djupdal/asd-amp/asd_pre_1/pcb/preamp.ods

Kjøpt | Antall | Reference | Value | Footprint | Note
x | 39 | C1 | 100n | Capacitors_SMD:C_0603_HandSoldering
x | 9 | C3 | 1u | Capacitors_SMD:C_0805_HandSoldering
x | 4 | C4 | 12p | Capacitors_SMD:C_0603_HandSoldering
x | 12 | C10 | 10u | Capacitors_SMD:C_0805_HandSoldering
x | 7 | C11 | 22u | Capacitors_SMD:C_0805_HandSoldering
x | 1 | C16 | 4.7n | Capacitors_SMD:C_0603_HandSoldering
x | 1 | C19 | 68n | Capacitors_SMD:C_0603_HandSoldering
x | 1 | C32 | 33u | Capacitors_SMD:C_1210_HandSoldering
x | 1 | C33 | 3.3u | Capacitors_SMD:C_0805_HandSoldering
x | 4 | C34 | 1n | Capacitors_SMD:C_0603_HandSoldering | NP0
x | 4 | C38 | 390p | Capacitors_SMD:C_0603_HandSoldering | NP0
x | 2 | C42 | 2.2n | Capacitors_SMD:C_0603_HandSoldering | NP0
x | 2 | C47 | 6.8n | Capacitors_SMD:C_0603_HandSoldering | 10%
x | 10 | C49 | 10n | Capacitors_SMD:C_0603_HandSoldering
x | 2 | C56 | 1n | Capacitors_SMD:C_0603_HandSoldering
x | 1 | C60 | 330u | Capacitors_Tantalum_SMD:TantalC_SizeD_EIA-7343_HandSoldering
x | 5 | C61 | 100u | Capacitors_Tantalum_SMD:TantalC_SizeB_EIA-3528_HandSoldering
x | 4 | C62 | 47u | Capacitors_SMD:C_1210_HandSoldering
x | 12 | C65 | 4.7u | Capacitors_SMD:C_0805_HandSoldering
x | 21 | C66 | 470n | Capacitors_SMD:C_0603_HandSoldering
x | 2 | C98 | 22p | Capacitors_SMD:C_0603_HandSoldering
x | 1 | C105 | 3.3n | Capacitors_SMD:C_0603_HandSoldering
x | 2 | C107 | 330n | Capacitors_SMD:C_0603_HandSoldering
x | 4 | C131 | 470p | Capacitors_SMD:C_0603_HandSoldering | NP0
x | 2 | C135 | 2.7n | Capacitors_SMD:C_0603_HandSoldering | NP0
x | 3 | L1 | FERRITE BEAD | Resistors_SMD:R_0805_HandSoldering
x | 2 | L4 | 1.5u | pre:SPM3015 | Ip>2.8A
x | 1 | L6 | 2.2u | pre:SPM3015 | Ip>2.9A
x | 1 | P1 | MCU Debug | Pin_Headers:Pin_Header_Straight_2x10
x | 1 | P2 | Buttons | Pin_Headers:Pin_Header_Straight_2x04
x | 1 | P3 | Mute | Pin_Headers:Pin_Header_Straight_1x02
x | 1 | P4 | LEDs | Pin_Headers:Pin_Header_Straight_2x03
x | 1 | P5 | SD_Card_DM1 | pre:DM1AA-SF-PEJ
x | 1 | P6 | Volume | Pin_Headers:Pin_Header_Straight_1x03
x | 1 | P7 | SPDIF | pre:RCA
x | 1 | P8 | TOSLINK | pre:PLR135T
x | 1 | P11 | RJ45-MAGJACK | pre:08B0-1D1T-06-F
x | 1 | P12 | FPGA Debug | pre:FPGA_debug
x | 1 | P13 | PwGnd | pa:Terminal_Block_3_5mm | +15VGnd-15V
x | 4 | P15 | LIN | pa:Terminal_Block_2_2.5mm
x | 7 | R1 | 4.7k | Resistors_SMD:R_0805_HandSoldering
x | 7 | R3 | 10k | Resistors_SMD:R_0805_HandSoldering
x | 7 | R8 | 91 | Resistors_SMD:R_0805_HandSoldering
x | 6 | R10 | 47k | Resistors_SMD:R_0805_HandSoldering
x | 4 | R13 | 22 | Resistors_SMD:R_0805_HandSoldering
x | 1 | R19 | 75 | Resistors_SMD:R_0805_HandSoldering
x | 1 | R21 | 680 | Resistors_SMD:R_0805_HandSoldering
x | 4 | R23 | 1.96k | Resistors_SMD:R_0805_HandSoldering
x | 4 | R27 | 2.15k | Resistors_SMD:R_0805_HandSoldering
x | 4 | R29 | 953 | Resistors_SMD:R_0805_HandSoldering
x | 2 | R35 | 549 | Resistors_SMD:R_0805_HandSoldering
x | 7 | R37 | 100k | Resistors_SMD:R_0805_HandSoldering
x | 1 | R38 | 12.4k | Resistors_SMD:R_0805_HandSoldering | 1%
x | 4 | R39 | 49.9 | Resistors_SMD:R_0805_HandSoldering | 1%
x | 1 | R43 | 10 | Resistors_SMD:R_0805_HandSoldering | 1% 1/12W
x | 2 | R44 | 180 | Resistors_SMD:R_0805_HandSoldering
x | 1 | R50 | 330 | Resistors_SMD:R_0805_HandSoldering
x | 1 | R52 | 30.1k | Resistors_SMD:R_0805_HandSoldering | 1%
x | 3 | R53 | 22.1k | Resistors_SMD:R_0805_HandSoldering | 1%
x | 1 | R54 | 6.81k | Resistors_SMD:R_0805_HandSoldering | 1%
x | 1 | R58 | 73.2k | Resistors_SMD:R_0805_HandSoldering | 1%
x | 4 | R60 | 3.3k | Resistors_SMD:R_0805_HandSoldering
x | 6 | R68 | 634 | Resistors_SMD:R_0805_HandSoldering
x | 1 | T1 | S22083 | pre:S22083
x | 1 | U1 | EFM32GG232F1024 | pre:QFP64
x | 1 | U2 | MAX3280E | pre:SOT-23-5
x | 1 | U3 | DIR9001 | Housings_SSOP:TSSOP-28_4.4x9.7mm_Pitch0.65mm
x | 1 | U4 | CS4398 | Housings_SSOP:TSSOP-28_4.4x9.7mm_Pitch0.65mm
x | 3 | U5 | LM4562 | SMD_Packages:SOIC-8-W
x | 1 | U6 | ENC424J600 | Housings_QFP:TQFP-44_10x10mm_Pitch0.8mm
x | 1 | U7 | N25Q128A | Housings_SOIC:SOIJ-8_5.3x5.3mm_Pitch1.27mm
x | 1 | U8 | oscillator | pre:OSC_SMD | 11.2896MHz
x | 1 | U9 | xc7a100tftg256 | pre:FTG256
x | 1 | U10 | LM2937-12 | pre:SOT-223
x | 1 | U11 | L79L12 | Housings_SOT-89:SOT89-3_Housing_Handsoldering
x | 1 | U12 | TPS54325 | pre:TSSOP-14_4.4x5mm_Pitch0.65mm_exposed_pad
x | 1 | U13 | TPS54294 | Housings_SSOP:TSSOP-16-1EP_4.4x5mm_Pitch0.65mm
x | 1 | U14 | L78L05 | Housings_SOT-89:SOT89-3_Housing_Handsoldering
x | 2 | U17 | SD103ASDM | pre:SOT-26-6
x | 1 | U19 | cs5361 | Housings_SSOP:TSSOP-24_4.4x7.8mm_Pitch0.65mm
x | 1 | X1 | 48MHz | pre:XTAL_SMD
x | 1 | X2 | 25MHz | pre:XTAL_SMD
