djupdal/asd-amp/asd_pa_1/poweramp.pdf

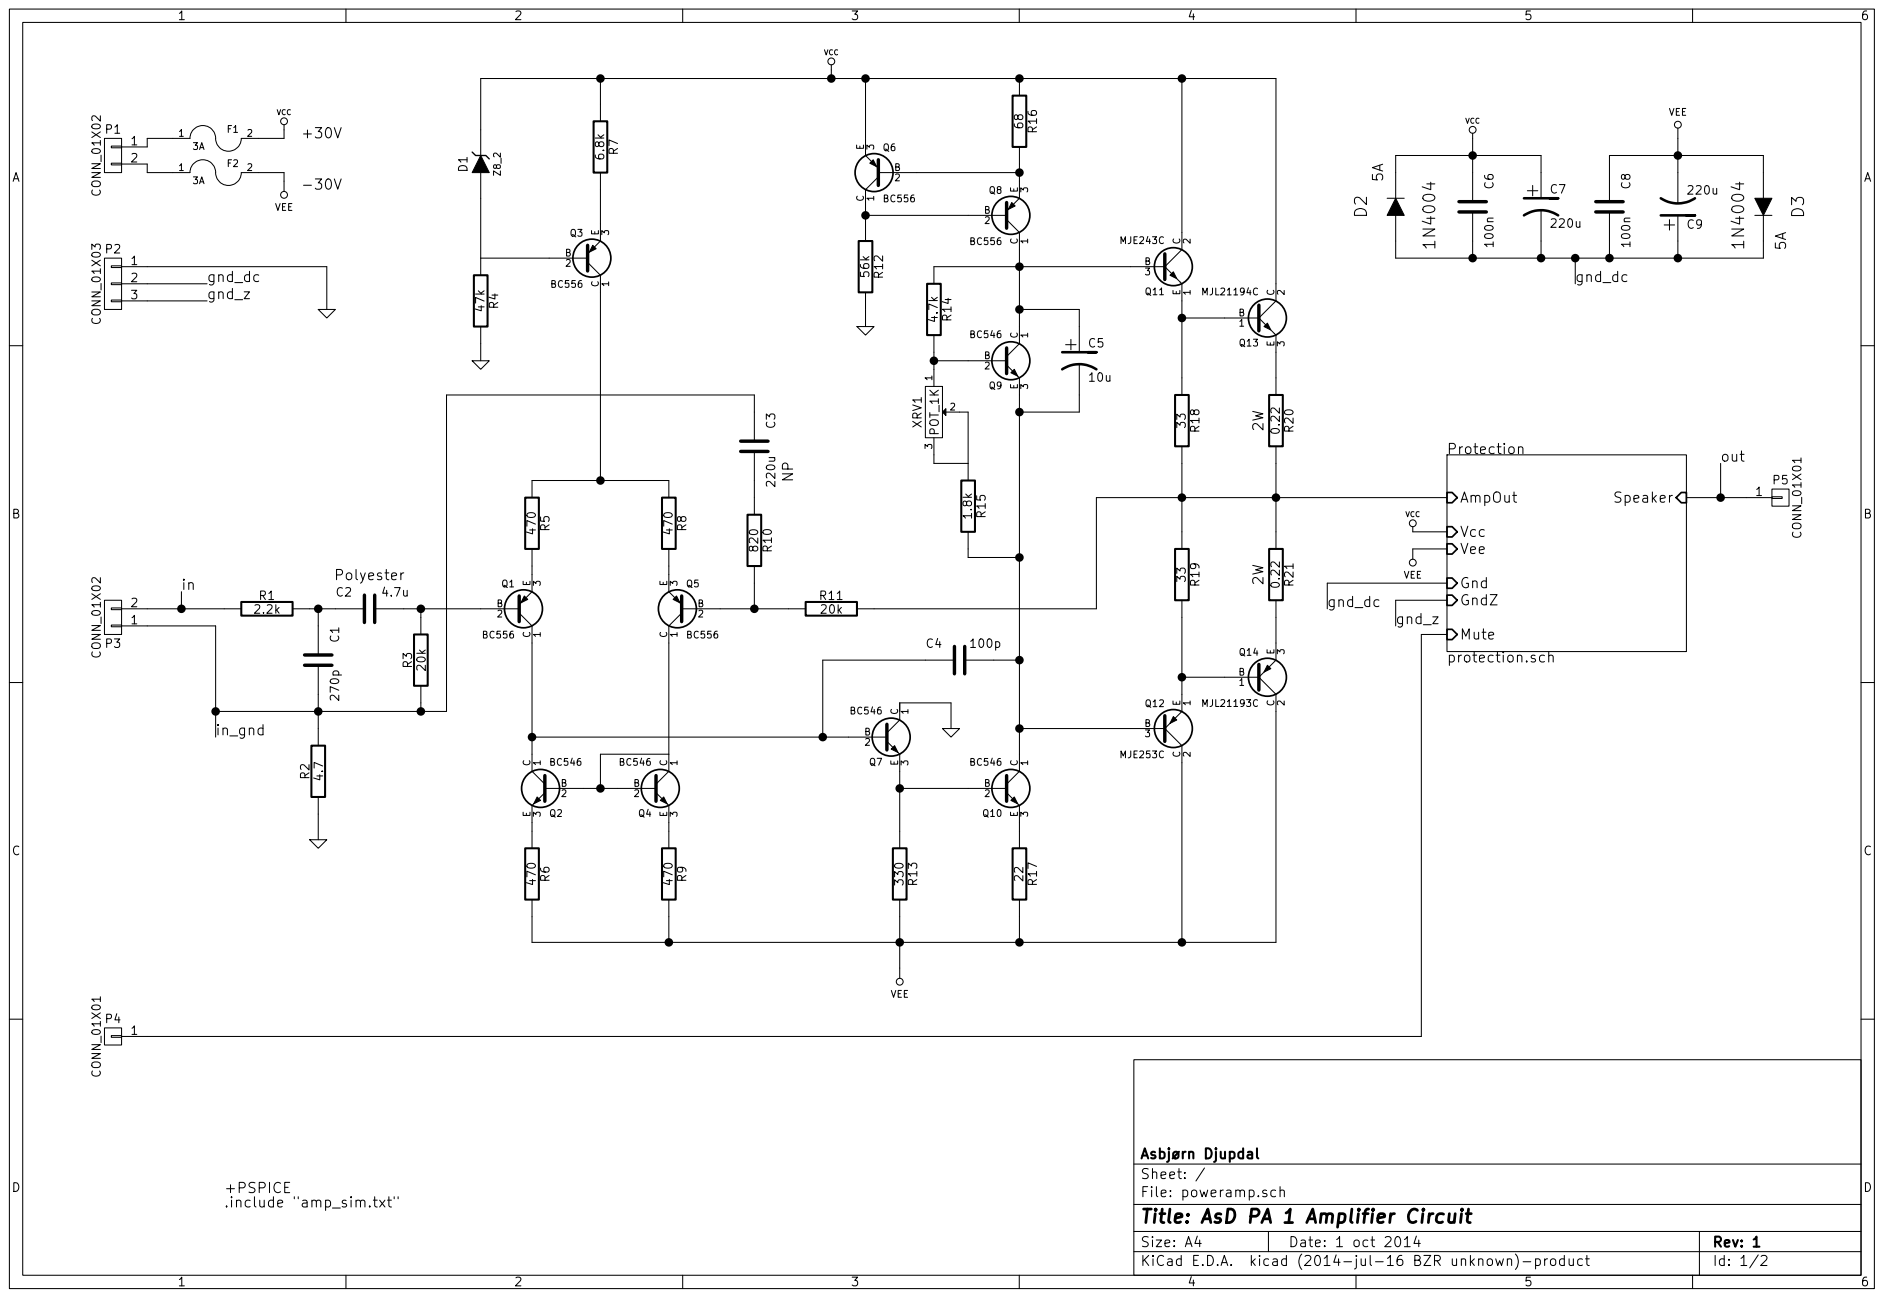
[picture p1: page 1]

File: poweramp.sch Sheet: / Asbjørn Djupdal

Id: 1/2 Title: AsD PA 1 Amplifier Circuit

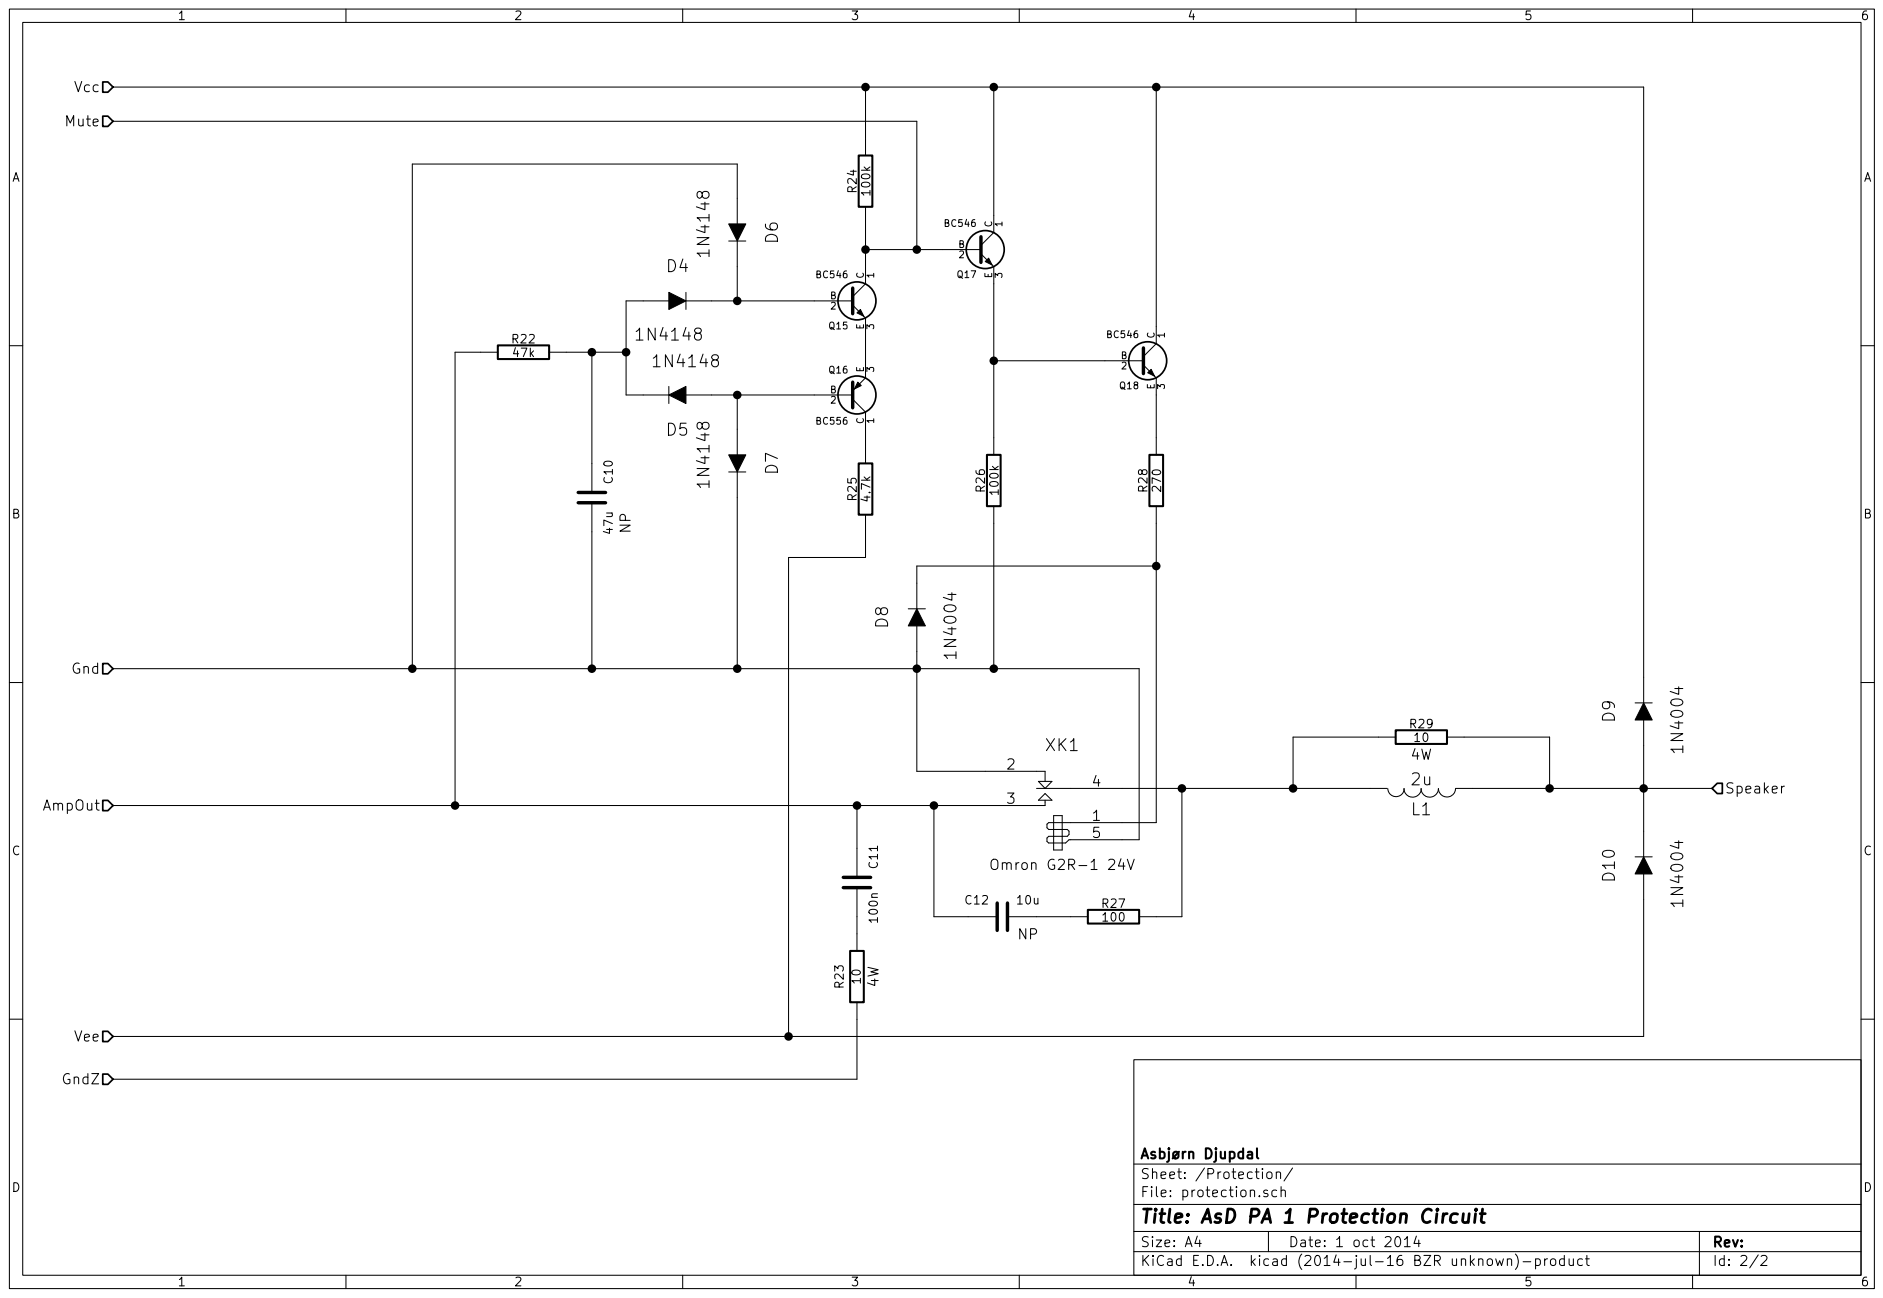
[picture p2: page 2]

Id: 2/2 Title: AsD PA 1 Protection Circuit
