djupdal/asd-amp/asd_pre_1/pcb/preamp.pdf

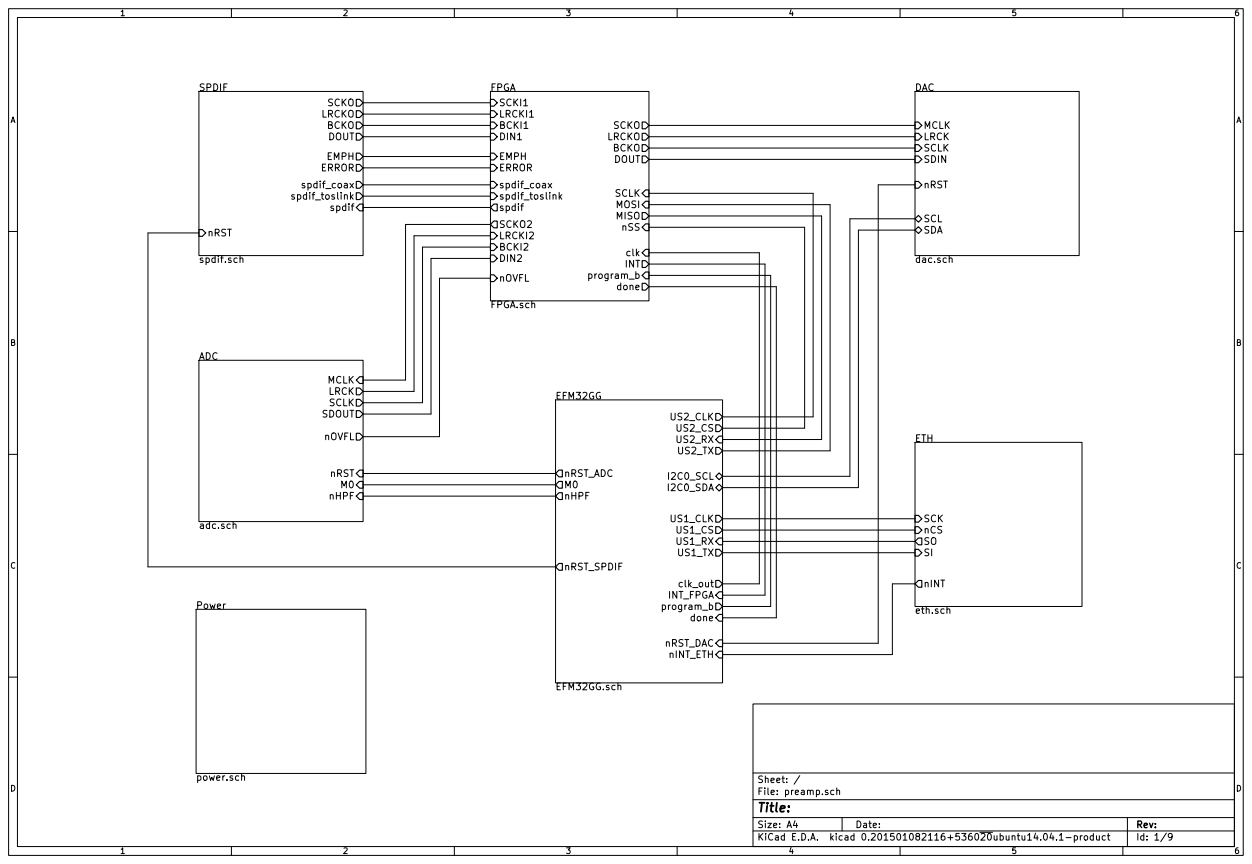
[picture p3: page 1]

File: preamp.sch Sheet: / EFM32GG

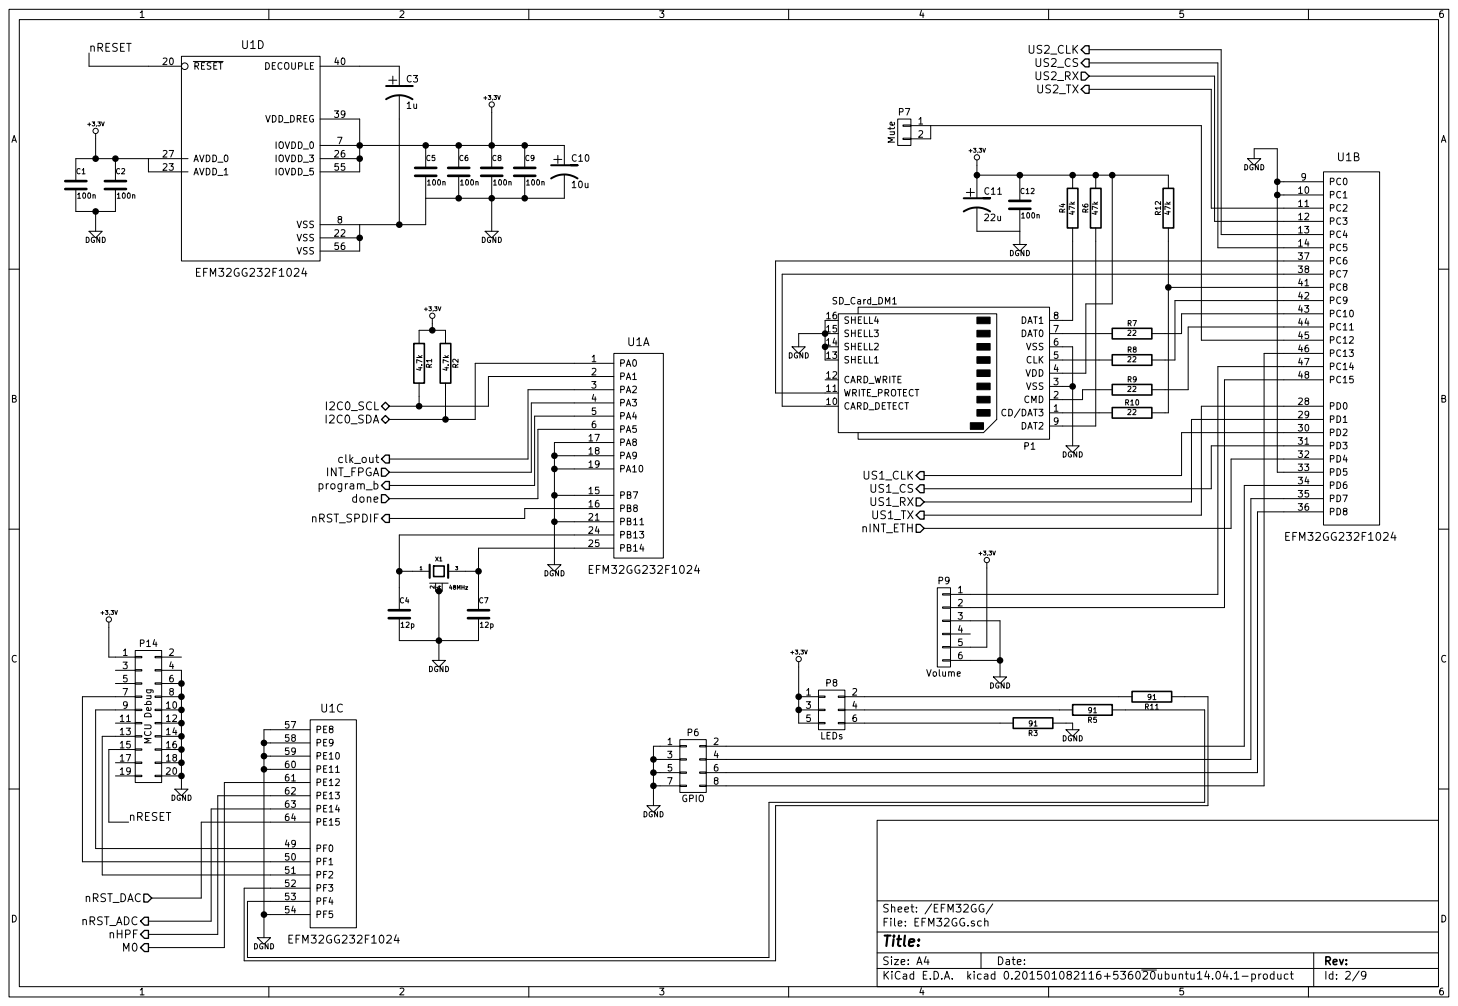
[picture p4: page 2]

9 | 10
11 | 12

Id: 2/9 Title: File: EFM32GG.sch Sheet: /EFM32GG/

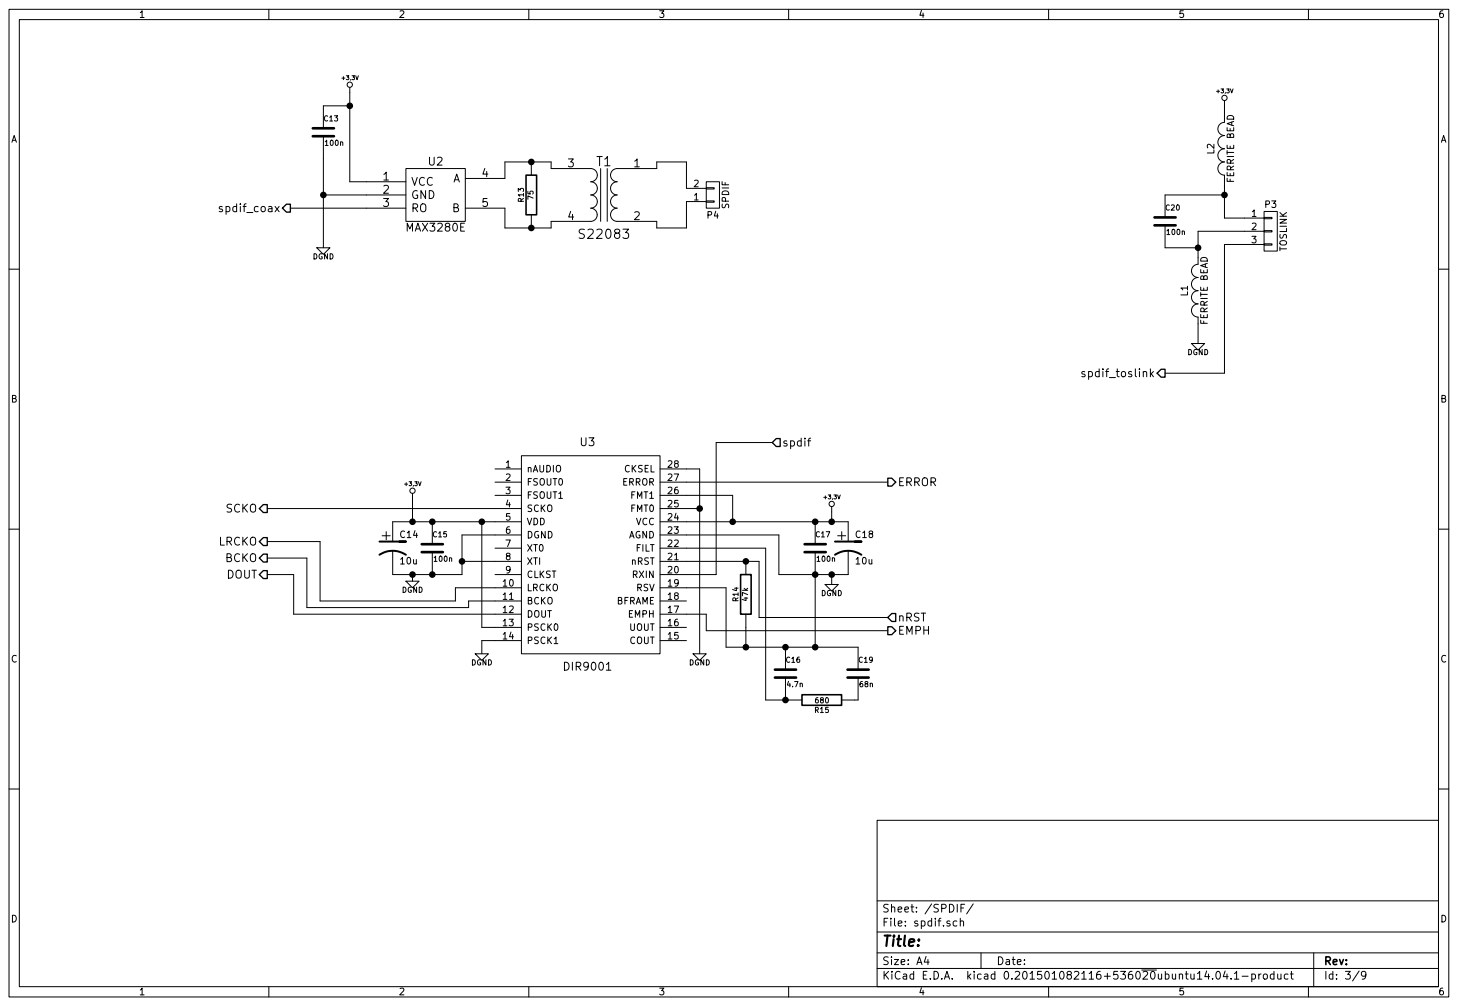
[picture p5: page 3]

File: spdif.sch Sheet: /SPDIF/
Id: 3/9 Title:

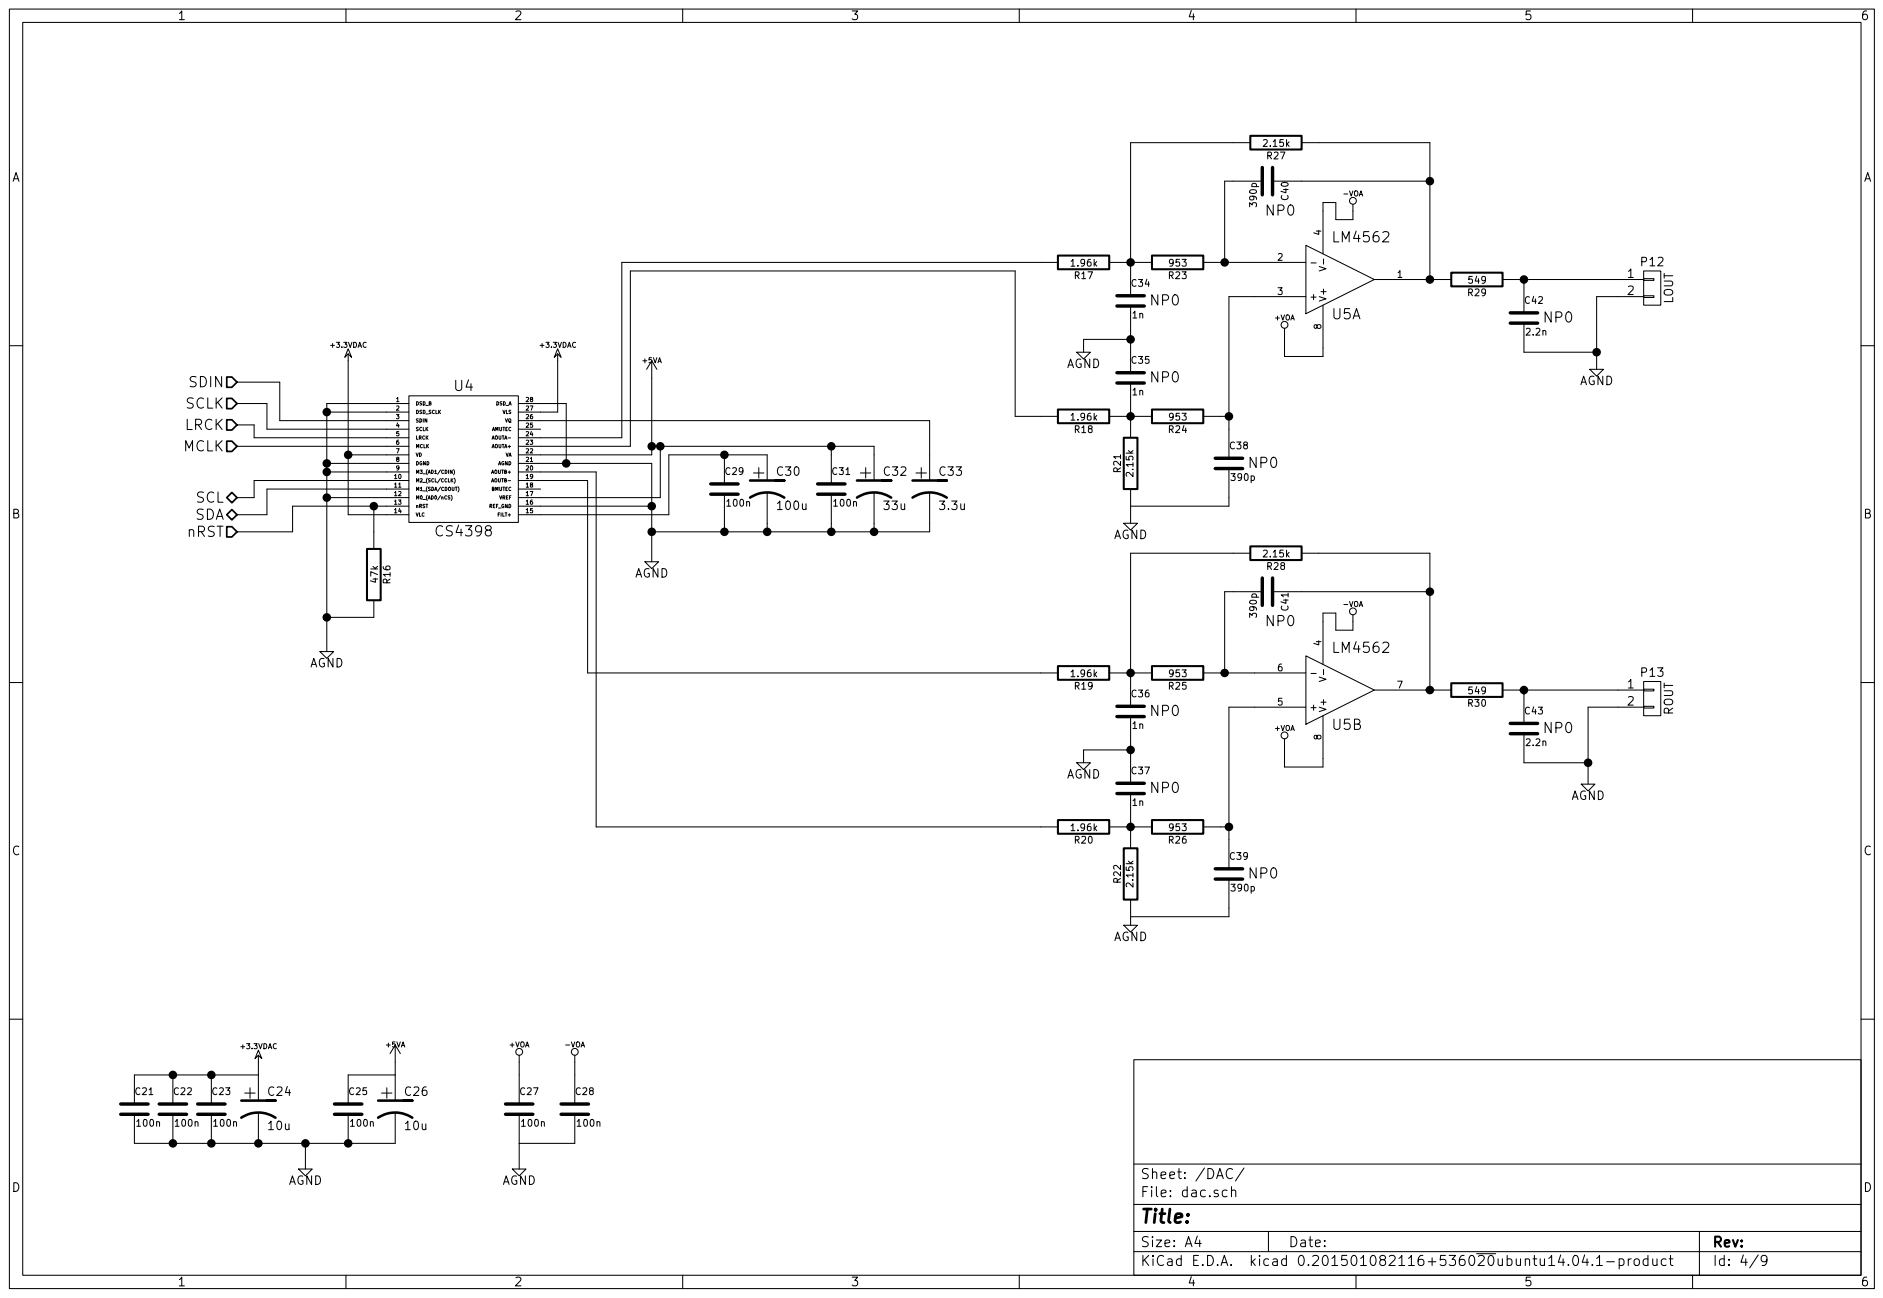
[picture p6: page 4]

Id: 4/9 Title: File: dac.sch Sheet: /DAC/

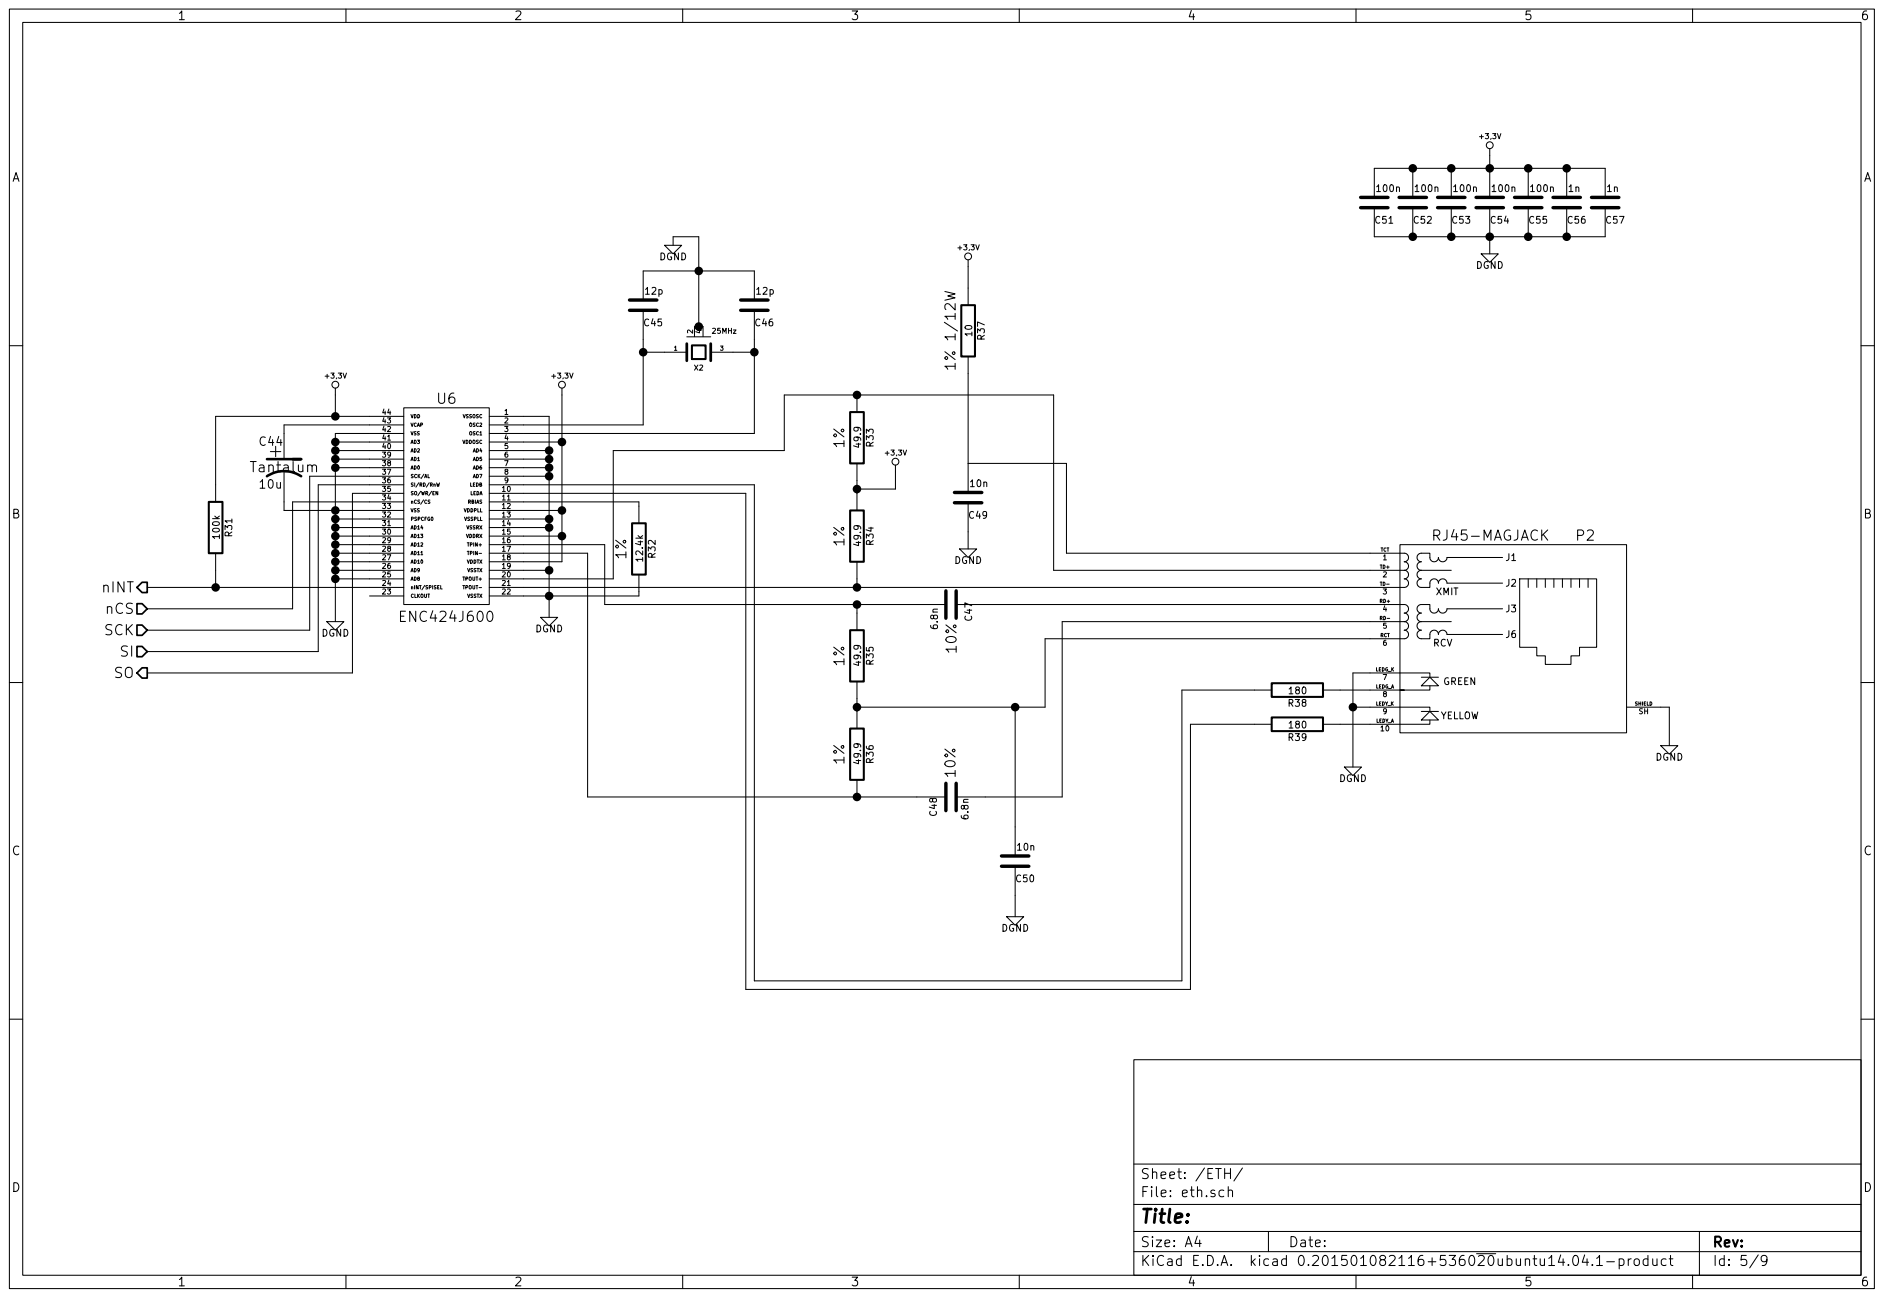
[picture p7: page 5]

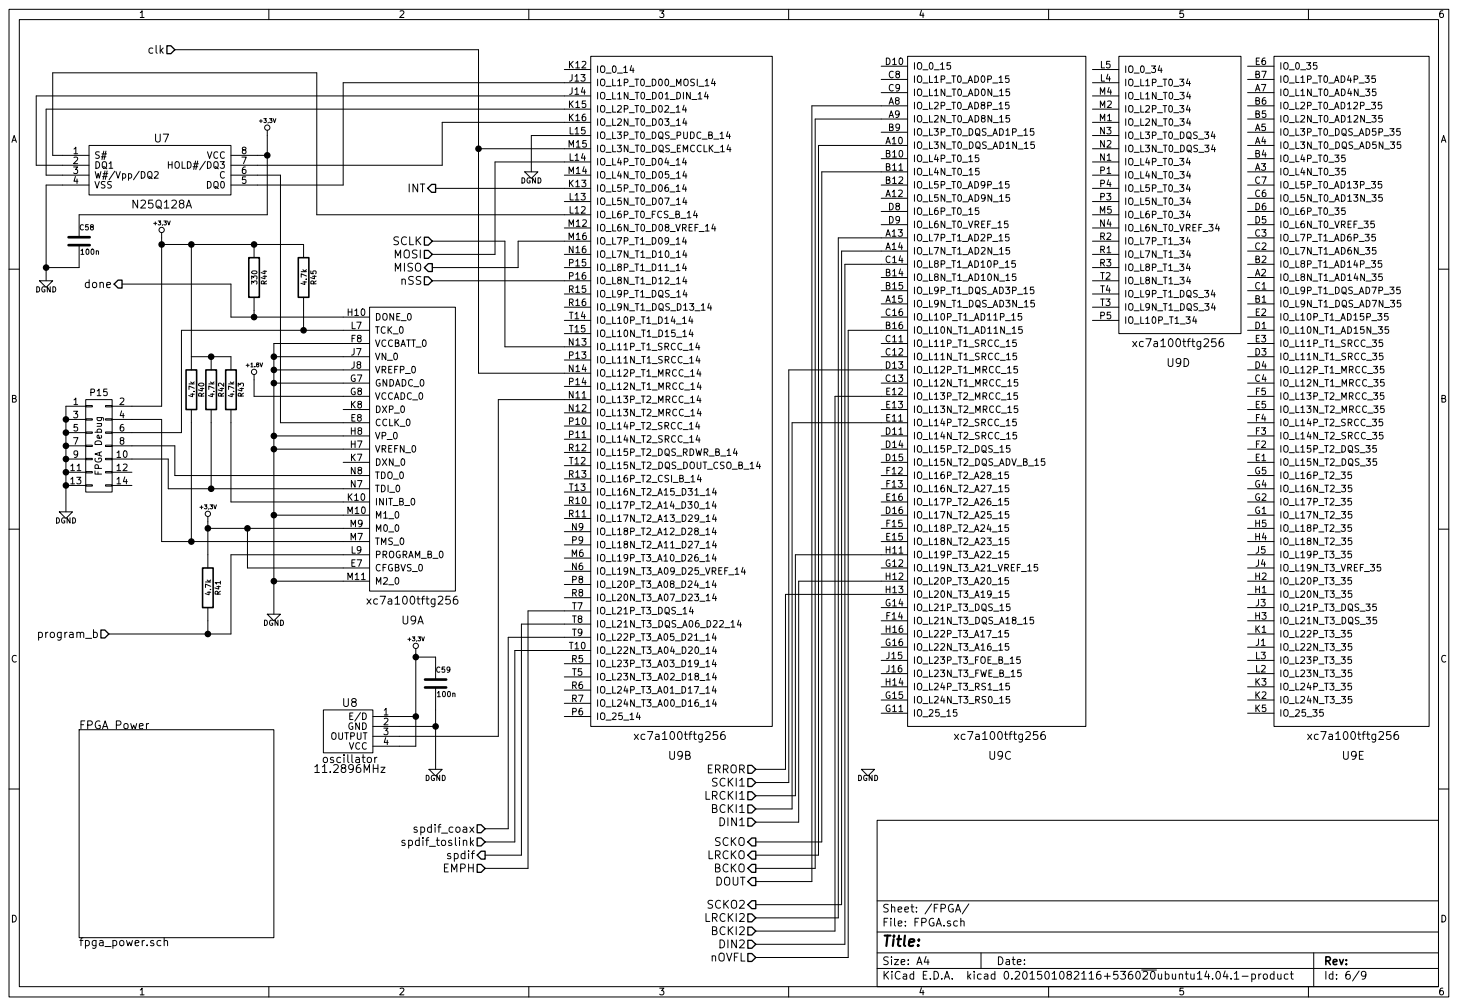
[picture p8: page 6]

IO_L11P_T1_SRCC_15 C11 | IO_L11P_T1_SRCC_35 E3

IO_L12P_T1_MRCC_15 D13 | IO_L12P_T1_MRCC_35 D4

IO_L13P_T2_MRCC_15 E12 | IO_L13P_T2_MRCC_35 F5

IO_L14P_T2_SRCC_15 E11 | IO_L14P_T2_SRCC_35 F4
IO_L14N_T2_SRCC_15 D11 | IO_L14N_T2_SRCC_35 F3

IO_L15N_T2_DQS_ADV_B_15 D15 | IO_L15N_T2_DQS_35 E1
IO_L16P_T2_A28_15 F12 | IO_L16P_T2_35 G5
IO_L16N_T2_A27_15 F13 | IO_L16N_T2_35 G4
IO_L17P_T2_A26_15 E16 | IO_L17P_T2_35 G2
IO_L17N_T2_A25_15 D16 | IO_L17N_T2_35 G1
IO_L18P_T2_A24_15 F15 | IO_L18P_T2_35 H5

IO_L19P_T3_A22_15 H11 | IO_L19P_T3_35 J5
IO_L19N_T3_A21_VREF_15 G12 | IO_L19N_T3_VREF_35 J4
IO_L20P_T3_A20_15 H12 | IO_L20P_T3_35 H2

IO_L21P_T3_DQS_15 G14 | IO_L21P_T3_DQS_35 J3

IO_L24P_T3_RS1_15 H14 | IO_L24P_T3_35 K3
IO_L24N_T3_RS0_15 G15 | IO_L24N_T3_35 K2
IO_25_15 G11 | IO_25_35 K5

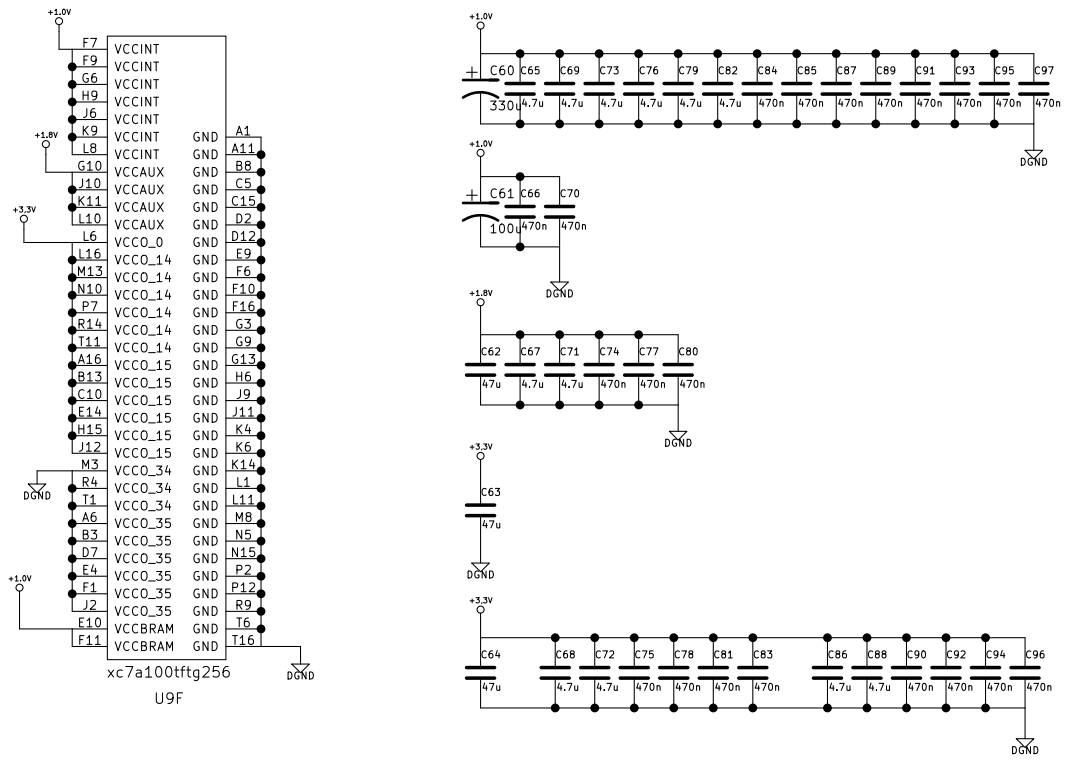
[picture p9: page 7]

File: fpga_power.sch Sheet: /FPGA/FPGA Power/

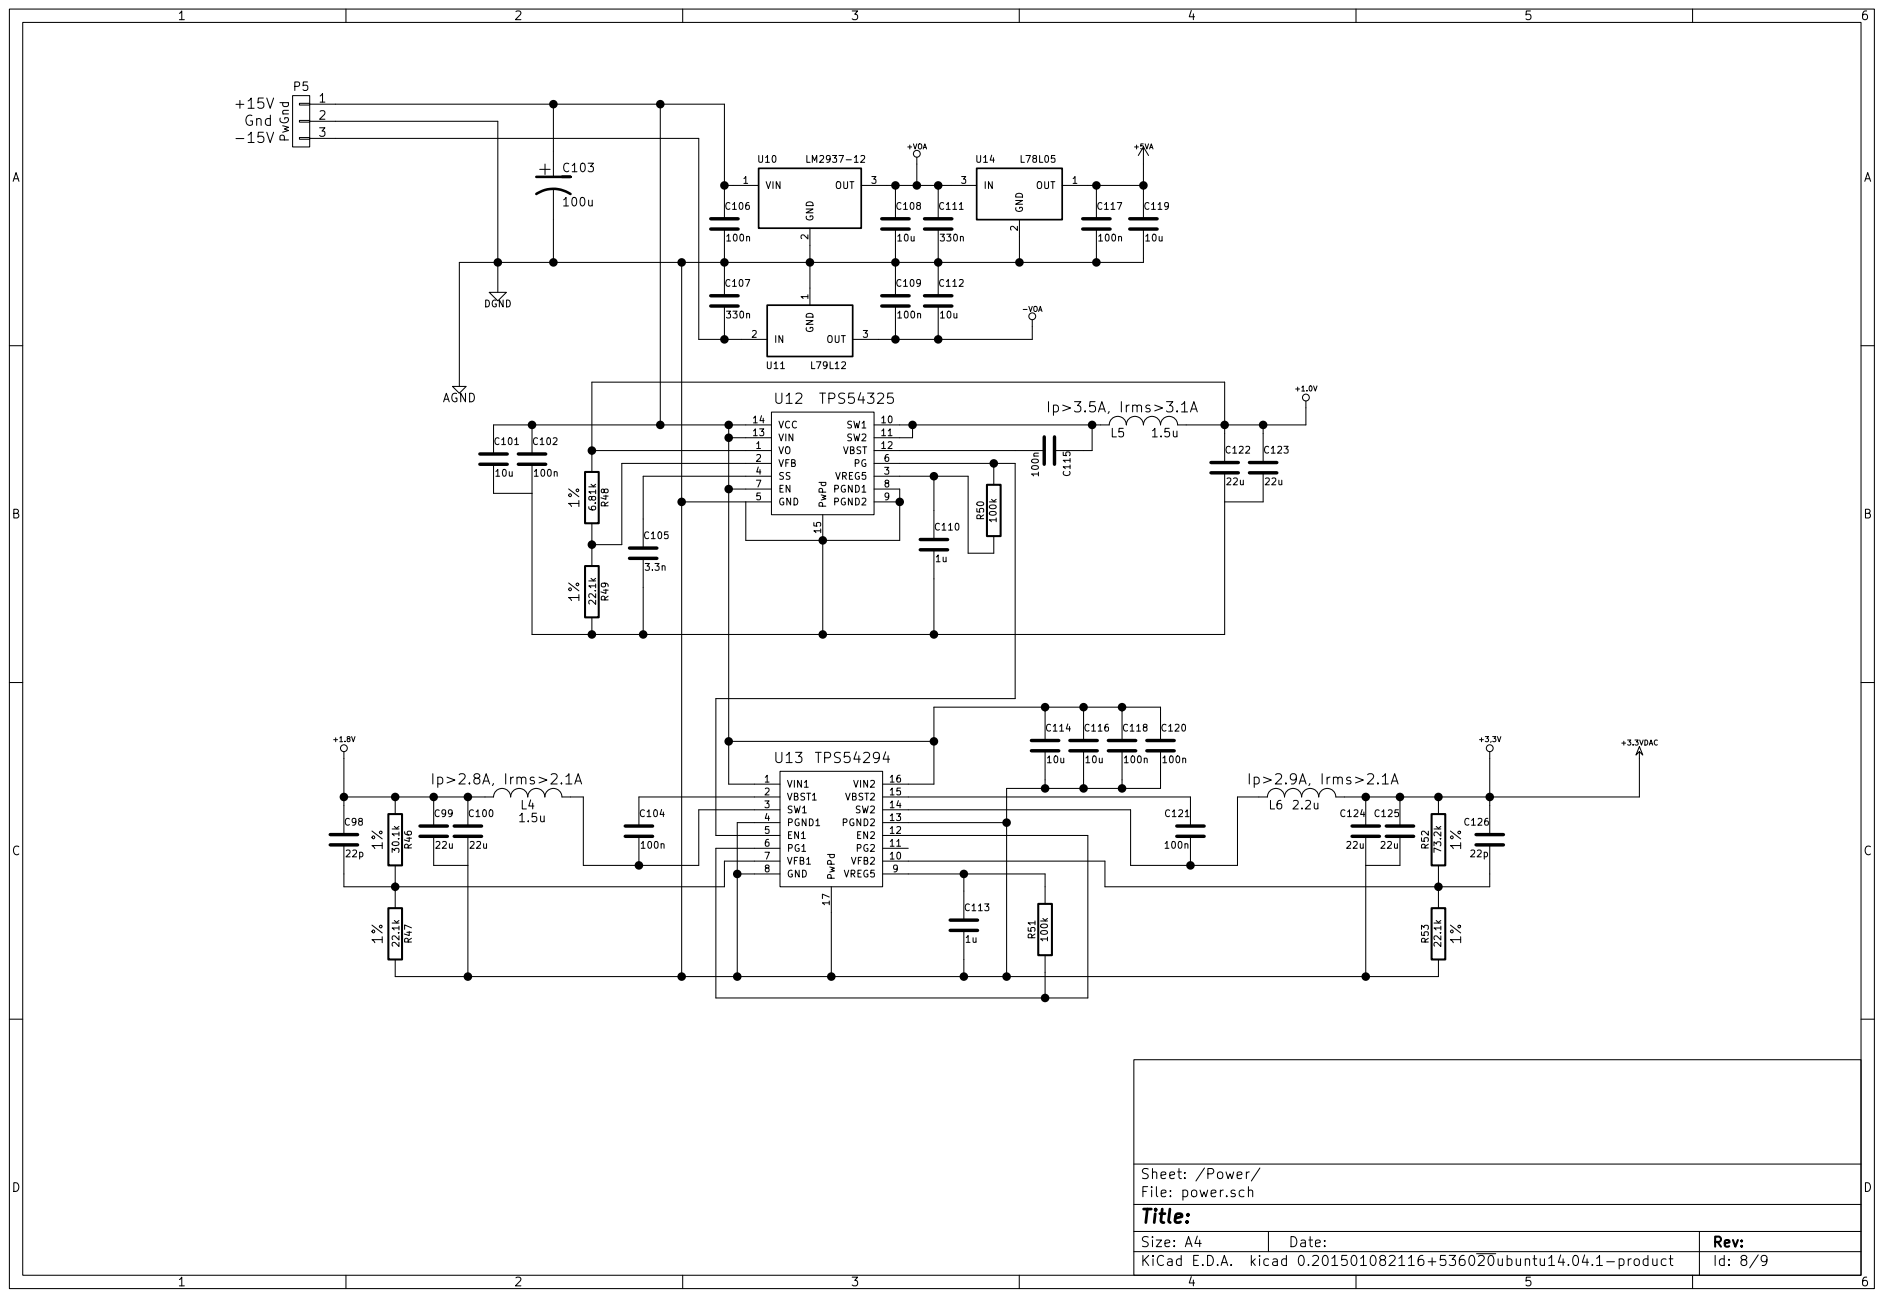
[picture p10: page 8]

2 OUT 3 U10 LM2937-12 VO 1 VFB 2 VREG5 3 SS 4 GND 5 PG 6 EN 7 PGND1 8 PGND2 9 SW1 10 SW2 11 VBST 12 VIN 13 VCC 14 PwPd 15 U12 TPS54325

File: power.sch Sheet: /Power/
Id: 8/9 Title:

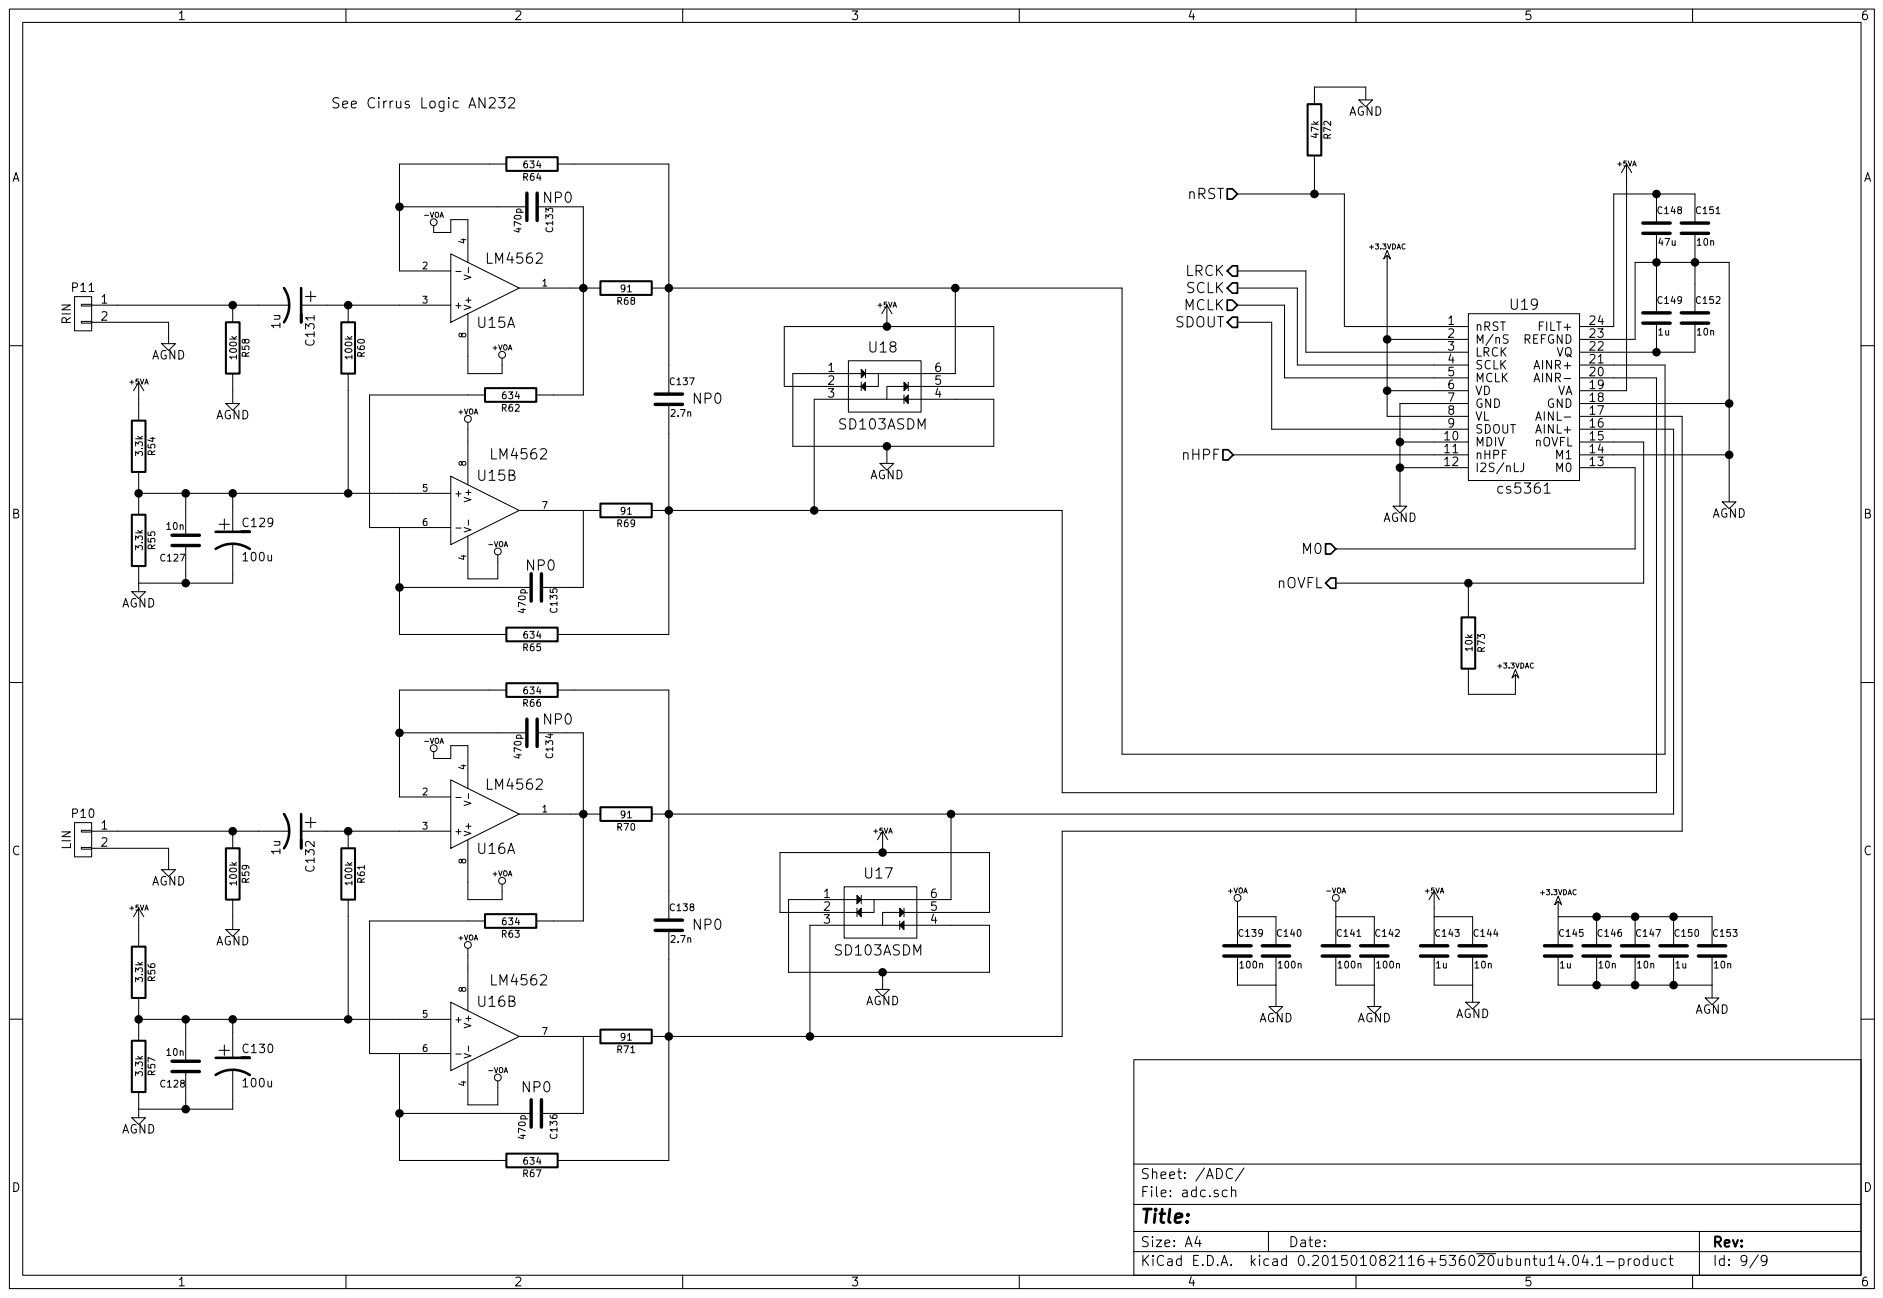
[picture p11: page 9]

Id: 9/9 Title: File: adc.sch Sheet: /ADC/
