djupdal/asd-amp/asd_pa_1/poweramp-Protection.pdf

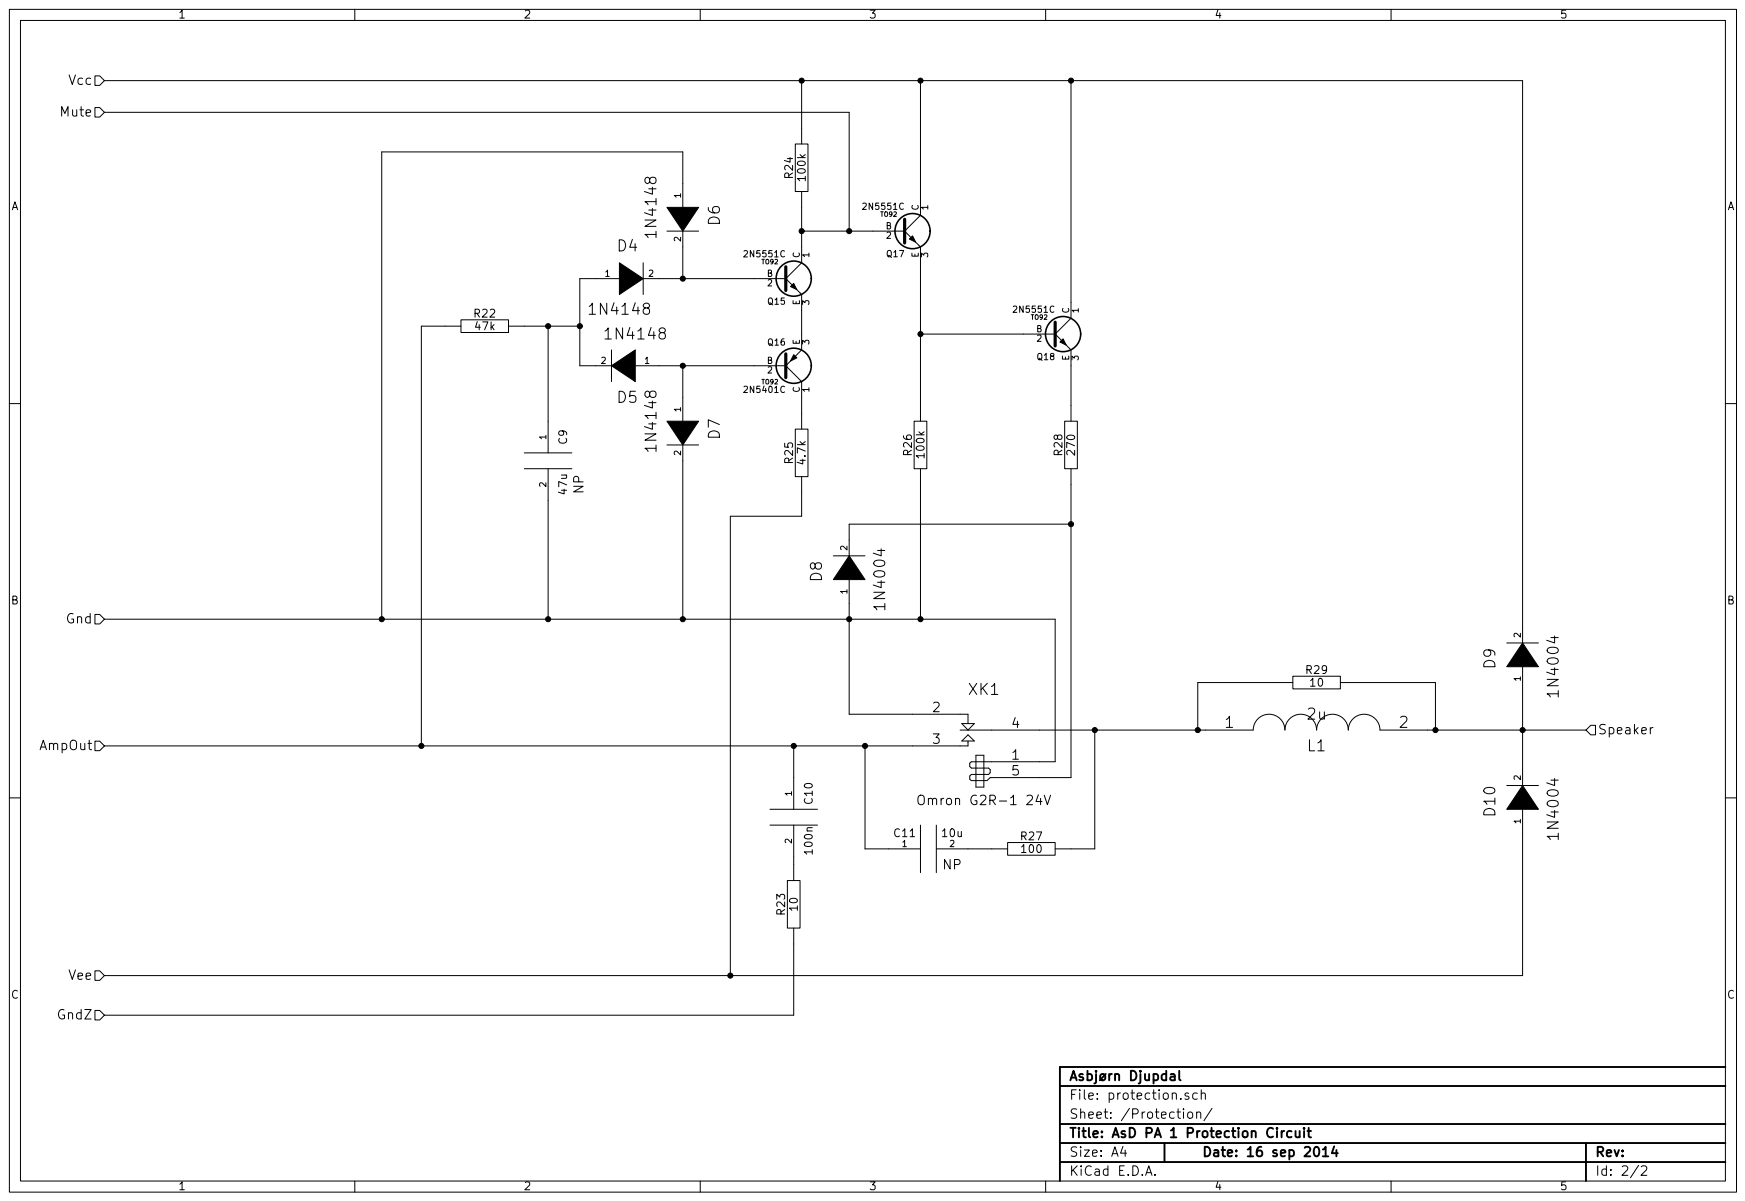
[picture p12: page 1]
