djupdal/asd-amp/asd_pre_1/pcb/preamp.kicad_pcb

## KiCad design asd_pre_1/pcb/preamp.kicad_pcb (2017-04-02)

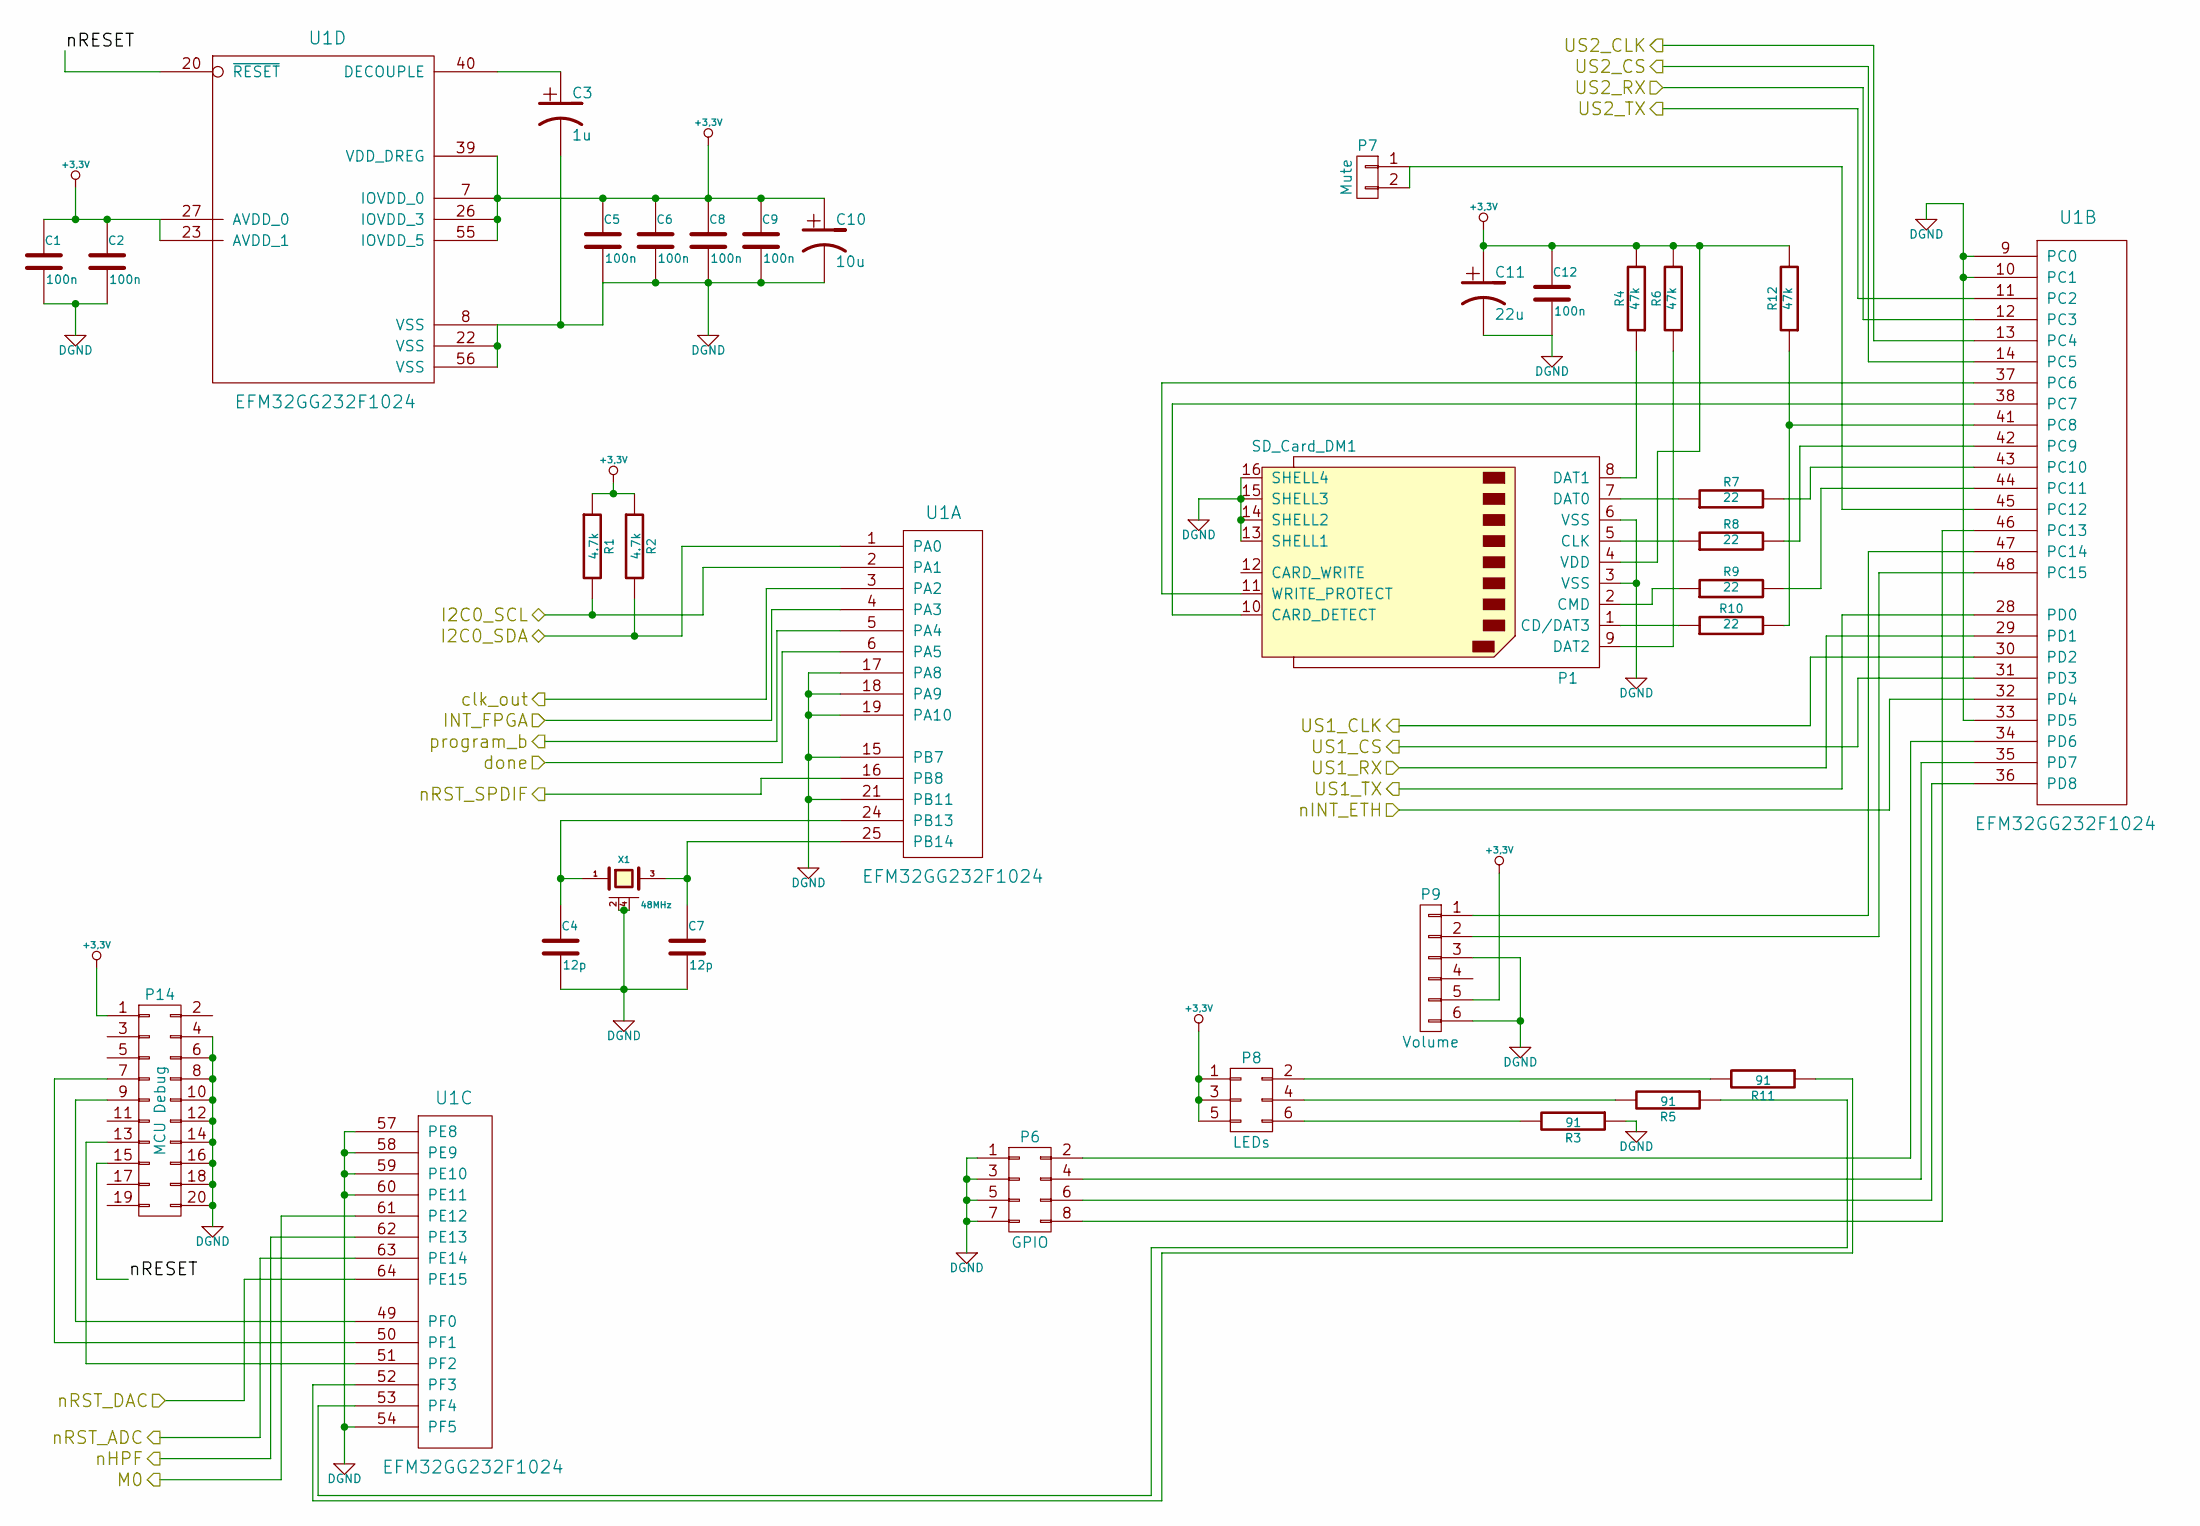
[picture p13: schematic EFM32GG.sch, AsD Pre 1 Digital Preamplifier -- MCU]

Parts:
C1, C2, C5, C6, C8, C9, C12: 100n; C_0603_HandSoldering
C3: 1u; C_0805_HandSoldering
C4, C7: 12p; C_0603_HandSoldering
C10: 10u; C_0805_HandSoldering
C11: 22u; C_0805_HandSoldering
P1: SD_Card_DM1; DM1AA-SF-PEJ
P6: GPIO; Pin_Header_Straight_2x04
P7: Mute; Pin_Header_Straight_1x02
P8: LEDs; Pin_Header_Straight_2x03
P9: Volume; Pin_Header_Straight_2x03
P14: MCU Debug; Pin_Header_Straight_2x10
R1, R2: 4.7k; R_0805_HandSoldering
R3, R5, R11: 91; R_0805_HandSoldering
R4, R6, R12: 47k; R_0805_HandSoldering
R7, R8, R9, R10: 22; R_0805_HandSoldering
U1: EFM32GG232F1024; QFP64
X1: 48MHz; XTAL_SMD

Connections:
+3.3V: C1.1, C2.1, C5.1, C6.1, C8.1, C9.1, C10.1, C11.1, C12.1, P1.4 (VDD), P8.1, P8.3, P8.5, P9.5, P14.1, R1.1, R2.1, R4.2, R6.2, R12.2, U1.7 (IOVDD_0), U1.23 (AVDD_1), U1.26 (IOVDD_3), U1.27 (AVDD_0), U1.39 (VDD_DREG), U1.55 (IOVDD_5); also elsewhere on the board
/ADC/M0: U1.61 (PE12); also elsewhere on the board
/ADC/nHPF: U1.62 (PE13); also elsewhere on the board
/ADC/nRST: U1.63 (PE14); also elsewhere on the board
/DAC/nRST: U1.64 (PE15); also elsewhere on the board
/EFM32GG/I2C0_SCL: R1.2, U1.2 (PA1); also elsewhere on the board
/EFM32GG/I2C0_SDA: R2.2, U1.1 (PA0); also elsewhere on the board
/EFM32GG/US1_CS: U1.31 (PD3); also elsewhere on the board
/EFM32GG/US2_CS: U1.14 (PC5); also elsewhere on the board
/EFM32GG/done: U1.6 (PA5); also elsewhere on the board
/EFM32GG/nRESET: P14.15, U1.20 (~RESET~)
/EFM32GG/program_b: U1.5 (PA4); also elsewhere on the board
/ETH/SCK: U1.30 (PD2); also elsewhere on the board
/ETH/SI: U1.28 (PD0); also elsewhere on the board
/ETH/SO: U1.29 (PD1); also elsewhere on the board
/ETH/nINT: U1.32 (PD4); also elsewhere on the board
/FPGA/INT: U1.4 (PA3); also elsewhere on the board
/FPGA/MISO: U1.12 (PC3); also elsewhere on the board
/FPGA/MOSI: U1.11 (PC2); also elsewhere on the board
/FPGA/SCLK: U1.13 (PC4); also elsewhere on the board
/FPGA/clk: U1.3 (PA2); also elsewhere on the board
/SPDIF/nRST: U1.16 (PB8); also elsewhere on the board
DGND: C1.2, C2.2, C3.2, C4.2, C5.2, C6.2, C7.2, C8.2, C9.2, C10.2, C11.2, C12.2, P1.3 (VSS), P1.6 (VSS), P1.13 (SHELL1), P1.14 (SHELL2), P1.15 (SHELL3), P1.16 (SHELL4), P6.1, P6.3, P6.5, P6.7, P9.3, P9.6, P14.4, P14.6, P14.8, P14.10, P14.12, P14.14, P14.16, P14.18, P14.20, R3.1, U1.8 (VSS), U1.9 (PC0), U1.10 (PC1), U1.15 (PB7), U1.17 (PA8), U1.18 (PA9), U1.19 (PA10), U1.21 (PB11), U1.22 (VSS), U1.33 (PD5), U1.54 (PF5), U1.56 (VSS), U1.57 (PE8), U1.58 (PE9), U1.59 (PE10), U1.60 (PE11), X1.2 (GND), X1.4 (GND); also elsewhere on the board
unnamed: C3.1, U1.40 (DECOUPLE)
unnamed: C4.1, U1.24 (PB13), X1.1
unnamed: C7.1, U1.25 (PB14), X1.3
unnamed: P1.1 (CD/DAT3), R10.1
unnamed: P1.2 (CMD), R9.1
unnamed: P1.5 (CLK), R8.1
unnamed: P1.7 (DAT0), R7.1
unnamed: P1.8 (DAT1), R4.1
unnamed: P1.9 (DAT2), R6.1
unnamed: P1.10 (CARD_DETECT), U1.38 (PC7)
unnamed: P1.11 (WRITE_PROTECT), U1.37 (PC6)
unnamed: P6.2, U1.34 (PD6)
unnamed: P6.4, U1.35 (PD7)
unnamed: P6.6, U1.36 (PD8)
unnamed: P6.8, U1.46 (PC13)
unnamed: P7.1, P7.2, U1.45 (PC12)
unnamed: P8.2, R11.2
unnamed: P8.4, R5.2
unnamed: P8.6, R3.2
unnamed: P9.1, U1.47 (PC14)
unnamed: P9.2, U1.48 (PC15)
unnamed: P14.7, U1.50 (PF1)
unnamed: P14.9, U1.49 (PF0)
unnamed: P14.13, U1.51 (PF2)
unnamed: R5.1, U1.53 (PF4)
unnamed: R7.2, U1.43 (PC10)
unnamed: R8.2, U1.42 (PC9)
unnamed: R9.2, U1.44 (PC11)
unnamed: R10.2, R12.1, U1.41 (PC8)
unnamed: R11.1, U1.52 (PF3)

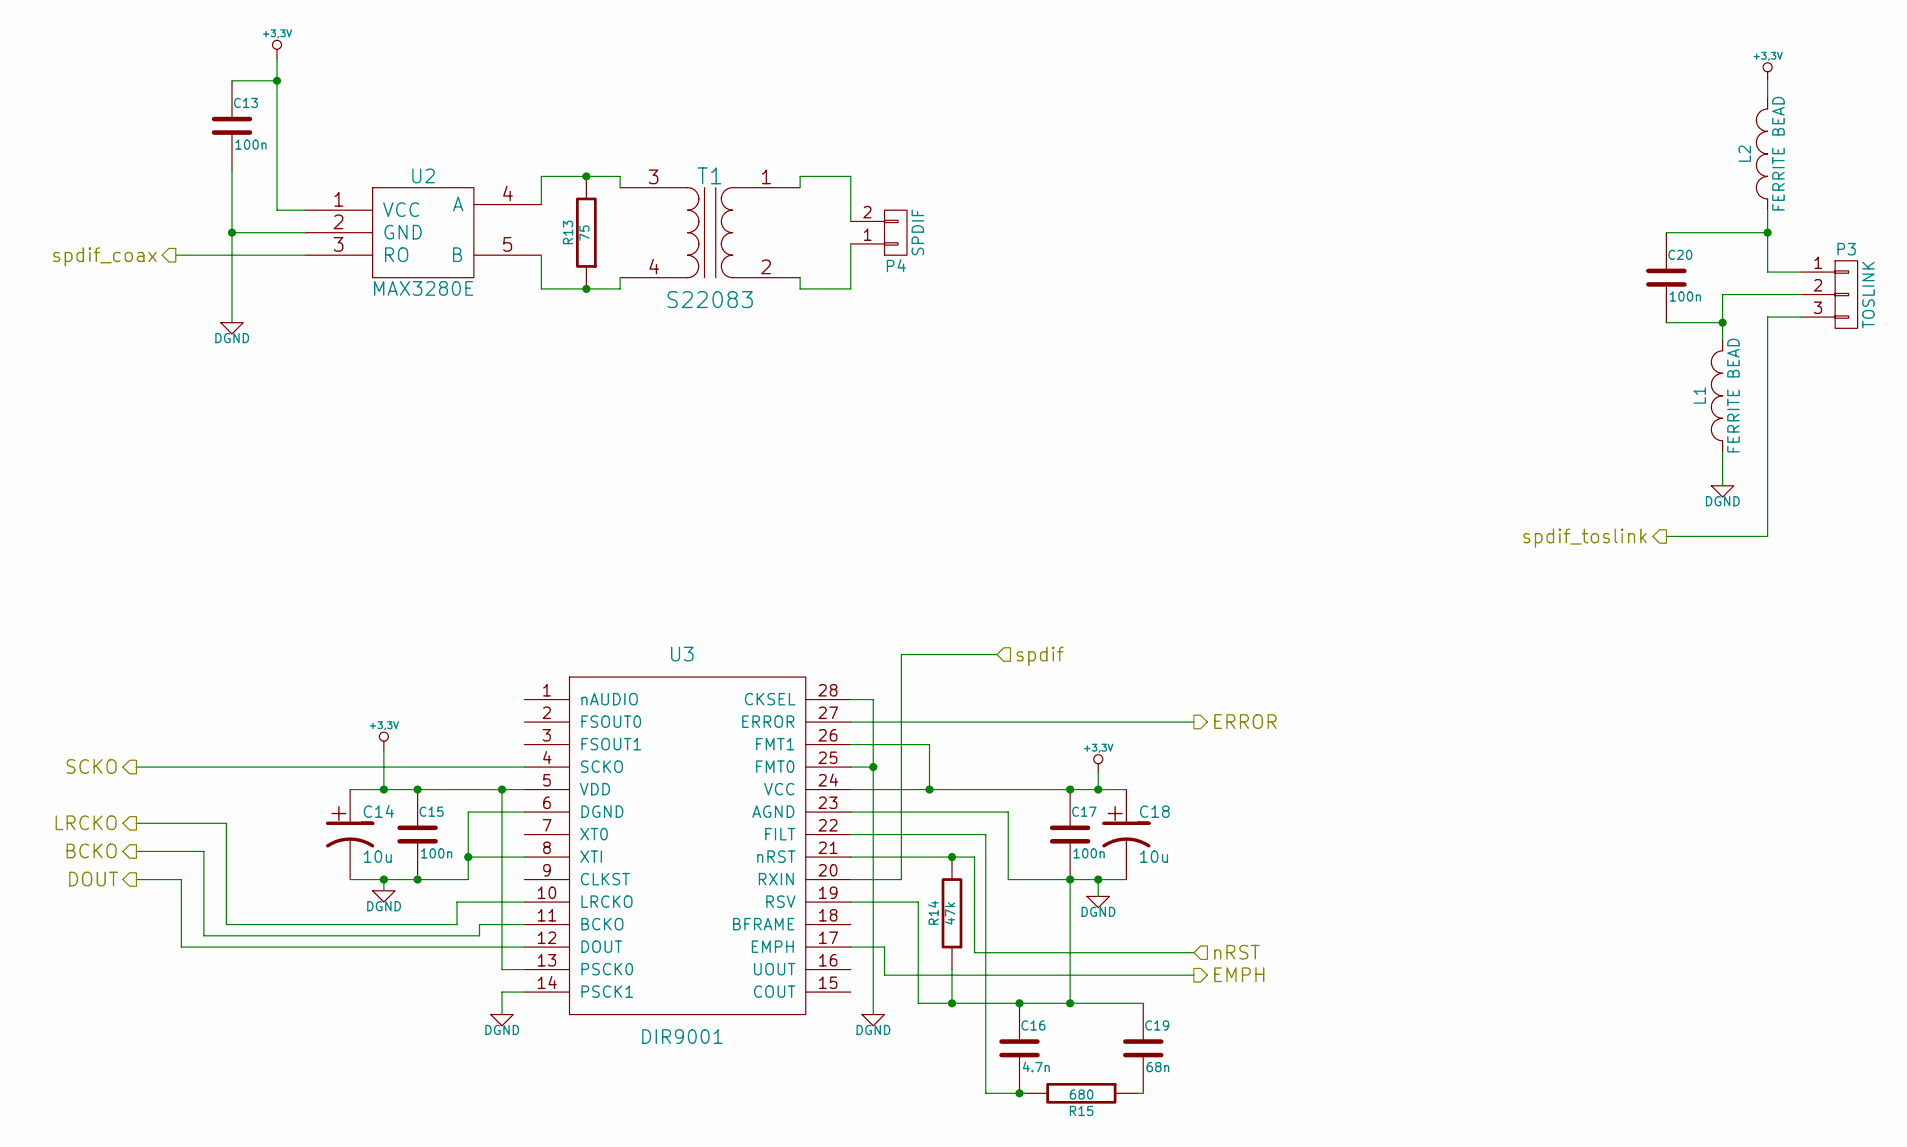
[picture p14: schematic spdif.sch, AsD Pre 1 Digital Preamplifier -- SPDIF]

Parts:
C13, C15, C17, C20: 100n; C_0603_HandSoldering
C14, C18: 10u; C_0805_HandSoldering
C16: 4.7n; C_0603_HandSoldering
C19: 68n; C_0603_HandSoldering
L1, L2: FERRITE BEAD; R_0805_HandSoldering
P3: TOSLINK; PLR135T
P4: SPDIF; RCA
R13: 75; R_0805_HandSoldering
R14: 47k; R_0805_HandSoldering
R15: 680; R_0805_HandSoldering
T1: S22083
U2: MAX3280E; SOT-23-5
U3: DIR9001; TSSOP-28_4.4x9.7mm_Pitch0.65mm

Connections:
+3.3V: C13.1, C14.1, C15.1, C17.1, C18.1, L2.2, U2.1 (VCC), U3.5 (VDD), U3.13 (PSCK0), U3.24 (VCC), U3.26 (FMT1); also elsewhere on the board
/FPGA/BCKI1: U3.11 (BCKO); also elsewhere on the board
/FPGA/DIN1: U3.12 (DOUT); also elsewhere on the board
/FPGA/EMPH: U3.17 (EMPH); also elsewhere on the board
/FPGA/ERROR: U3.27 (ERROR); also elsewhere on the board
/FPGA/LRCKI1: U3.10 (LRCKO); also elsewhere on the board
/FPGA/SCKI1: U3.4 (SCKO); also elsewhere on the board
/FPGA/spdif: U3.20 (RXIN); also elsewhere on the board
/FPGA/spdif_coax: U2.3 (RO); also elsewhere on the board
/FPGA/spdif_toslink: P3.3; also elsewhere on the board
/SPDIF/nRST: R14.2, U3.21 (nRST); also elsewhere on the board
DGND: C13.2, C14.2, C15.2, C16.1, C17.2, C18.2, C19.1, L1.1, R14.1, U2.2 (GND), U3.6 (DGND), U3.8 (XTI), U3.14 (PSCK1), U3.19 (RSV), U3.23 (AGND), U3.25 (FMT0), U3.28 (CKSEL); also elsewhere on the board
unnamed: C16.2, R15.2, U3.22 (FILT)
unnamed: C19.2, R15.1
unnamed: C20.1, L2.1, P3.1
unnamed: C20.2, L1.2, P3.2
unnamed: P4.1, T1.2 (AB)
unnamed: P4.2, T1.1 (AA)
unnamed: R13.1, T1.4 (SA), U2.5 (B)
unnamed: R13.2, T1.3 (SB), U2.4 (A)

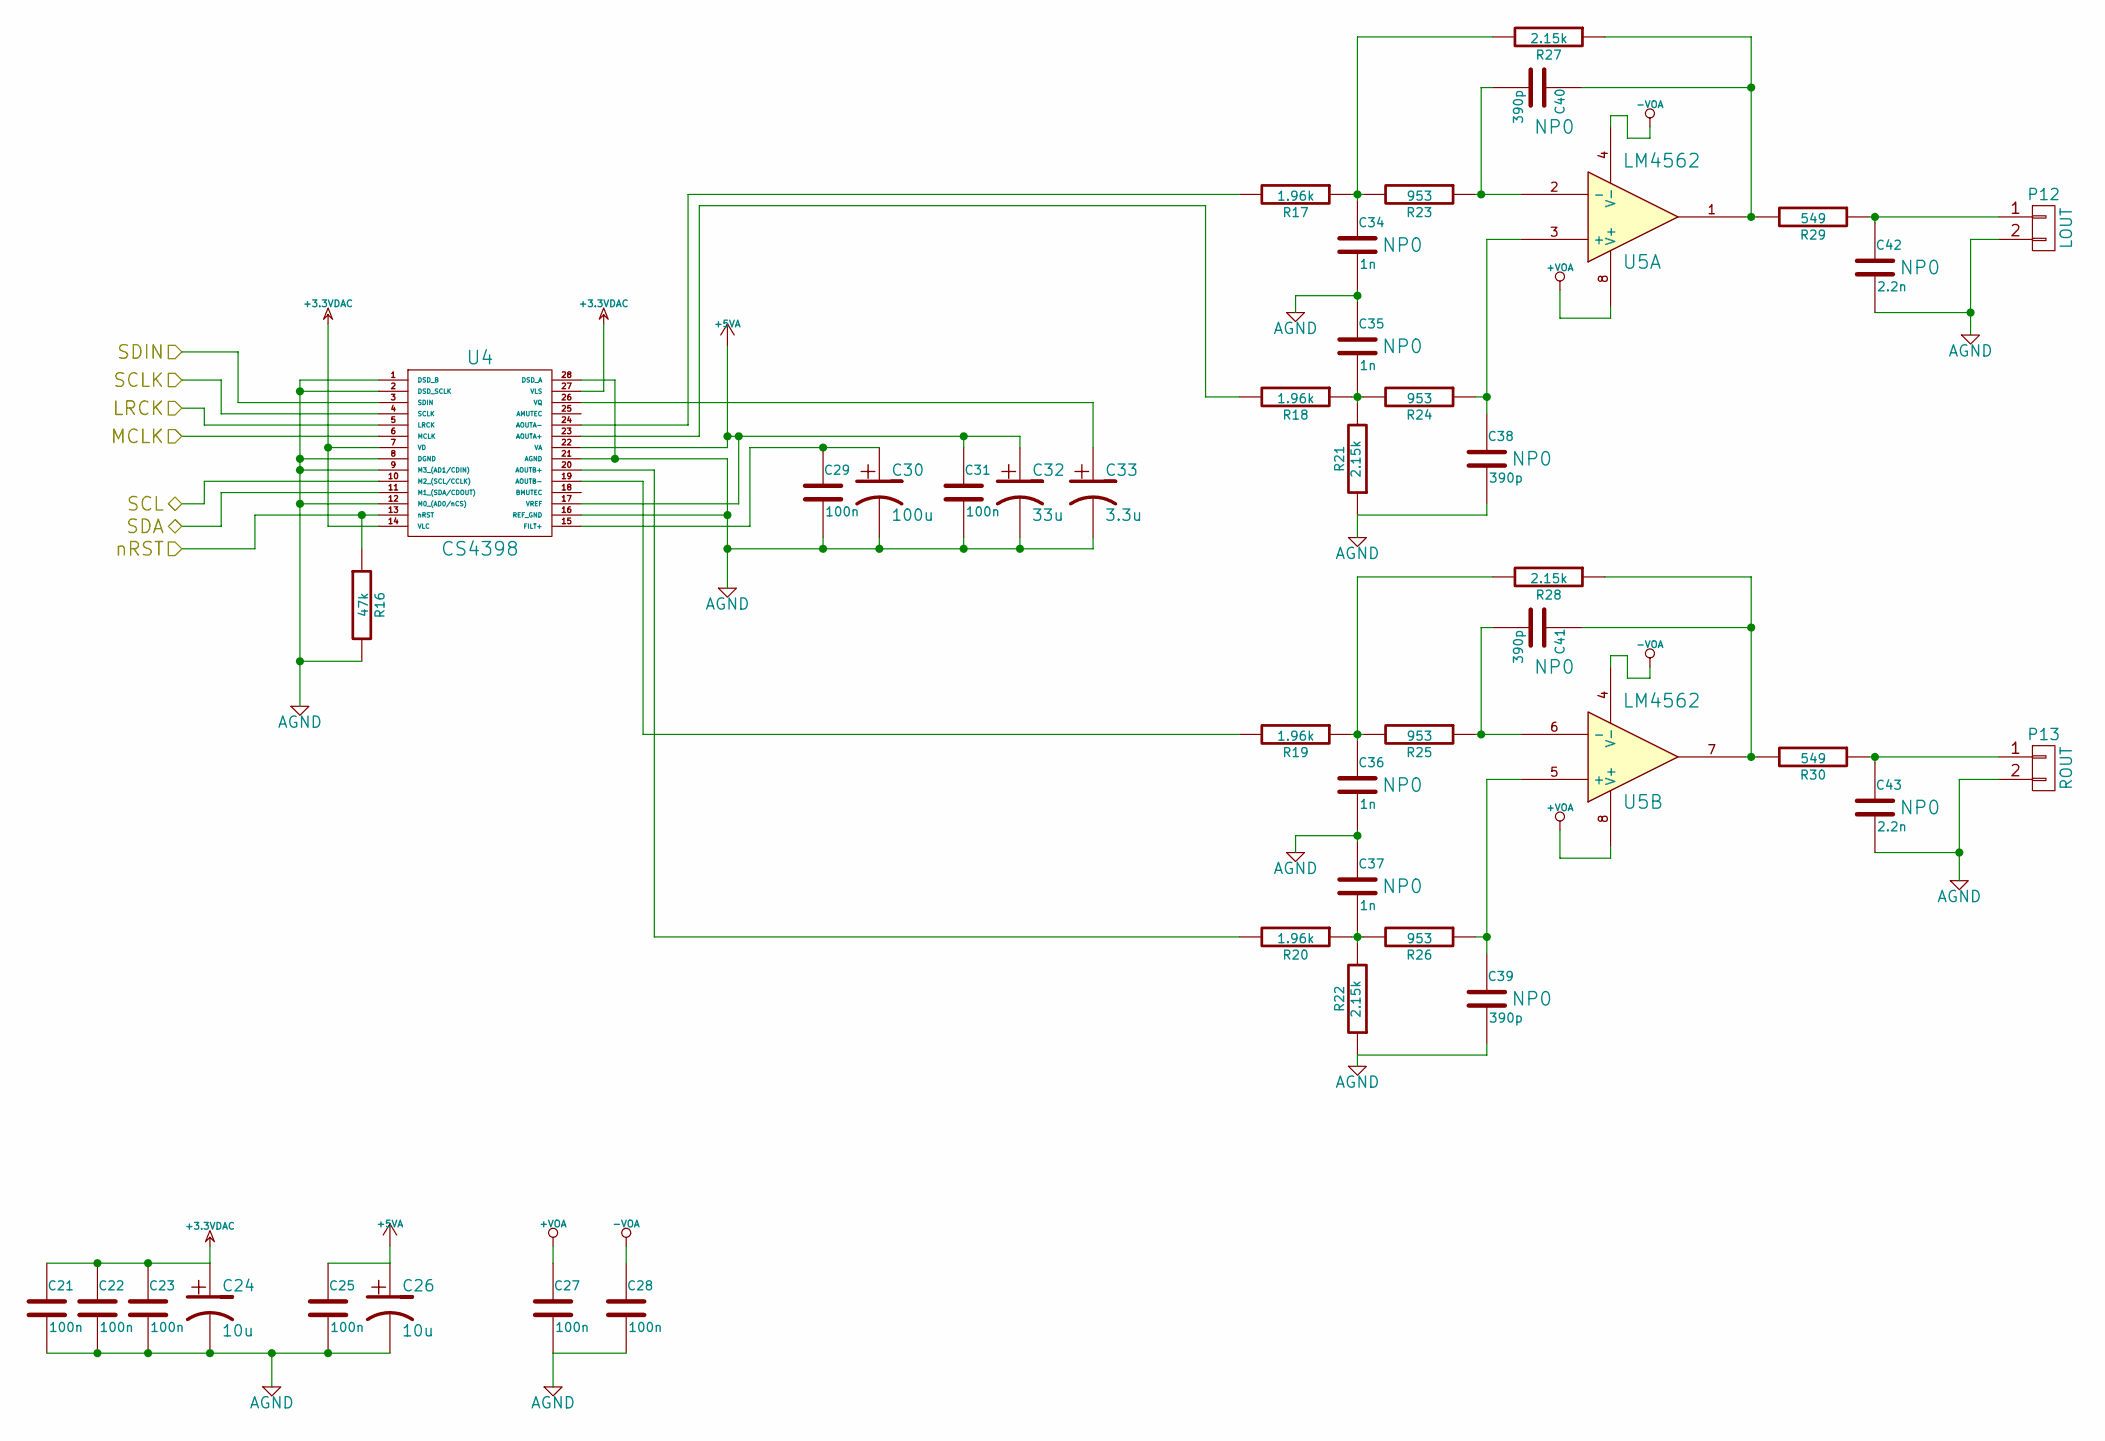
[picture p15: schematic dac.sch, AsD Pre 1 Digital Preamplifier -- DAC]

Parts:
C21, C22, C23, C25, C27, C28, C29, C31: 100n; C_0603_HandSoldering
C24, C26: 10u; C_0805_HandSoldering
C30: 100u; TantalC_SizeB_EIA-3528_HandSoldering
C32: 33u; C_1210_HandSoldering
C33: 3.3u; C_0805_HandSoldering
C34, C35, C36, C37: 1n; C_0603_HandSoldering
C38, C39, C40, C41: 390p; C_0603_HandSoldering
C42, C43: 2.2n; C_0603_HandSoldering
P12: LOUT; Terminal_Block_2_2.5mm
P13: ROUT; Terminal_Block_2_2.5mm
R16: 47k; R_0805_HandSoldering
R17, R18, R19, R20: 1.96k; R_0805_HandSoldering
R21, R22, R27, R28: 2.15k; R_0805_HandSoldering
R23, R24, R25, R26: 953; R_0805_HandSoldering
R29, R30: 549; R_0805_HandSoldering
U4: CS4398; TSSOP-28_4.4x9.7mm_Pitch0.65mm
U5: LM4562; SOIC-8-W

Connections:
+3.3V: C21.1, C22.1, C23.1, C24.1, U4.7 (VD), U4.14 (VLC), U4.27 (VLS); also elsewhere on the board
+5VA: C25.1, C26.1, C31.1, C32.1, U4.17 (VREF), U4.22 (VA); also elsewhere on the board
+VOA: C27.1, U5.8 (V+); also elsewhere on the board
-VOA: C28.1, U5.4 (V-); also elsewhere on the board
/DAC/LRCK: U4.5 (LRCK); also elsewhere on the board
/DAC/MCLK: U4.6 (MCLK); also elsewhere on the board
/DAC/nRST: R16.1, U4.13 (nRST); also elsewhere on the board
/EFM32GG/I2C0_SCL: U4.10 (M2_(SCL/CCLK)); also elsewhere on the board
/EFM32GG/I2C0_SDA: U4.11 (M1_(SDA/CDOUT)); also elsewhere on the board
/FPGA/BCKO: U4.4 (SCLK); also elsewhere on the board
/FPGA/DOUT: U4.3 (SDIN); also elsewhere on the board
DGND: C21.2, C22.2, C23.2, C24.2, C25.2, C26.2, C27.2, C28.2, C29.2, C30.2, C31.2, C32.2, C33.2, C34.2, C35.1, C36.2, C37.1, C38.2, C39.2, C42.2, C43.2, P12.2, P13.2, R16.2, R21.1, R22.1, U4.1 (DSD_B), U4.2 (DSD_SCLK), U4.8 (DGND), U4.9 (M3_(AD1/CDIN)), U4.12 (M0_(AD0/nCS)), U4.16 (REF_GND), U4.21 (AGND), U4.28 (DSD_A); also elsewhere on the board
unnamed: C29.1, C30.1, U4.15 (FILT+)
unnamed: C33.1, U4.26 (VQ)
unnamed: C34.1, R17.1, R23.2, R27.2
unnamed: C35.2, R18.1, R21.2, R24.2
unnamed: C36.1, R19.1, R25.2, R28.2
unnamed: C37.2, R20.1, R22.2, R26.2
unnamed: C38.1, R24.1, U5.3 (+)
unnamed: C39.1, R26.1, U5.5 (+)
unnamed: C40.1, R27.1, R29.2, U5.1
unnamed: C40.2, R23.1, U5.2 (-)
unnamed: C41.1, R28.1, R30.2, U5.7
unnamed: C41.2, R25.1, U5.6 (-)
unnamed: C42.1, P12.1, R29.1
unnamed: C43.1, P13.1, R30.1
unnamed: R17.2, U4.24 (AOUTA-)
unnamed: R18.2, U4.23 (AOUTA+)
unnamed: R19.2, U4.19 (AOUTB-)
unnamed: R20.2, U4.20 (AOUTB+)

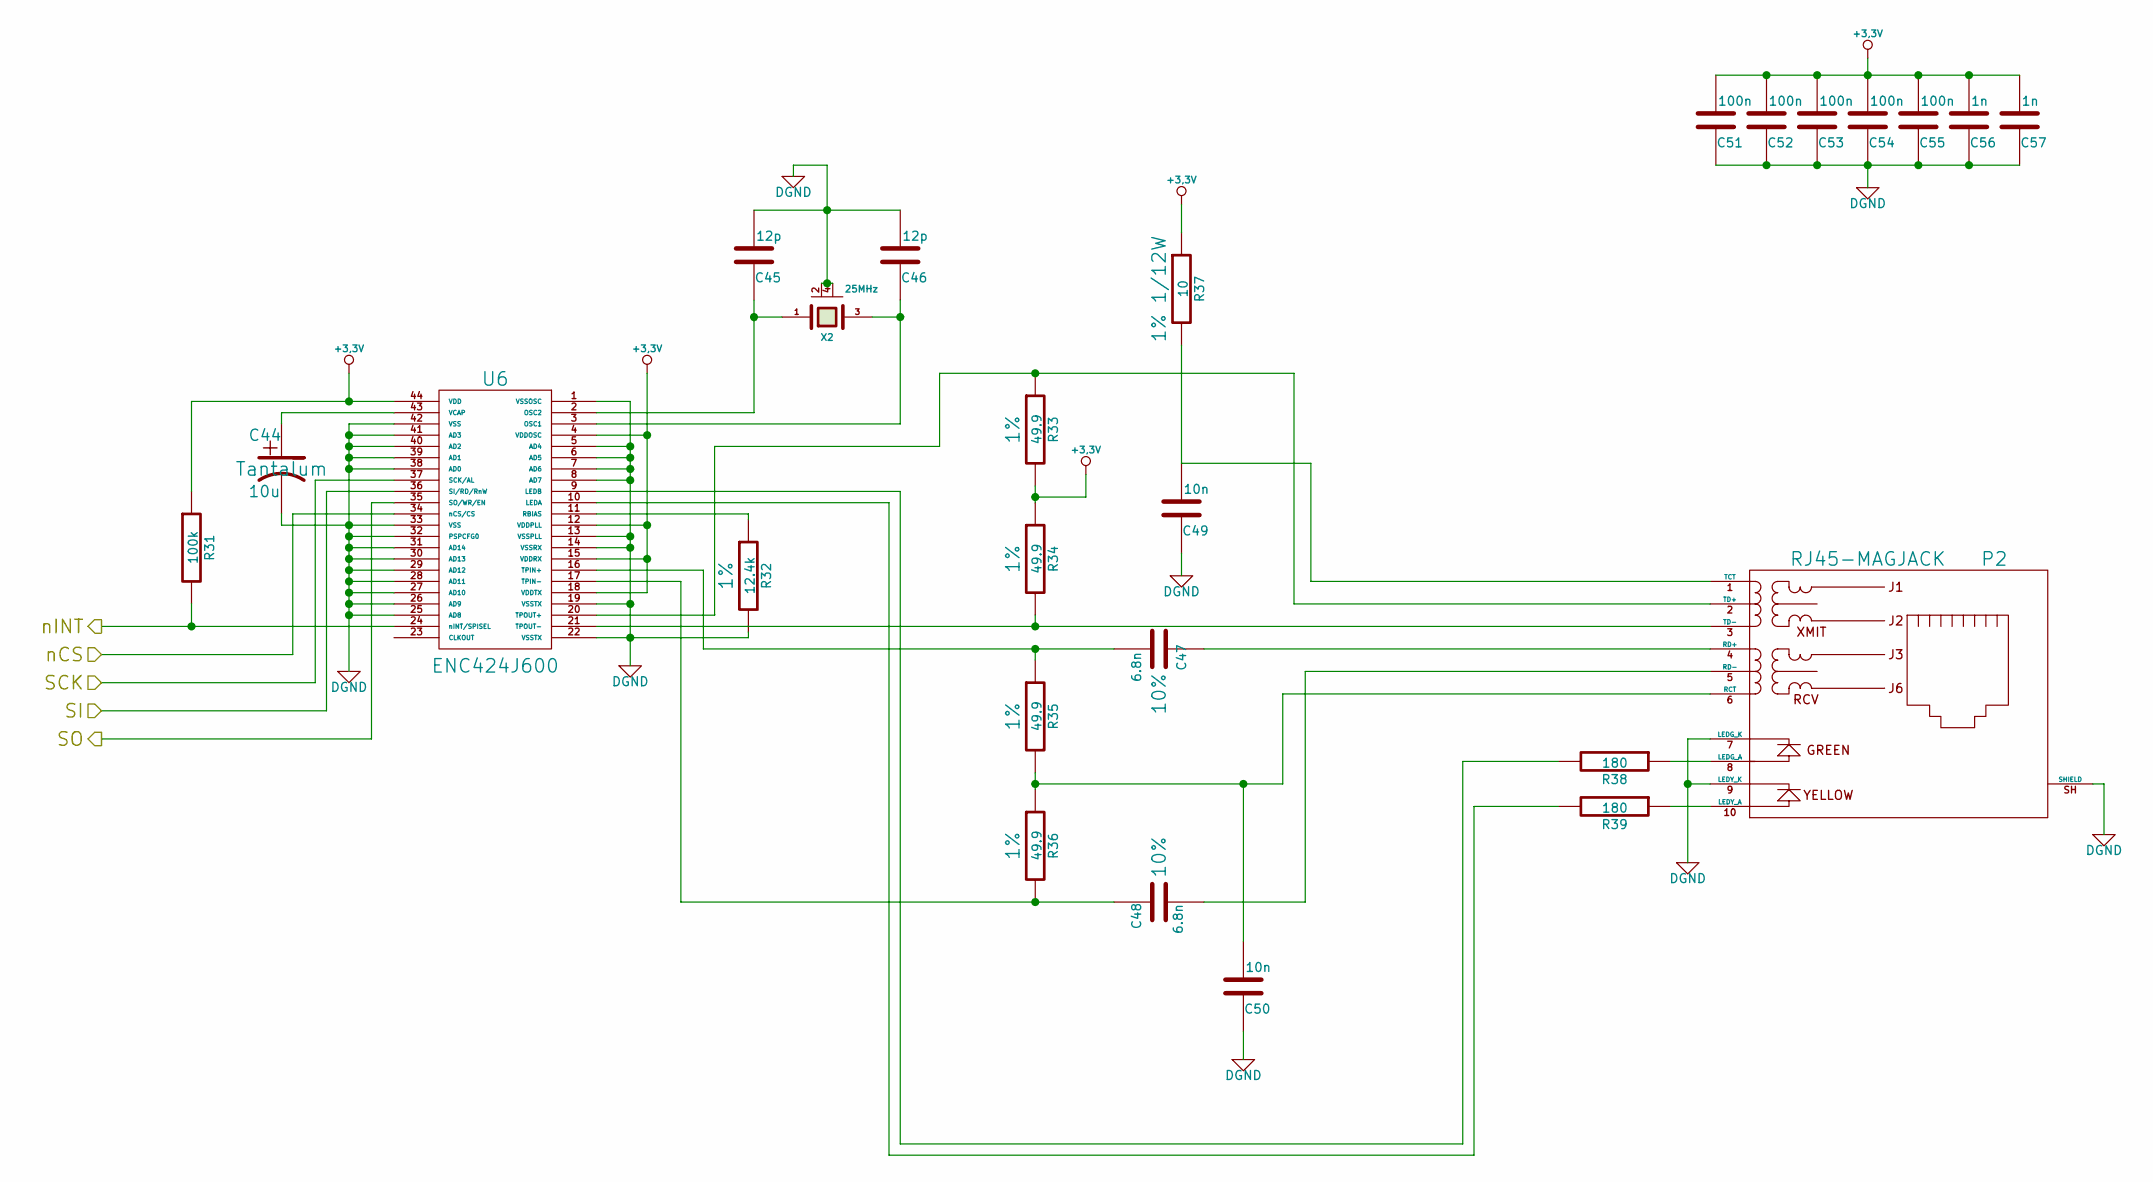
[picture p16: schematic eth.sch, AsD Pre 1 Digital Preamplifier -- Ethernet]

Parts:
C44: 10u; C_0805_HandSoldering
C45, C46: 12p; C_0603_HandSoldering
C47, C48: 6.8n; C_0603_HandSoldering
C49, C50: 10n; C_0603_HandSoldering
C51, C52, C53, C54, C55: 100n; C_0603_HandSoldering
C56, C57: 1n; C_0603_HandSoldering
P2: RJ45-MAGJACK; 08B0-1D1T-06-F
R31: 100k; R_0805_HandSoldering
R32: 12.4k; R_0805_HandSoldering
R33, R34, R35, R36: 49.9; R_0805_HandSoldering
R37: 10; R_0805_HandSoldering
R38, R39: 180; R_0805_HandSoldering
U6: ENC424J600; TQFP-44_10x10mm_Pitch0.8mm
X2: 25MHz; XTAL_SMD

Connections:
+3.3V: C51.2, C52.2, C53.2, C54.2, C55.2, C56.2, C57.2, R31.1, R33.2, R34.1, R37.1, U6.4 (VDDOSC), U6.12 (VDDPLL), U6.15 (VDDRX), U6.18 (VDDTX), U6.44 (VDD); also elsewhere on the board
/EFM32GG/US1_CS: U6.34 (nCS/CS); also elsewhere on the board
/ETH/SCK: U6.37 (SCK/AL); also elsewhere on the board
/ETH/SI: U6.36 (SI/RD/RnW); also elsewhere on the board
/ETH/SO: U6.35 (SO/WR/EN); also elsewhere on the board
/ETH/nINT: R31.2, U6.24 (nINT/SPISEL); also elsewhere on the board
DGND: C44.2, C45.2, C46.2, C49.1, C50.1, C51.1, C52.1, C53.1, C54.1, C55.1, C56.1, C57.1, P2.7 (LEDG_K), P2.9 (LEDY_K), P2.SH (SHIELD), R32.2, U6.1 (VSSOSC), U6.5 (AD4), U6.6 (AD5), U6.7 (AD6), U6.8 (AD7), U6.13 (VSSPLL), U6.14 (VSSRX), U6.19 (VSSTX), U6.22 (VSSTX), U6.25 (AD8), U6.26 (AD9), U6.27 (AD10), U6.28 (AD11), U6.29 (AD12), U6.30 (AD13), U6.31 (AD14), U6.32 (PSPCFG0), U6.33 (VSS), U6.38 (AD0), U6.39 (AD1), U6.40 (AD2), U6.41 (AD3), U6.42 (VSS), X2.2 (GND), X2.4 (GND); also elsewhere on the board
unnamed: C44.1, U6.43 (VCAP)
unnamed: C45.1, U6.2 (OSC2), X2.1
unnamed: C46.1, U6.3 (OSC1), X2.3
unnamed: C47.1, P2.4 (RD+)
unnamed: C47.2, R35.1, U6.16 (TPIN+)
unnamed: C48.1, R36.2, U6.17 (TPIN-)
unnamed: C48.2, P2.5 (RD-)
unnamed: C49.2, P2.1 (TCT), R37.2
unnamed: C50.2, P2.6 (RCT), R35.2, R36.1
unnamed: P2.2 (TD+), R33.1, U6.20 (TPOUT+)
unnamed: P2.3 (TD-), R34.2, U6.21 (TPOUT-)
unnamed: P2.8 (LEDG_A), R38.1
unnamed: P2.10 (LEDY_A), R39.1
unnamed: R32.1, U6.11 (RBIAS)
unnamed: R38.2, U6.9 (LEDB)
unnamed: R39.2, U6.10 (LEDA)

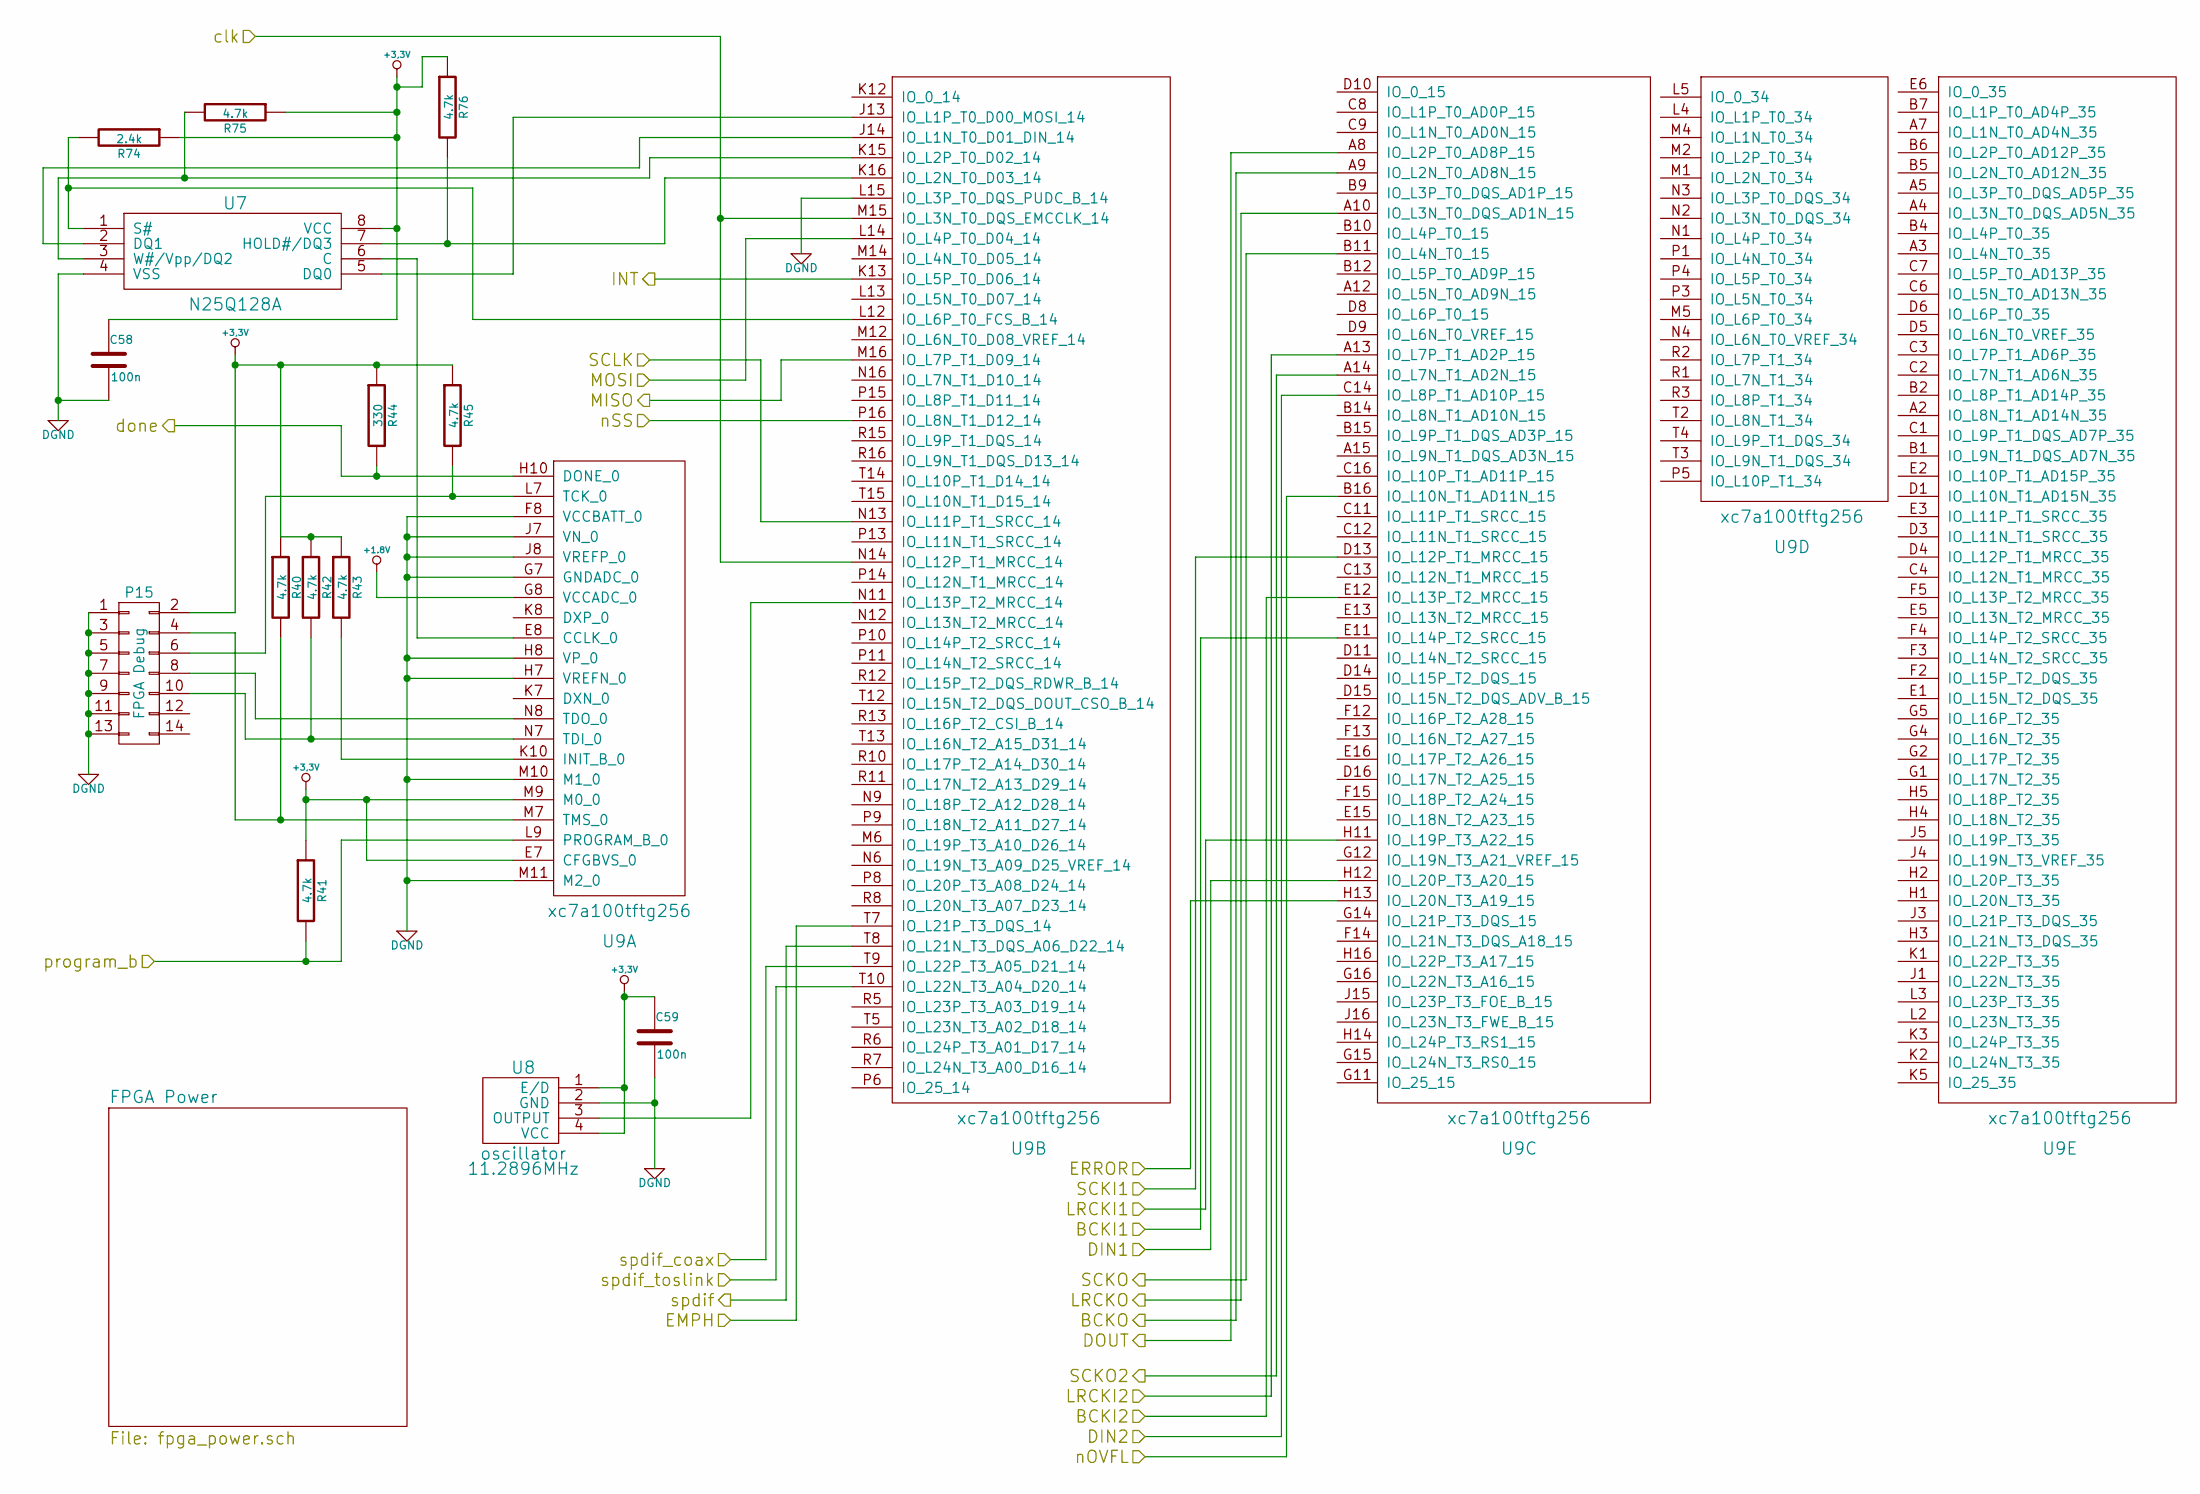
[picture p17: schematic FPGA.sch, AsD Pre 1 Digital Preamplifier -- FPGA]

Parts:
C58, C59: 100n; C_0603_HandSoldering
P15: FPGA Debug; FPGA_debug
R40, R41, R42, R43, R45, R75, R76: 4.7k; R_0805_HandSoldering
R44: 330; R_0805_HandSoldering
R74: 2.4k; R_0805_HandSoldering
U7: N25Q128A; SOIJ-8_5.3x5.3mm_Pitch1.27mm
U8: oscillator; OSC_SMD
U9: xc7a100tftg256; FTG256

Connections:
+1.8V: U9.G8 (VCCADC_0); also elsewhere on the board
+3.3V: C58.1, C59.1, P15.2, R40.1, R41.1, R42.1, R43.1, R44.1, R45.1, R74.1, R75.1, R76.1, U7.8 (VCC), U8.1 (E/D), U8.4 (VCC), U9.E7 (CFGBVS_0), U9.M9 (M0_0); also elsewhere on the board
/ADC/LRCK: U9.A13 (IO_L7P_T1_AD2P_15); also elsewhere on the board
/ADC/MCLK: U9.A14 (IO_L7N_T1_AD2N_15); also elsewhere on the board
/ADC/nOVFL: U9.B16 (IO_L10N_T1_AD11N_15); also elsewhere on the board
/DAC/LRCK: U9.A10 (IO_L3N_T0_DQS_AD1N_15); also elsewhere on the board
/DAC/MCLK: U9.B11 (IO_L4N_T0_15); also elsewhere on the board
/EFM32GG/US2_CS: U9.P16 (IO_L8N_T1_D12_14); also elsewhere on the board
/EFM32GG/done: R44.2, U9.H10 (DONE_0); also elsewhere on the board
/EFM32GG/program_b: R41.2, U9.L9 (PROGRAM_B_0); also elsewhere on the board
/FPGA/BCKI1: U9.E11 (IO_L14P_T2_SRCC_15); also elsewhere on the board
/FPGA/BCKI2: U9.E12 (IO_L13P_T2_MRCC_15); also elsewhere on the board
/FPGA/BCKO: U9.A9 (IO_L2N_T0_AD8N_15); also elsewhere on the board
/FPGA/DIN1: U9.H12 (IO_L20P_T3_A20_15); also elsewhere on the board
/FPGA/DIN2: U9.C14 (IO_L8P_T1_AD10P_15); also elsewhere on the board
/FPGA/DOUT: U9.A8 (IO_L2P_T0_AD8P_15); also elsewhere on the board
/FPGA/EMPH: U9.T7 (IO_L21P_T3_DQS_14); also elsewhere on the board
/FPGA/ERROR: U9.H13 (IO_L20N_T3_A19_15); also elsewhere on the board
/FPGA/INT: U9.K13 (IO_L5P_T0_D06_14); also elsewhere on the board
/FPGA/LRCKI1: U9.H11 (IO_L19P_T3_A22_15); also elsewhere on the board
/FPGA/MISO: U9.M16 (IO_L7P_T1_D09_14); also elsewhere on the board
/FPGA/MOSI: U9.L14 (IO_L4P_T0_D04_14); also elsewhere on the board
/FPGA/SCKI1: U9.D13 (IO_L12P_T1_MRCC_15); also elsewhere on the board
/FPGA/SCLK: U9.N13 (IO_L11P_T1_SRCC_14); also elsewhere on the board
/FPGA/clk: U9.M15 (IO_L3N_T0_DQS_EMCCLK_14), U9.N14 (IO_L12P_T1_MRCC_14); also elsewhere on the board
/FPGA/spdif: U9.T8 (IO_L21N_T3_DQS_A06_D22_14); also elsewhere on the board
/FPGA/spdif_coax: U9.T9 (IO_L22P_T3_A05_D21_14); also elsewhere on the board
/FPGA/spdif_toslink: U9.T10 (IO_L22N_T3_A04_D20_14); also elsewhere on the board
DGND: C58.2, C59.2, P15.1, P15.3, P15.5, P15.7, P15.9, P15.11, P15.13, U7.4 (VSS), U8.2 (GND), U9.F8 (VCCBATT_0), U9.G7 (GNDADC_0), U9.H7 (VREFN_0), U9.H8 (VP_0), U9.J7 (VN_0), U9.J8 (VREFP_0), U9.L15 (IO_L3P_T0_DQS_PUDC_B_14), U9.M10 (M1_0), U9.M11 (M2_0); also elsewhere on the board
unnamed: P15.4, R40.2, U9.M7 (TMS_0)
unnamed: P15.6, R45.2, U9.L7 (TCK_0)
unnamed: P15.8, U9.N8 (TDO_0)
unnamed: P15.10, R42.2, U9.N7 (TDI_0)
unnamed: R43.2, U9.K10 (INIT_B_0)
unnamed: R74.2, U7.1 (S#), U9.L12 (IO_L6P_T0_FCS_B_14)
unnamed: R75.2, U7.3 (W#/Vpp/DQ2), U9.K15 (IO_L2P_T0_D02_14)
unnamed: R76.2, U7.7 (HOLD#/DQ3), U9.K16 (IO_L2N_T0_D03_14)
unnamed: U7.2 (DQ1), U9.J14 (IO_L1N_T0_D01_DIN_14)
unnamed: U7.5 (DQ0), U9.J13 (IO_L1P_T0_D00_MOSI_14)
unnamed: U7.6 (C), U9.E8 (CCLK_0)
unnamed: U8.3 (OUTPUT), U9.N11 (IO_L13P_T2_MRCC_14)
