djupdal/asd-amp/asd_pre_1/pcb/preamp.kicad_pcb

## KiCad design asd_pre_1/pcb/preamp.kicad_pcb (continued)

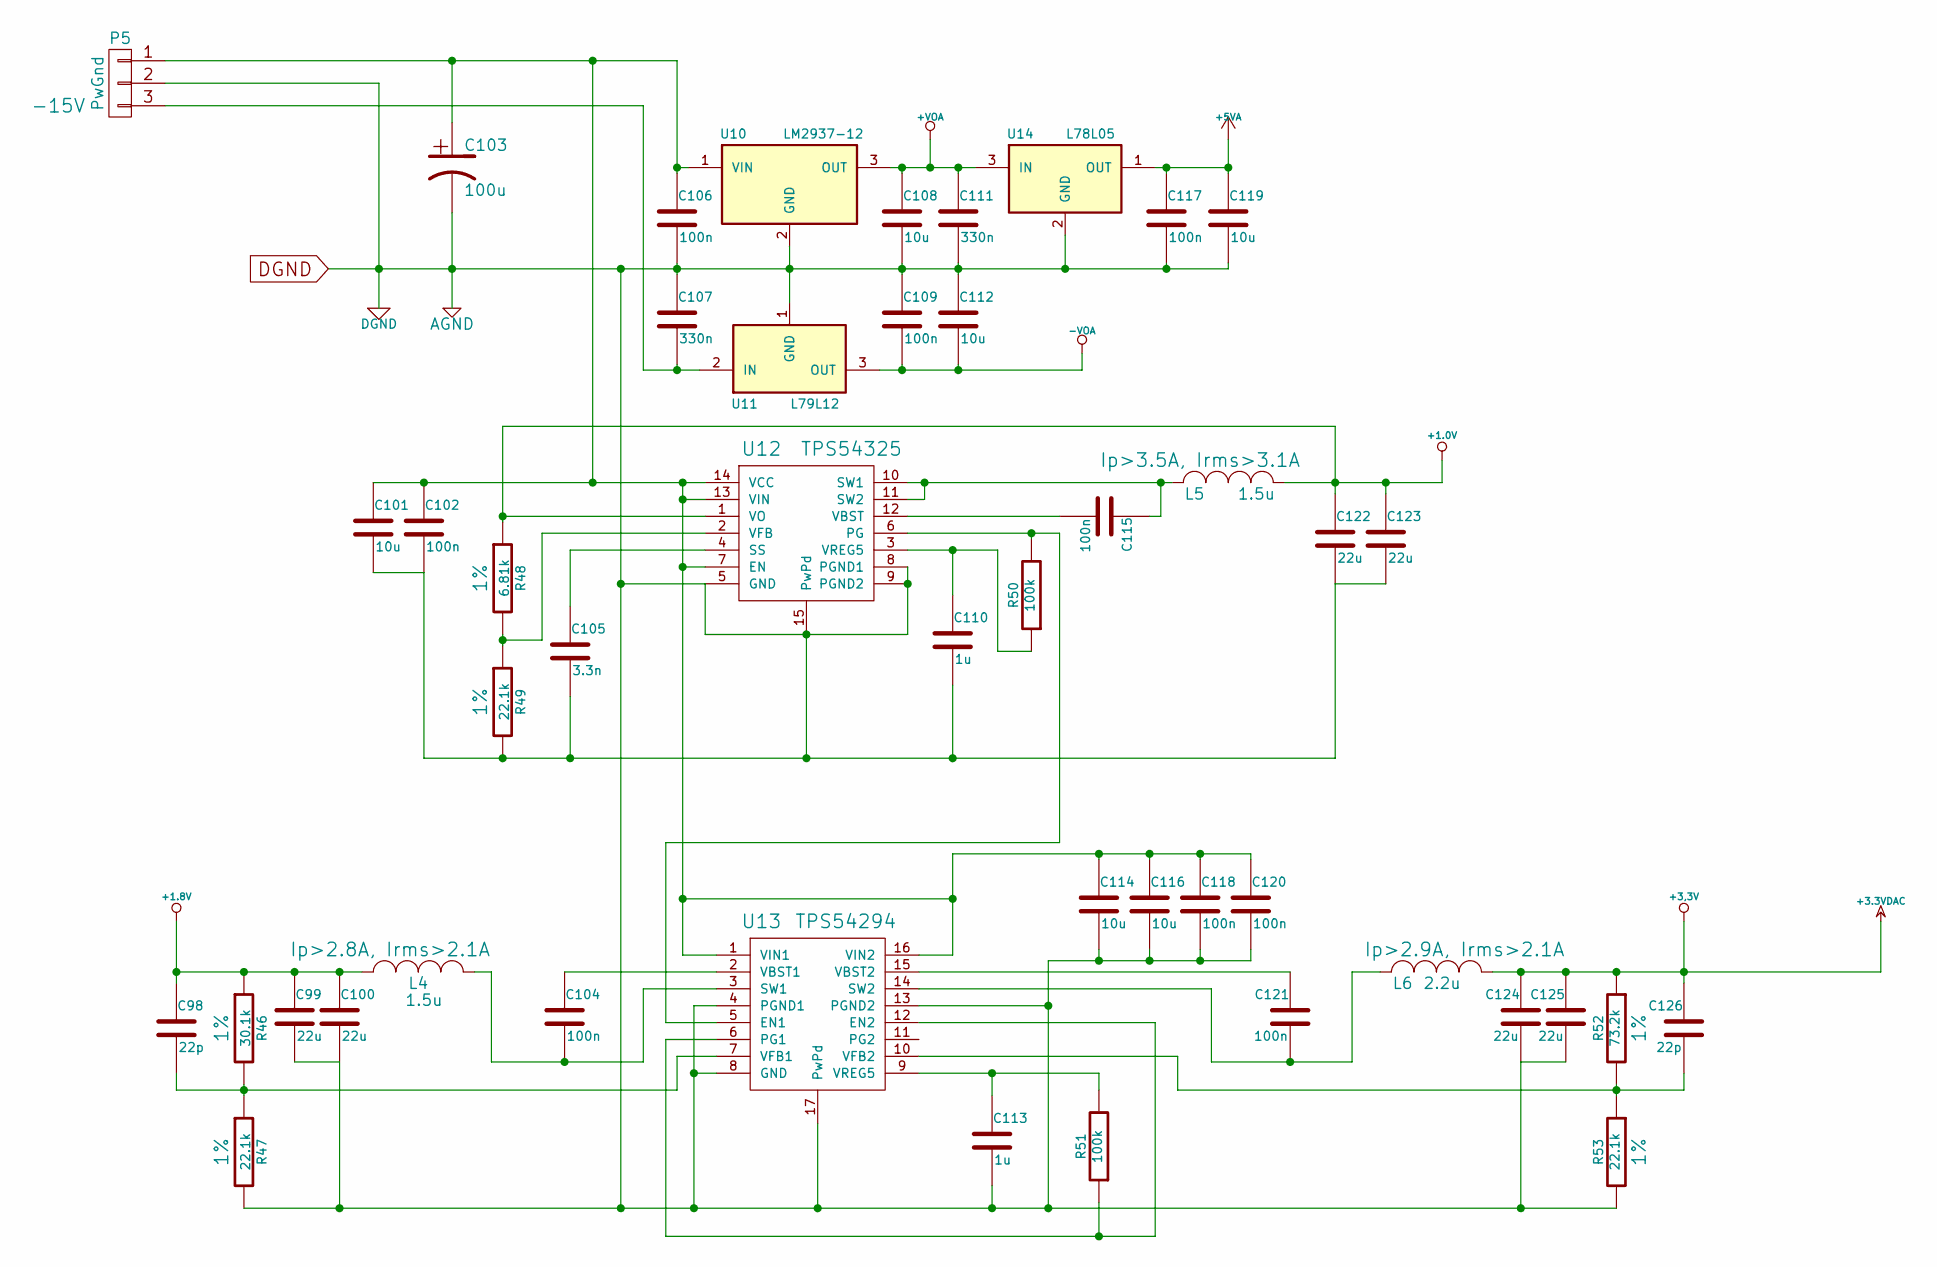
[picture p18: schematic power.sch, AsD Pre 1 Digital Preamplifier -- Power]

Parts:
C98, C126: 22p; C_0603_HandSoldering
C99, C100, C122, C123, C124, C125: 22u; C_0805_HandSoldering
C101, C108, C112, C114, C116, C119: 10u; C_0805_HandSoldering
C102, C104, C106, C109, C115, C117, C118, C120, C121: 100n; C_0603_HandSoldering
C103: 100u; TantalC_SizeB_EIA-3528_HandSoldering
C105: 3.3n; C_0603_HandSoldering
C107, C111: 330n; C_0603_HandSoldering
C110, C113: 1u; C_0805_HandSoldering
L4, L5: 1.5u; SPM3015
L6: 2.2u; SPM3015
P5: PwGnd; Terminal_Block_3_5mm
R46: 30.1k; R_0805_HandSoldering
R47, R49, R53: 22.1k; R_0805_HandSoldering
R48: 6.81k; R_0805_HandSoldering
R50, R51: 100k; R_0805_HandSoldering
R52: 73.2k; R_0805_HandSoldering
U10: LM2937-12; SOT-223
U11: L79L12; SOT89-3_Housing_Handsoldering
U12: TPS54325; TSSOP-14_4.4x5mm_Pitch0.65mm_exposed_pad
U13: TPS54294; TSSOP-16-1EP_4.4x5mm_Pitch0.65mm
U14: L78L05; SOT89-3_Housing_Handsoldering

Connections:
+1.0V: C122.1, C123.1, L5.2, R48.1, U12.1 (VO); also elsewhere on the board
+1.8V: C98.1, C99.1, C100.1, L4.1, R46.1; also elsewhere on the board
+3.3V: C124.1, C125.1, C126.1, L6.1, R52.1; also elsewhere on the board
+5VA: C117.1, C119.1, U14.1 (OUT); also elsewhere on the board
+VOA: C108.1, C111.1, U10.3 (OUT), U14.3 (IN); also elsewhere on the board
-VOA: C109.2, C112.2, U11.3 (OUT); also elsewhere on the board
DGND: C99.2, C100.2, C101.2, C102.2, C103.2, C105.2, C106.2, C107.1, C108.2, C109.1, C110.2, C111.2, C112.1, C113.2, C114.2, C116.2, C117.2, C118.2, C119.2, C120.2, C122.2, C123.2, C124.2, C125.2, P5.2, R47.2, R49.2, R53.2, U10.2 (GND), U11.1 (GND), U12.5 (GND), U12.8 (PGND1), U12.9 (PGND2), U12.15 (PwPd), U13.4 (PGND1), U13.8 (GND), U13.13 (PGND2), U13.17 (PwPd), U14.2 (GND); also elsewhere on the board
unnamed: C98.2, R46.2, R47.1, U13.7 (VFB1)
unnamed: C101.1, C102.1, C103.1, C106.1, C114.1, C116.1, C118.1, C120.1, P5.1, U10.1 (VIN), U12.7 (EN), U12.13 (VIN), U12.14 (VCC), U13.1 (VIN1), U13.16 (VIN2)
unnamed: C104.1, U13.2 (VBST1)
unnamed: C104.2, L4.2, U13.3 (SW1)
unnamed: C105.1, U12.4 (SS)
unnamed: C107.2, P5.3, U11.2 (IN)
unnamed: C110.1, R50.1, U12.3 (VREG5)
unnamed: C113.1, R51.2, U13.9 (VREG5)
unnamed: C115.1, L5.1, U12.10 (SW1), U12.11 (SW2)
unnamed: C115.2, U12.12 (VBST)
unnamed: C121.1, U13.15 (VBST2)
unnamed: C121.2, L6.2, U13.14 (SW2)
unnamed: C126.2, R52.2, R53.1, U13.10 (VFB2)
unnamed: R48.2, R49.1, U12.2 (VFB)
unnamed: R50.2, U12.6 (PG), U13.5 (EN1)
unnamed: R51.1, U13.6 (PG1), U13.12 (EN2)

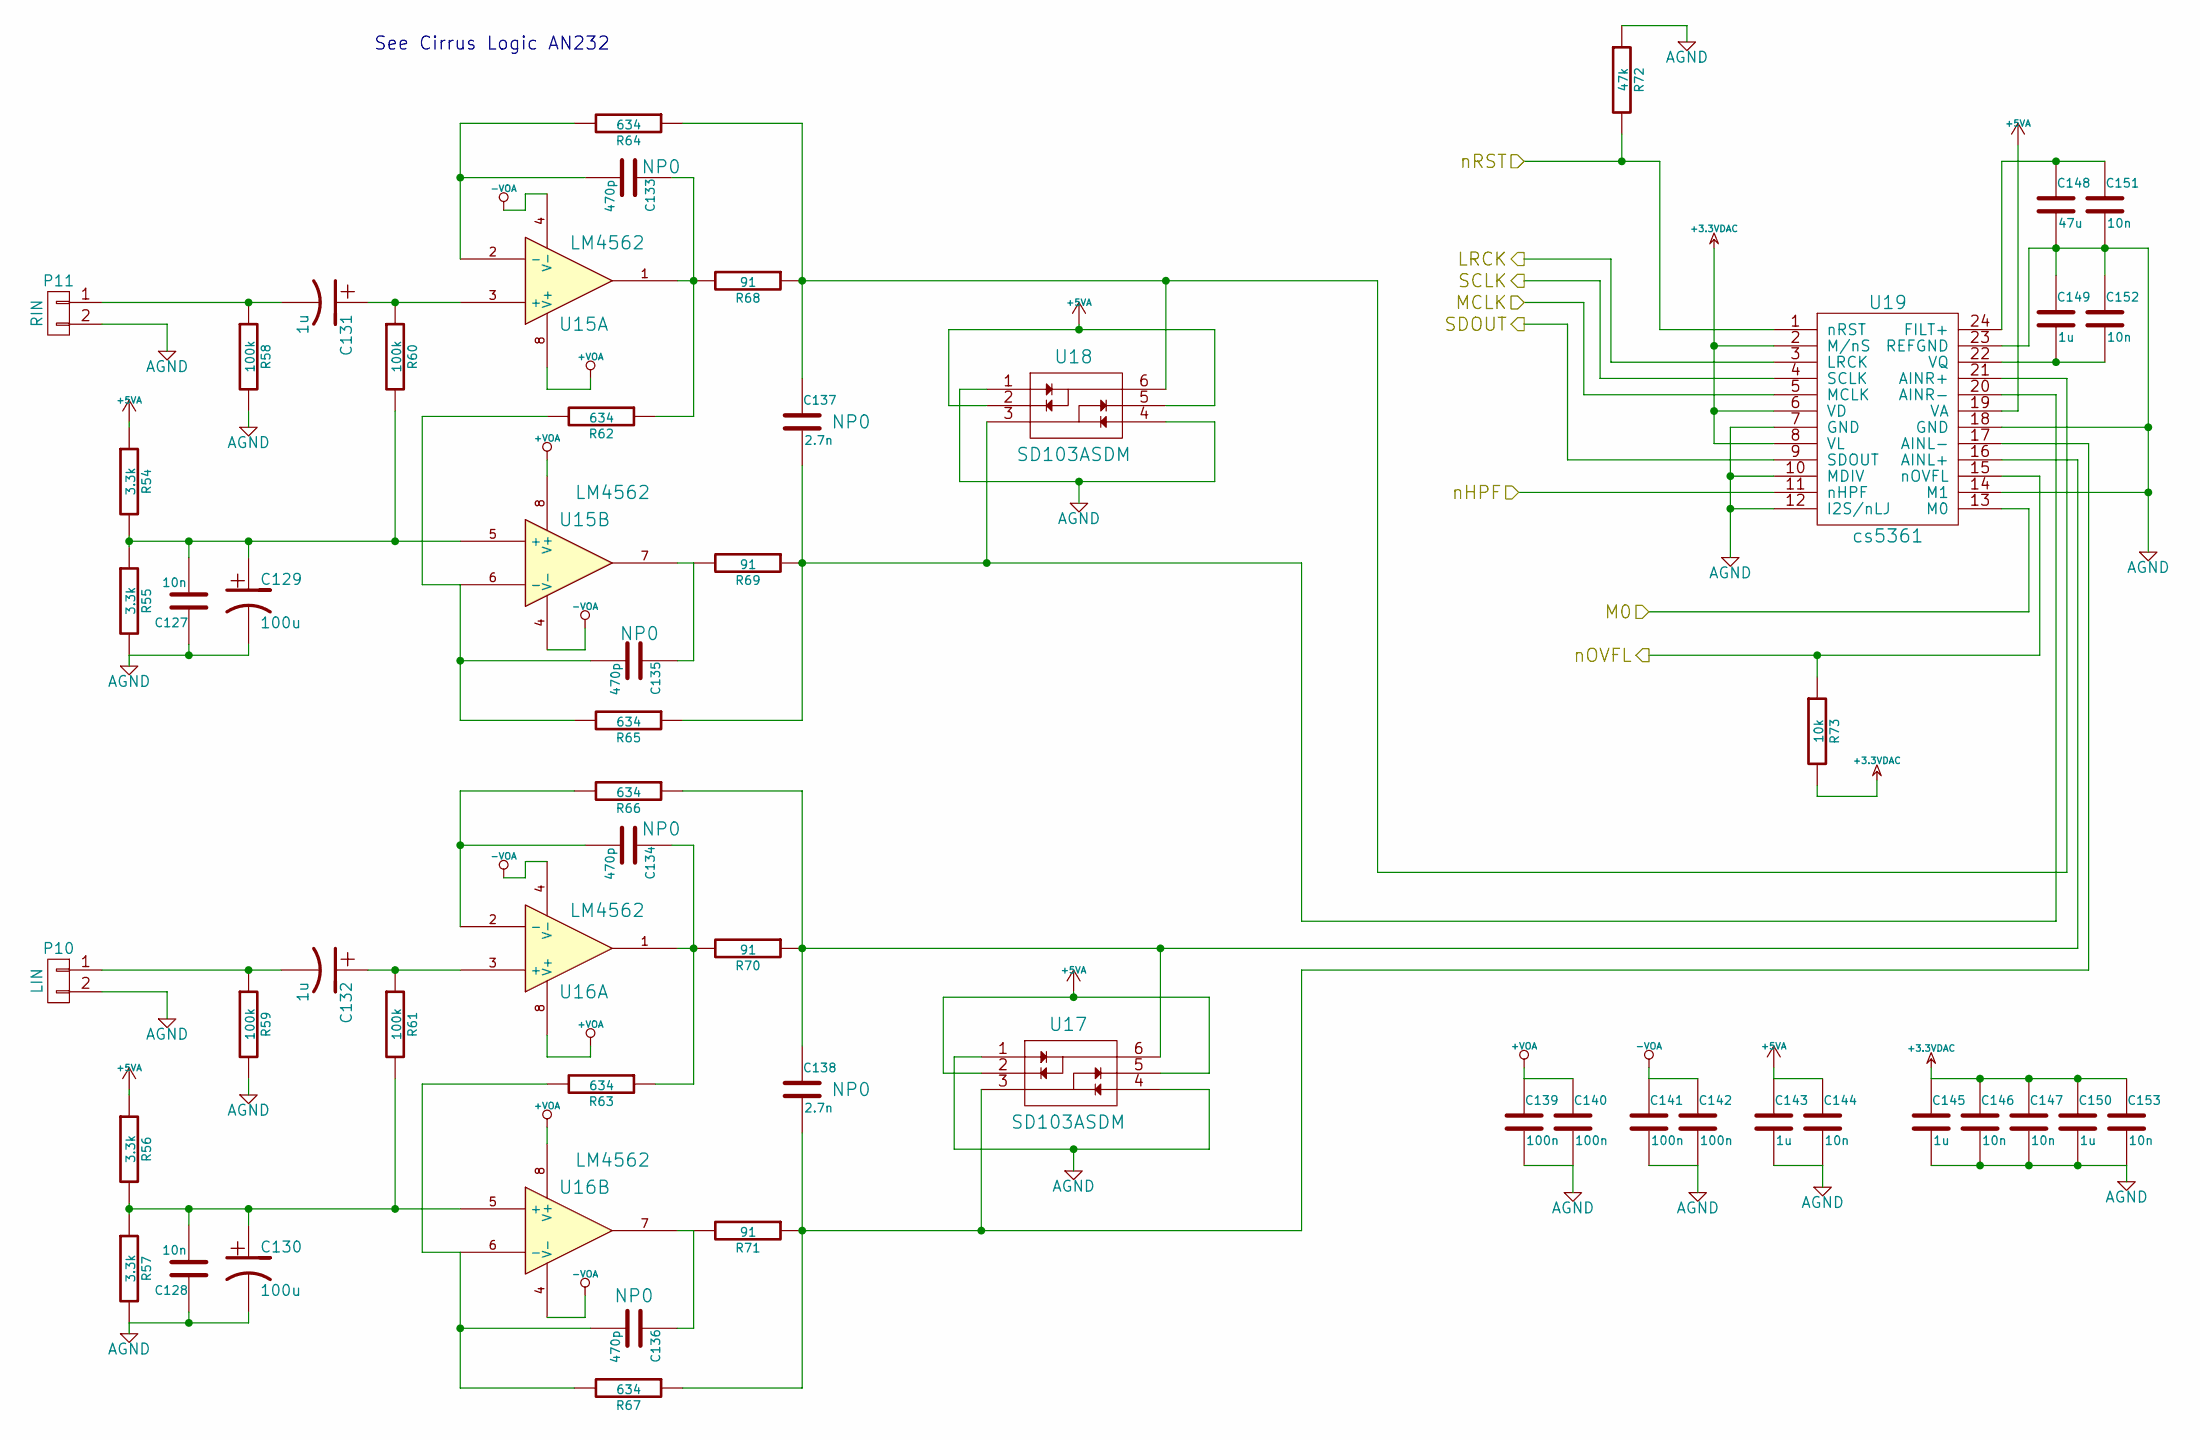
[picture p19: schematic adc.sch, AsD Pre 1 Digital Preamplifier -- ADC]

Parts:
C127, C128, C144, C146, C147, C151, C152, C153: 10n; C_0603_HandSoldering
C129, C130: 100u; TantalC_SizeB_EIA-3528_HandSoldering
C131, C132, C143, C145, C149, C150: 1u; C_0805_HandSoldering
C133, C134, C135, C136: 470p; C_0603_HandSoldering
C137, C138: 2.7n; C_0603_HandSoldering
C139, C140, C141, C142: 100n; C_0603_HandSoldering
C148: 47u; C_1210_HandSoldering
P10: LIN; Terminal_Block_2_2.5mm
P11: RIN; Terminal_Block_2_2.5mm
R54, R55, R56, R57: 3.3k; R_0805_HandSoldering
R58, R59, R60, R61: 100k; R_0805_HandSoldering
R62, R63, R64, R65, R66, R67: 634; R_0805_HandSoldering
R68, R69, R70, R71: 91; R_0805_HandSoldering
R72: 47k; R_0805_HandSoldering
R73: 10k; R_0805_HandSoldering
U15, U16: LM4562; SOIC-8-W
U17, U18: SD103ASDM; SOT-26-6
U19: cs5361; TSSOP-24_4.4x7.8mm_Pitch0.65mm

Connections:
+3.3V: C145.1, C146.1, C147.1, C150.1, C153.1, R73.2, U19.2 (M/nS), U19.6 (VD), U19.8 (VL); also elsewhere on the board
+5VA: C143.1, C144.1, R54.1, R56.1, U17.2, U17.5, U18.2, U18.5, U19.19 (VA); also elsewhere on the board
+VOA: C139.1, C140.1, U15.8 (V+), U16.8 (V+); also elsewhere on the board
-VOA: C141.1, C142.1, U15.4 (V-), U16.4 (V-); also elsewhere on the board
/ADC/LRCK: U19.3 (LRCK); also elsewhere on the board
/ADC/M0: U19.13 (M0); also elsewhere on the board
/ADC/MCLK: U19.5 (MCLK); also elsewhere on the board
/ADC/nHPF: U19.11 (nHPF); also elsewhere on the board
/ADC/nOVFL: R73.1, U19.15 (nOVFL); also elsewhere on the board
/ADC/nRST: R72.2, U19.1 (nRST); also elsewhere on the board
/FPGA/BCKI2: U19.4 (SCLK); also elsewhere on the board
/FPGA/DIN2: U19.9 (SDOUT); also elsewhere on the board
DGND: C127.1, C128.1, C129.2, C130.2, C139.2, C140.2, C141.2, C142.2, C143.2, C144.2, C145.2, C146.2, C147.2, C148.2, C149.1, C150.2, C151.2, C152.1, C153.2, P10.2, P11.2, R55.2, R57.2, R58.2, R59.2, R72.1, U17.1, U17.4, U18.1, U18.4, U19.7 (GND), U19.10 (MDIV), U19.12 (I2S/nLJ), U19.14 (M1), U19.18 (GND), U19.23 (REFGND); also elsewhere on the board
unnamed: C127.2, C129.1, R54.2, R55.1, R60.2, U15.5 (+)
unnamed: C128.2, C130.1, R56.2, R57.1, R61.2, U16.5 (+)
unnamed: C131.1, R60.1, U15.3 (+)
unnamed: C131.2, P11.1, R58.1
unnamed: C132.1, R61.1, U16.3 (+)
unnamed: C132.2, P10.1, R59.1
unnamed: C133.1, R62.1, R68.2, U15.1
unnamed: C133.2, R64.2, U15.2 (-)
unnamed: C134.1, R63.1, R70.2, U16.1
unnamed: C134.2, R66.2, U16.2 (-)
unnamed: C135.1, R69.2, U15.7
unnamed: C135.2, R62.2, R65.2, U15.6 (-)
unnamed: C136.1, R71.2, U16.7
unnamed: C136.2, R63.2, R67.2, U16.6 (-)
unnamed: C137.1, R64.1, R68.1, U18.6, U19.21 (AINR+)
unnamed: C137.2, R65.1, R69.1, U18.3, U19.20 (AINR-)
unnamed: C138.1, R66.1, R70.1, U17.6, U19.16 (AINL+)
unnamed: C138.2, R67.1, R71.1, U17.3, U19.17 (AINL-)
unnamed: C148.1, C151.1, U19.24 (FILT+)
unnamed: C149.2, C152.2, U19.22 (VQ)

Notes on the sheet:
See Cirrus Logic AN232

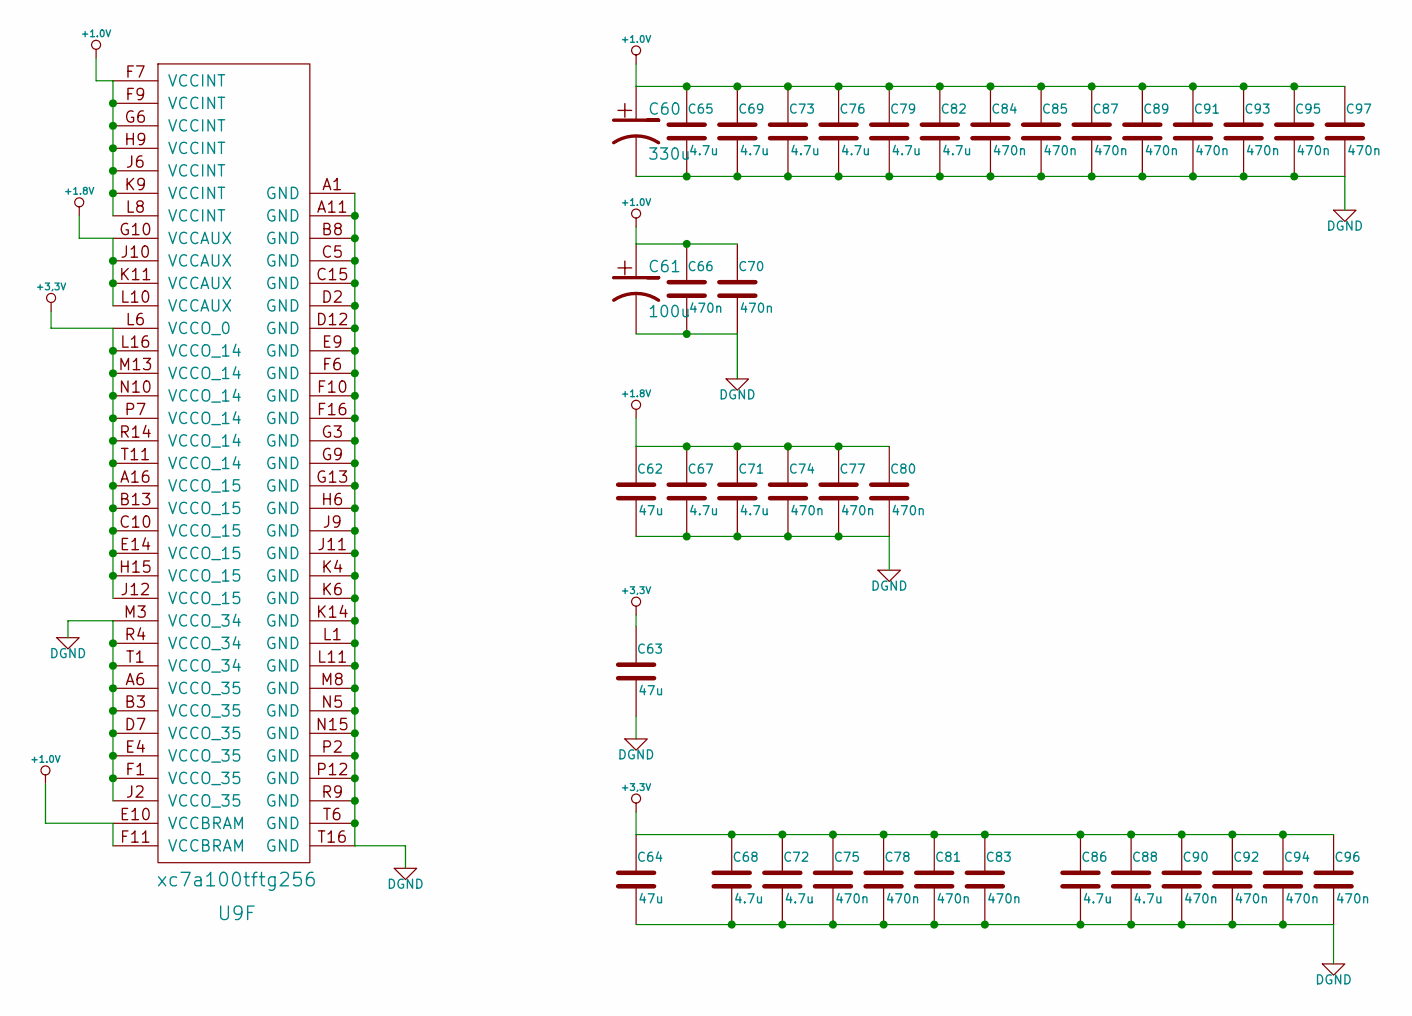
[picture p20: schematic fpga_power.sch, AsD Pre 1 Digital Preamplifier]

Parts:
C60: 330u; TantalC_SizeD_EIA-7343_HandSoldering
C61: 100u; TantalC_SizeB_EIA-3528_HandSoldering
C62, C63, C64: 47u; C_1210_HandSoldering
C65, C67, C68, C69, C71, C72, C73, C76, C79, C82, C86, C88: 4.7u; C_0805_HandSoldering
C66, C70, C74, C75, C77, C78, C80, C81, C83, C84, C85, C87, C89, C90, C91, C92, C93, C94, C95, C96, C97: 470n; C_0603_HandSoldering
U9: xc7a100tftg256; FTG256

Connections:
+1.0V: C60.1, C61.1, C65.1, C66.1, C69.1, C70.1, C73.1, C76.1, C79.1, C82.1, C84.1, C85.1, C87.1, C89.1, C91.1, C93.1, C95.1, C97.1, U9.E10 (VCCBRAM), U9.F7 (VCCINT), U9.F9 (VCCINT), U9.F11 (VCCBRAM), U9.G6 (VCCINT), U9.H9 (VCCINT), U9.J6 (VCCINT), U9.K9 (VCCINT), U9.L8 (VCCINT); also elsewhere on the board
+1.8V: C62.1, C67.1, C71.1, C74.1, C77.1, C80.1, U9.G10 (VCCAUX), U9.J10 (VCCAUX), U9.K11 (VCCAUX), U9.L10 (VCCAUX); also elsewhere on the board
+3.3V: C63.1, C64.1, C68.1, C72.1, C75.1, C78.1, C81.1, C83.1, C86.1, C88.1, C90.1, C92.1, C94.1, C96.1, U9.A16 (VCCO_15), U9.B13 (VCCO_15), U9.C10 (VCCO_15), U9.E14 (VCCO_15), U9.H15 (VCCO_15), U9.J12 (VCCO_15), U9.L6 (VCCO_0), U9.L16 (VCCO_14), U9.M13 (VCCO_14), U9.N10 (VCCO_14), U9.P7 (VCCO_14), U9.R14 (VCCO_14), U9.T11 (VCCO_14); also elsewhere on the board
DGND: C60.2, C61.2, C62.2, C63.2, C64.2, C65.2, C66.2, C67.2, C68.2, C69.2, C70.2, C71.2, C72.2, C73.2, C74.2, C75.2, C76.2, C77.2, C78.2, C79.2, C80.2, C81.2, C82.2, C83.2, C84.2, C85.2, C86.2, C87.2, C88.2, C89.2, C90.2, C91.2, C92.2, C93.2, C94.2, C95.2, C96.2, C97.2, U9.A1 (GND), U9.A6 (VCCO_35), U9.A11 (GND), U9.B3 (VCCO_35), U9.B8 (GND), U9.C5 (GND), U9.C15 (GND), U9.D2 (GND), U9.D7 (VCCO_35), U9.D12 (GND), U9.E4 (VCCO_35), U9.E9 (GND), U9.F1 (VCCO_35), U9.F6 (GND), U9.F10 (GND), U9.F16 (GND), U9.G3 (GND), U9.G9 (GND), U9.G13 (GND), U9.H6 (GND), U9.J2 (VCCO_35), U9.J9 (GND), U9.J11 (GND), U9.K4 (GND), U9.K6 (GND), U9.K14 (GND), U9.L1 (GND), U9.L11 (GND), U9.M3 (VCCO_34), U9.M8 (GND), U9.N5 (GND), U9.N15 (GND), U9.P2 (GND), U9.P12 (GND), U9.R4 (VCCO_34), U9.R9 (GND), U9.T1 (VCCO_34), U9.T6 (GND), U9.T16 (GND); also elsewhere on the board

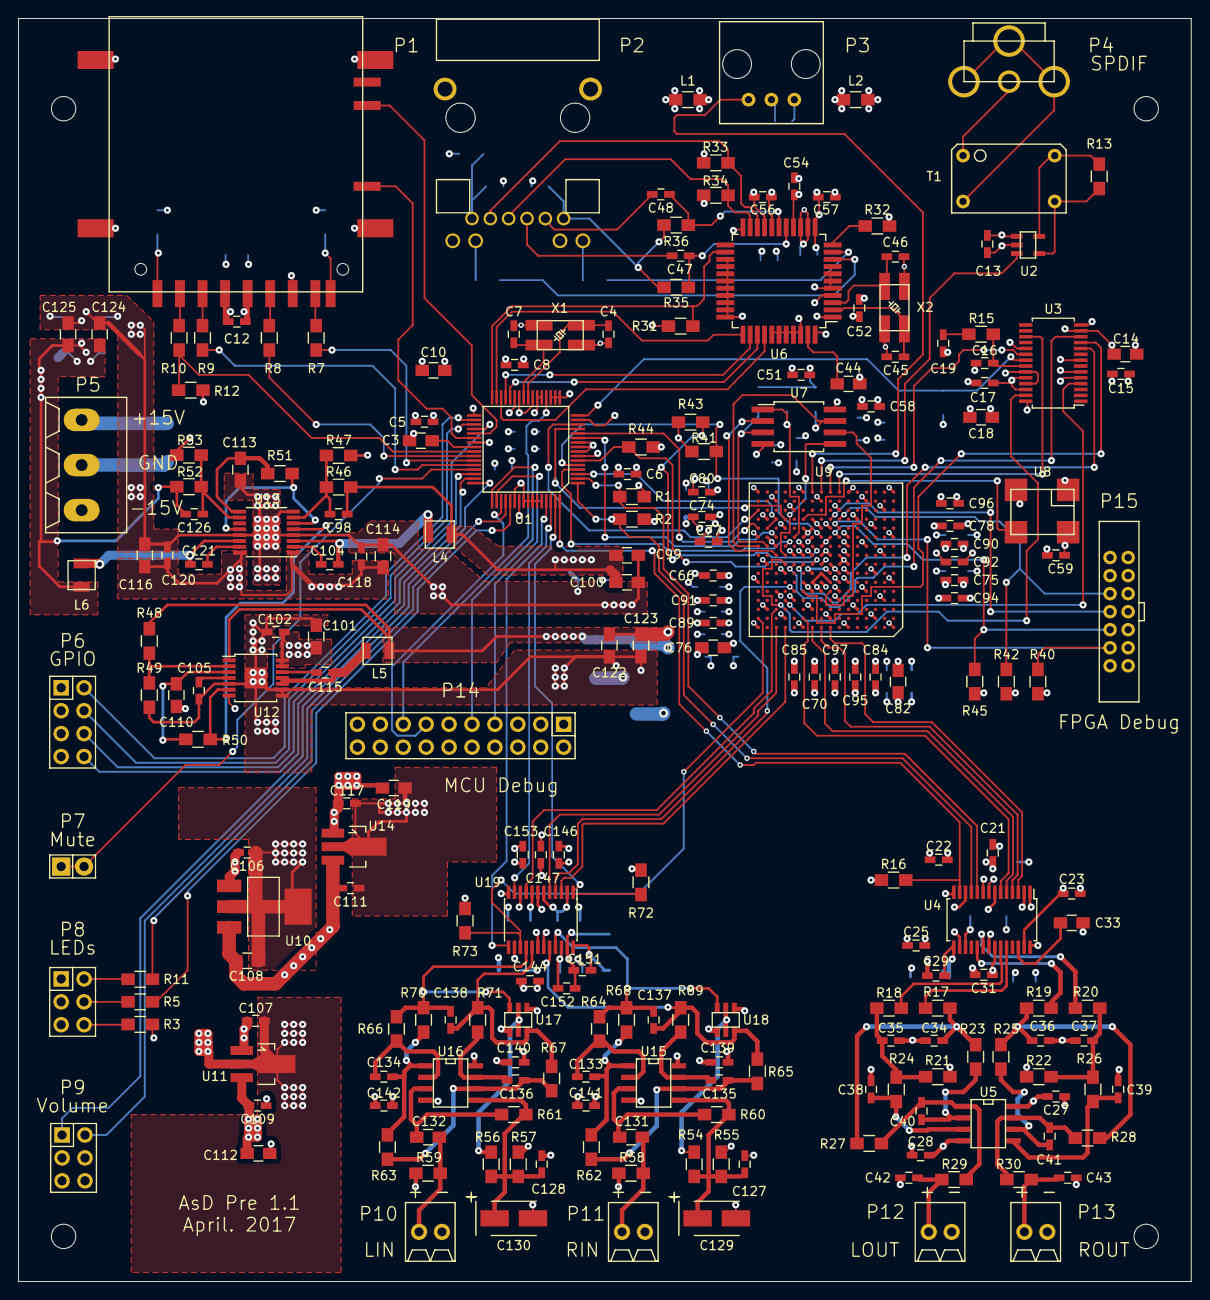
[picture p21: board preamp.kicad_pcb from above]

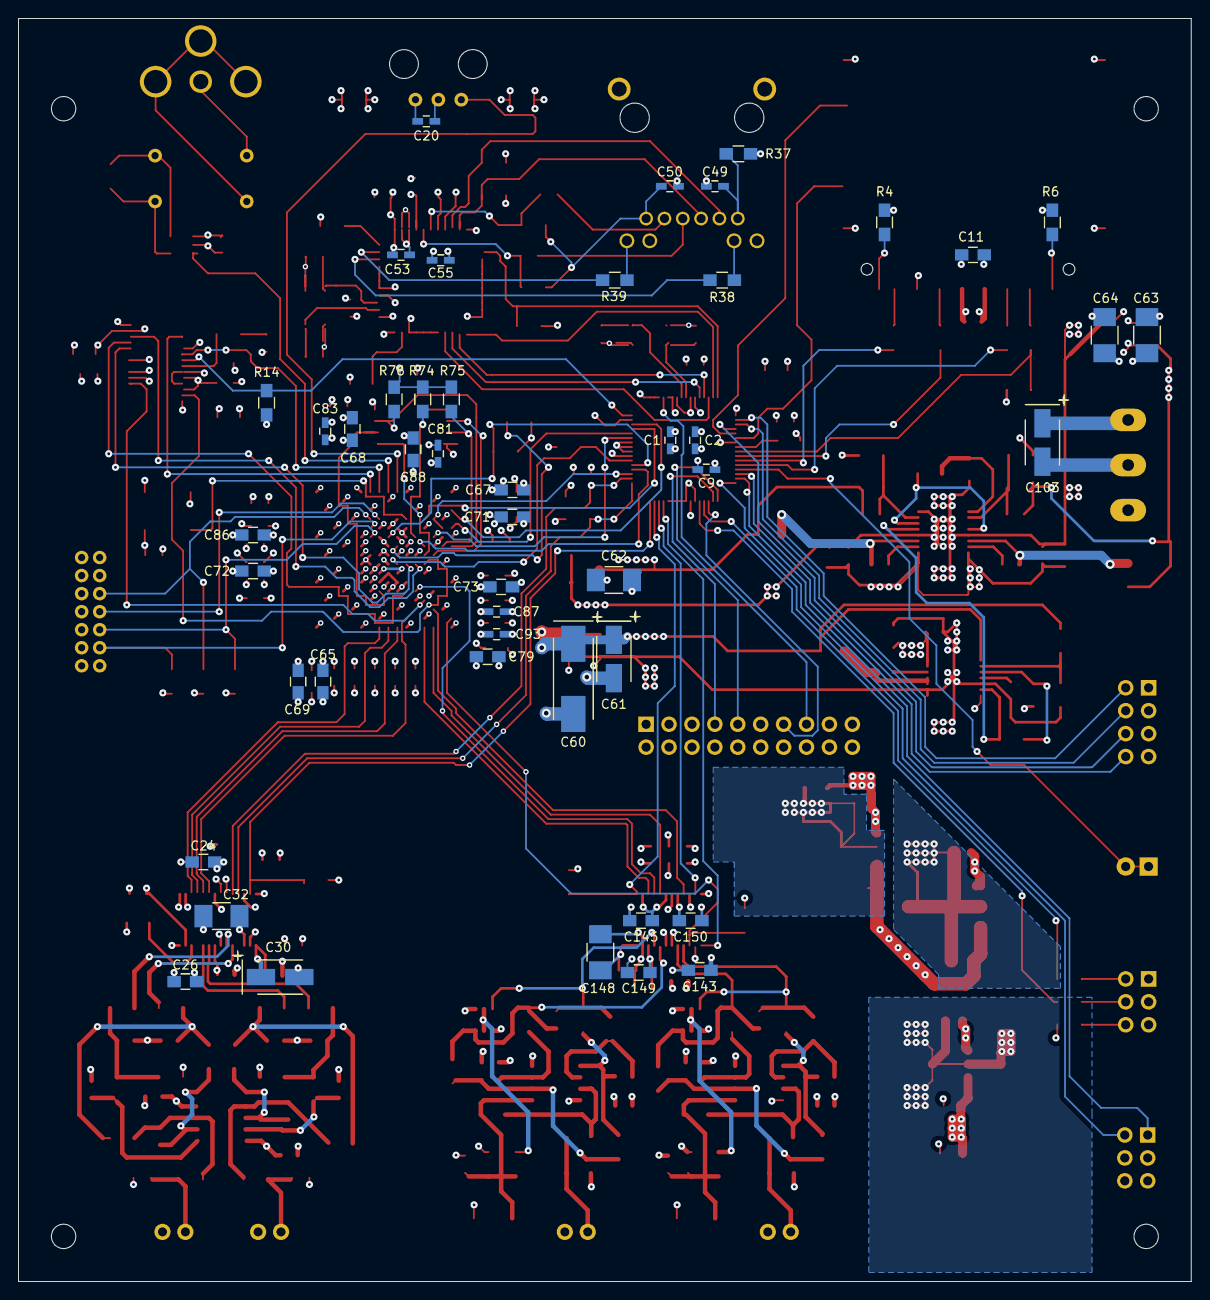
[picture p22: board preamp.kicad_pcb from below]

Board: 4 copper layers, 130.0 x 140.0 mm, 275 parts (47 on the bottom side), 166 nets.

Other parts of the board:
MountingHole_2-7mm, MountingHole_2-7mm#2, MountingHole_2-7mm#3, MountingHole_2-7mm#4: VAL**; MountingHole_2-7mm
