djupdal/asd-amp/asd_pa_1/poweramp.kicad_pcb

## KiCad design asd_pa_1/poweramp.kicad_pcb (2015-04-14)

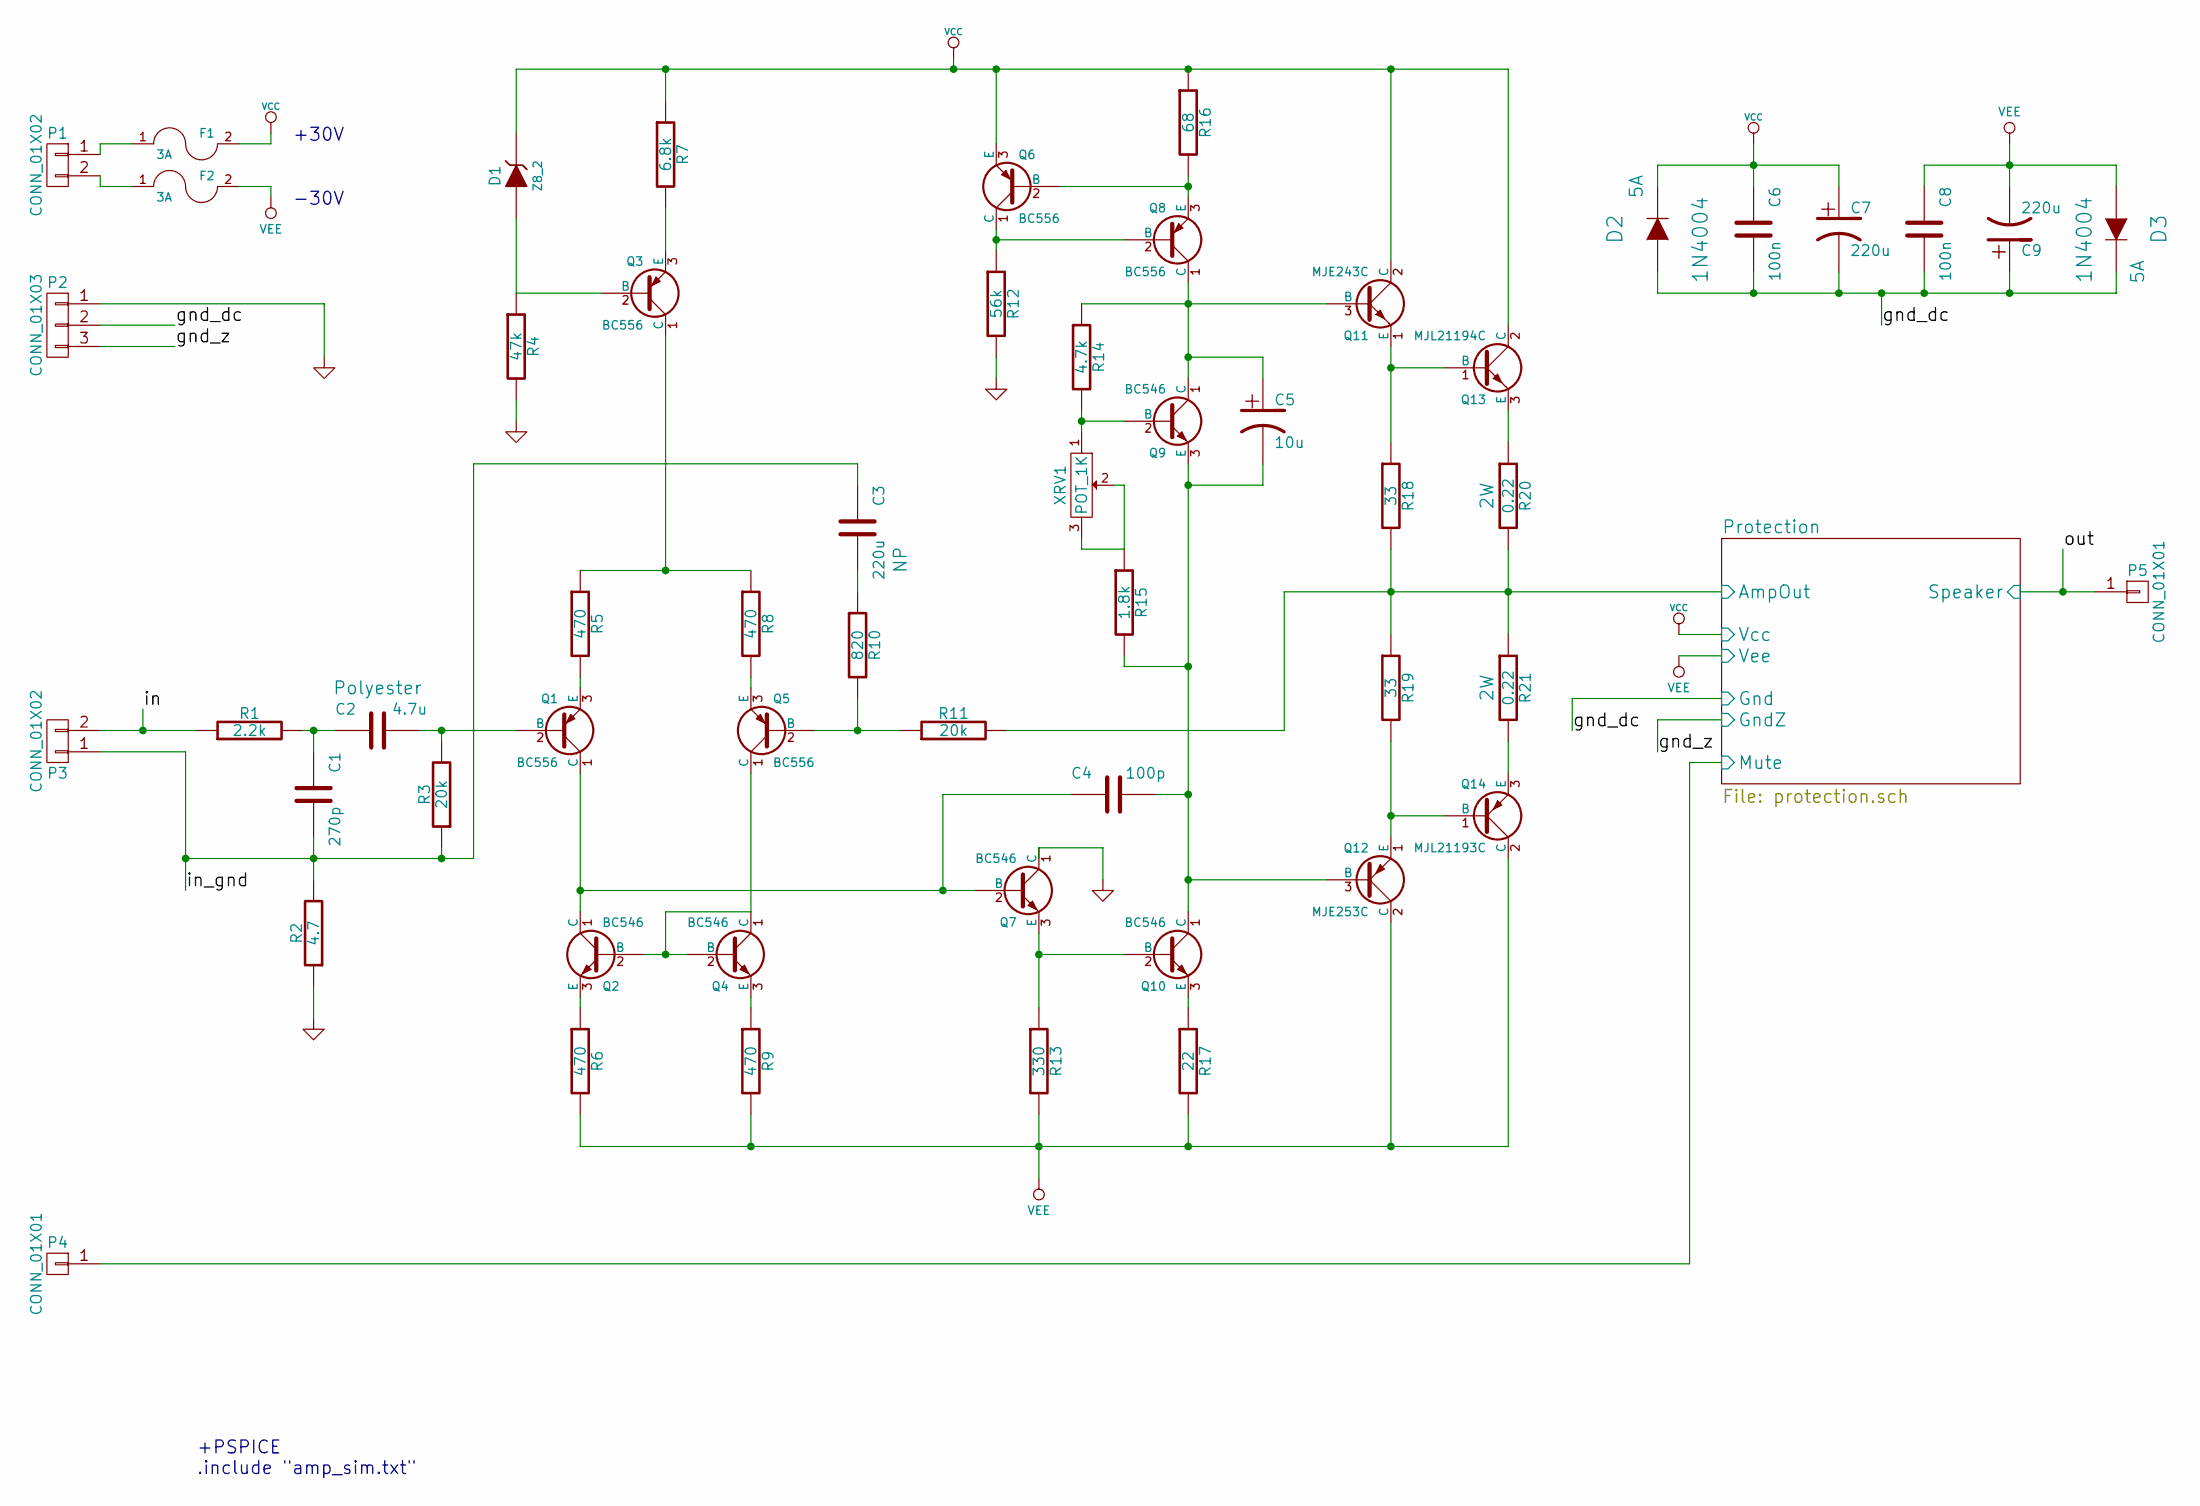
[picture p23: schematic poweramp.sch, AsD PA 1 Amplifier Circuit]

Parts:
C1: 270p; Capacitor7x2.5RM5
C2: 4.7u; Kemet_4.7u_Polyester
C3: 220u; 220u_NP
C4: 100p; Capacitor7x2.5RM5
C5: 10u; Capacitor5x11RM2.5
C6, C8: 100n; Capacitor7x2.5RM5
C7, C9: 220u; Capacitor10x25RM2.5
D1: Z8_2; Diode_DO-41_SOD81_Horizontal_RM10
D2, D3: 1N4004; Diode_DO-41_SOD81_Horizontal_RM10
F1, F2: 3A; Resistor_Horizontal_RM10mm
P1: CONN_01X02; Terminal_Block_2_5mm
P2: CONN_01X03; Terminal_Block_3_5mm
P3: CONN_01X02; Terminal_Block_2_2.5mm
P4: CONN_01X01; Pin_Header_Straight_1x01
P5: CONN_01X01; Screw_Terminal
Q1, Q3, Q5, Q6, Q8: BC556; TO-92-Free-inline-narrow-oval
Q2, Q4, Q7, Q9, Q10: BC546; TO-92-Free-inline-narrow-oval
Q11: MJE243C; TO-220_Neutral123_Vertical
Q12: MJE253C; TO-220_Neutral123_Vertical
Q13: MJL21194C; TO-247_Vertical_Neutral123
Q14: MJL21193C; TO-247_Vertical_Neutral123
R1: 2.2k; Resistor_Horizontal_RM10mm
R2: 4.7; Resistor_Horizontal_RM10mm
R3, R11: 20k; Resistor_Horizontal_RM10mm
R4: 47k; Resistor_Horizontal_RM10mm
R5, R6, R8, R9: 470; Resistor_Horizontal_RM10mm
R7: 6.8k; Resistor_Horizontal_RM10mm
R10: 820; Resistor_Horizontal_RM10mm
R12: 56k; Resistor_Horizontal_RM10mm
R13: 330; Resistor_Horizontal_RM10mm
R14: 4.7k; Resistor_Horizontal_RM10mm
R15: 1.8k; Resistor_Horizontal_RM10mm
R16: 68; Resistor_Horizontal_RM10mm
R17: 22; Resistor_Horizontal_RM10mm
R18, R19: 33; Resistor_Horizontal_RM10mm
R20, R21: 0.22; Resistor_Horizontal_RM20mm
XRV1: POT_1K; Potentiometer_Bourns_3296W_3-8Zoll_Inline_ScrewUp

Connections:
/Protection/AmpOut: R11.2, R18.2, R19.1, R20.2, R21.1; also elsewhere on the board
/Protection/Gnd: C6.2, C7.2, C8.2, C9.1, D2.1 (A), D3.2 (K), P2.2; also elsewhere on the board
/Protection/GndZ: P2.3; also elsewhere on the board
/Protection/Mute: P4.1; also elsewhere on the board
/Protection/Speaker: P5.1; also elsewhere on the board
/in: P3.2, R1.1
/in_gnd: C1.2, C3.1, P3.1, R2.2, R3.1
GND: P2.1, Q7.1 (C), R2.1, R4.2, R12.2
unnamed: C1.1, C2.1, R1.2
unnamed: C2.2, Q1.2 (B), R3.2
unnamed: C3.2, R10.1
unnamed: C4.1, Q1.1 (C), Q2.1 (C), Q7.2 (B)
unnamed: C4.2, C5.2, Q9.3 (E), Q10.1 (C), Q12.3 (B), R15.2
unnamed: C5.1, Q8.1 (C), Q9.1 (C), Q11.3 (B), R14.1
unnamed: D1.1 (A), Q3.2 (B), R4.1
unnamed: F1.1, P1.1
unnamed: F2.1, P1.2
unnamed: Q1.3 (E), R5.2
unnamed: Q2.2 (B), Q4.1 (C), Q4.2 (B), Q5.1 (C)
unnamed: Q2.3 (E), R6.1
unnamed: Q3.1 (C), R5.1, R8.1
unnamed: Q3.3 (E), R7.2
unnamed: Q4.3 (E), R9.1
unnamed: Q5.2 (B), R10.2, R11.1
unnamed: Q5.3 (E), R8.2
unnamed: Q6.1 (C), Q8.2 (B), R12.1
unnamed: Q6.2 (B), Q8.3 (E), R16.2
unnamed: Q9.2 (B), R14.2, XRV1.1
unnamed: Q7.3 (E), Q10.2 (B), R13.1
unnamed: Q10.3 (E), R17.1
unnamed: Q11.1 (E), Q13.1 (B), R18.1
unnamed: Q12.1 (E), Q14.1 (B), R19.2
unnamed: Q13.3 (E), R20.1
unnamed: Q14.3 (E), R21.2
unnamed: R15.1, XRV1.2, XRV1.3
VCC: C6.1, C7.1, D1.2 (K), D2.2 (K), F1.2, Q6.3 (E), Q11.2 (C), Q13.2 (C), R7.1, R16.1; also elsewhere on the board
VEE: C8.1, C9.2, D3.1 (A), F2.2, Q12.2 (C), Q14.2 (C), R6.2, R9.2, R13.2, R17.2; also elsewhere on the board

Notes on the sheet:
-30V
+30V
+PSPICE .include "amp_sim.txt"
