djupdal/asd-amp/asd_pa_1/poweramp.kicad_pcb

## KiCad design asd_pa_1/poweramp.kicad_pcb (continued)

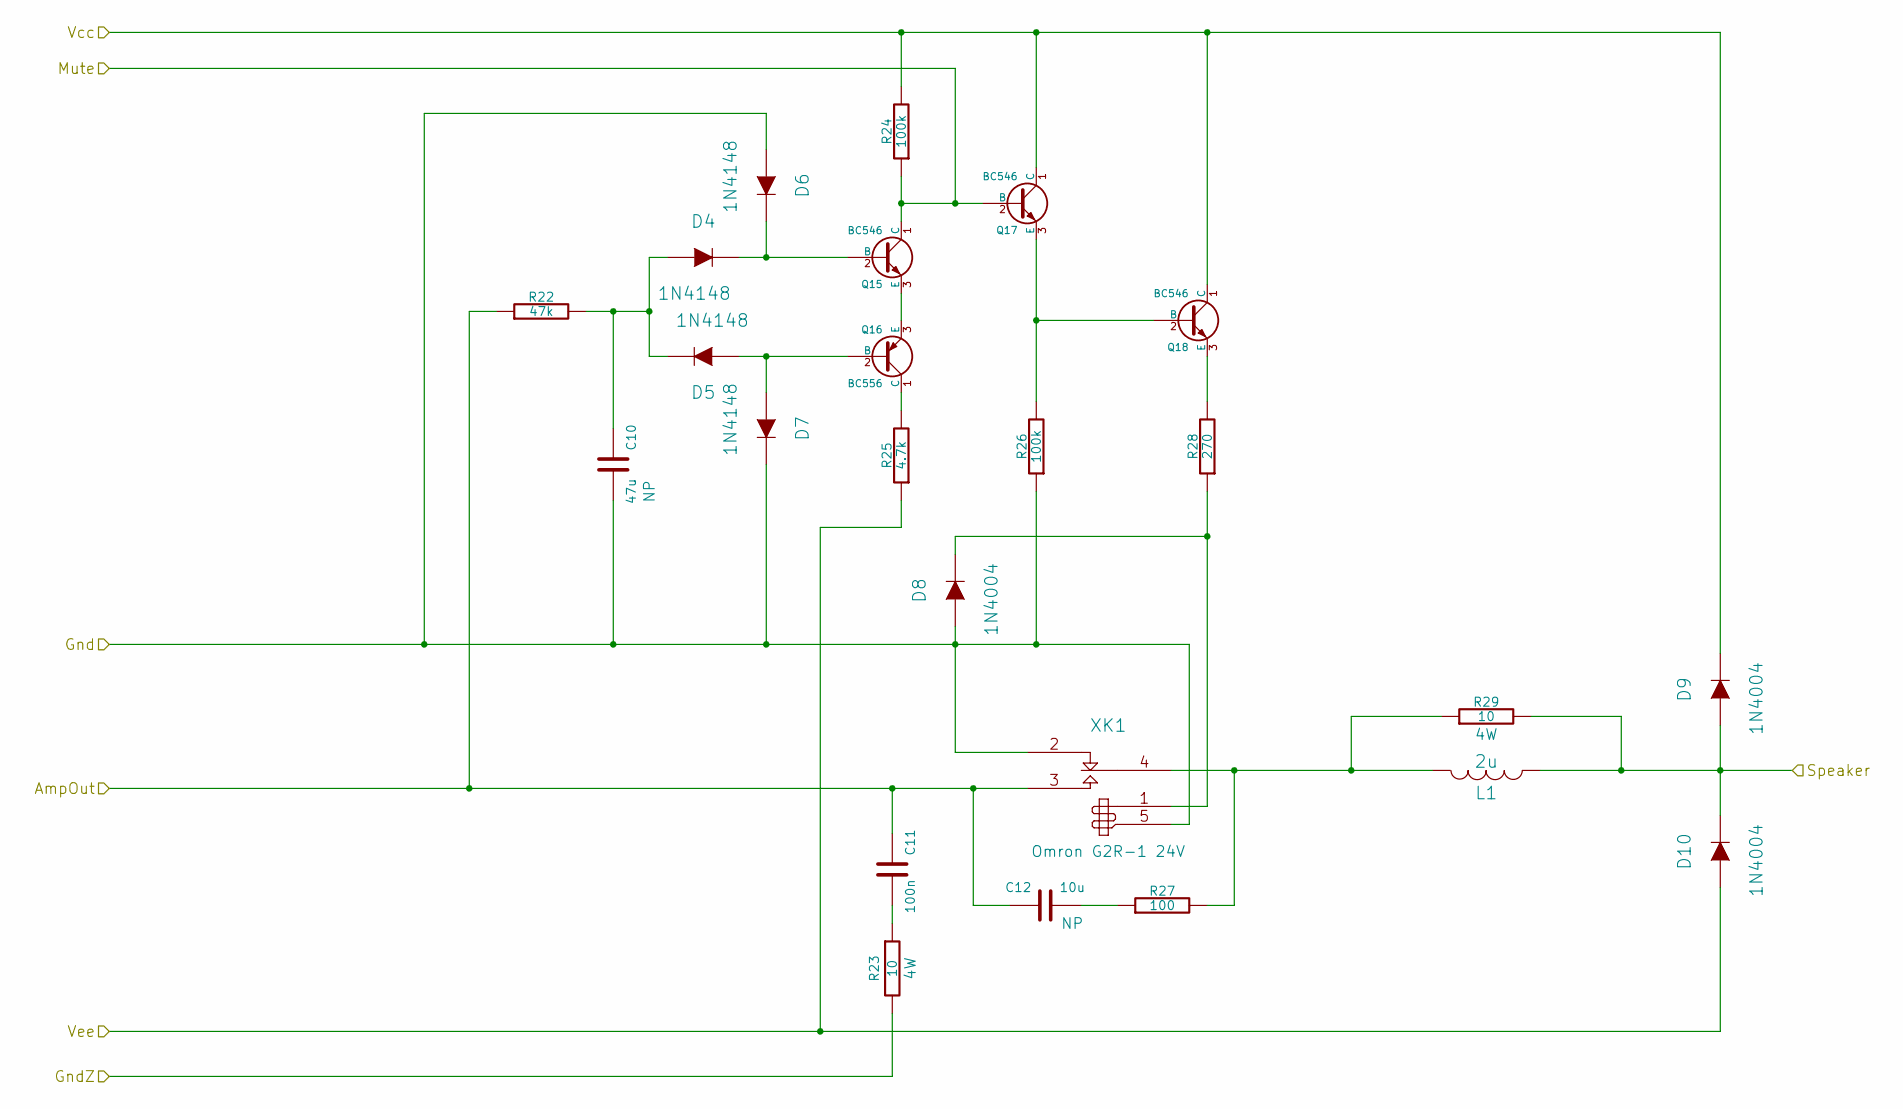
[picture p24: schematic protection.sch, AsD PA 1 Protection Circuit]

Parts:
C10: 47u; 47u_NP
C11: 100n; Capacitor7x2.5RM5
C12: 10u; 47u_NP
D4, D5, D6, D7: 1N4148; Diode_DO-35_SOD27_Horizontal_RM10
D8, D9, D10: 1N4004; Diode_DO-41_SOD81_Horizontal_RM10
L1: 2u; Inductor_AirCore_2uH
Q15, Q17, Q18: BC546; TO-92-Free-inline-narrow-oval
Q16: BC556; TO-92-Free-inline-narrow-oval
R22: 47k; Resistor_Horizontal_RM10mm
R23, R29: 10; Resistor_Horizontal_RM15mm
R24, R26: 100k; Resistor_Horizontal_RM10mm
R25: 4.7k; Resistor_Horizontal_RM10mm
R27: 100; Resistor_Horizontal_RM10mm
R28: 270; Resistor_Horizontal_RM10mm
XK1: RELAY_SPDT; Omron_G2R_SPDT

Connections:
/Protection/AmpOut: C11.1, C12.1, R22.1, XK1.3 (T1); also elsewhere on the board
/Protection/Gnd: C10.2, D6.1 (A), D7.2 (K), D8.1 (A), R26.1, XK1.2 (R1), XK1.5; also elsewhere on the board
/Protection/GndZ: R23.2; also elsewhere on the board
/Protection/Mute: Q15.1 (C), Q17.2 (B), R24.1; also elsewhere on the board
/Protection/Speaker: D9.1 (A), D10.2 (K), L1.2, R29.2; also elsewhere on the board
unnamed: C10.1, D4.1 (A), D5.2 (K), R22.2
unnamed: C11.2, R23.1
unnamed: C12.2, R27.1
unnamed: D4.2 (K), D6.2 (K), Q15.2 (B)
unnamed: D5.1 (A), D7.1 (A), Q16.2 (B)
unnamed: D8.2 (K), R28.1, XK1.1
unnamed: L1.1, R27.2, R29.1, XK1.4 (C1)
unnamed: Q15.3 (E), Q16.3 (E)
unnamed: Q16.1 (C), R25.2
unnamed: Q17.3 (E), Q18.2 (B), R26.2
unnamed: Q18.3 (E), R28.2
VCC: D9.2 (K), Q17.1 (C), Q18.1 (C), R24.2; also elsewhere on the board
VEE: D10.1 (A), R25.1; also elsewhere on the board

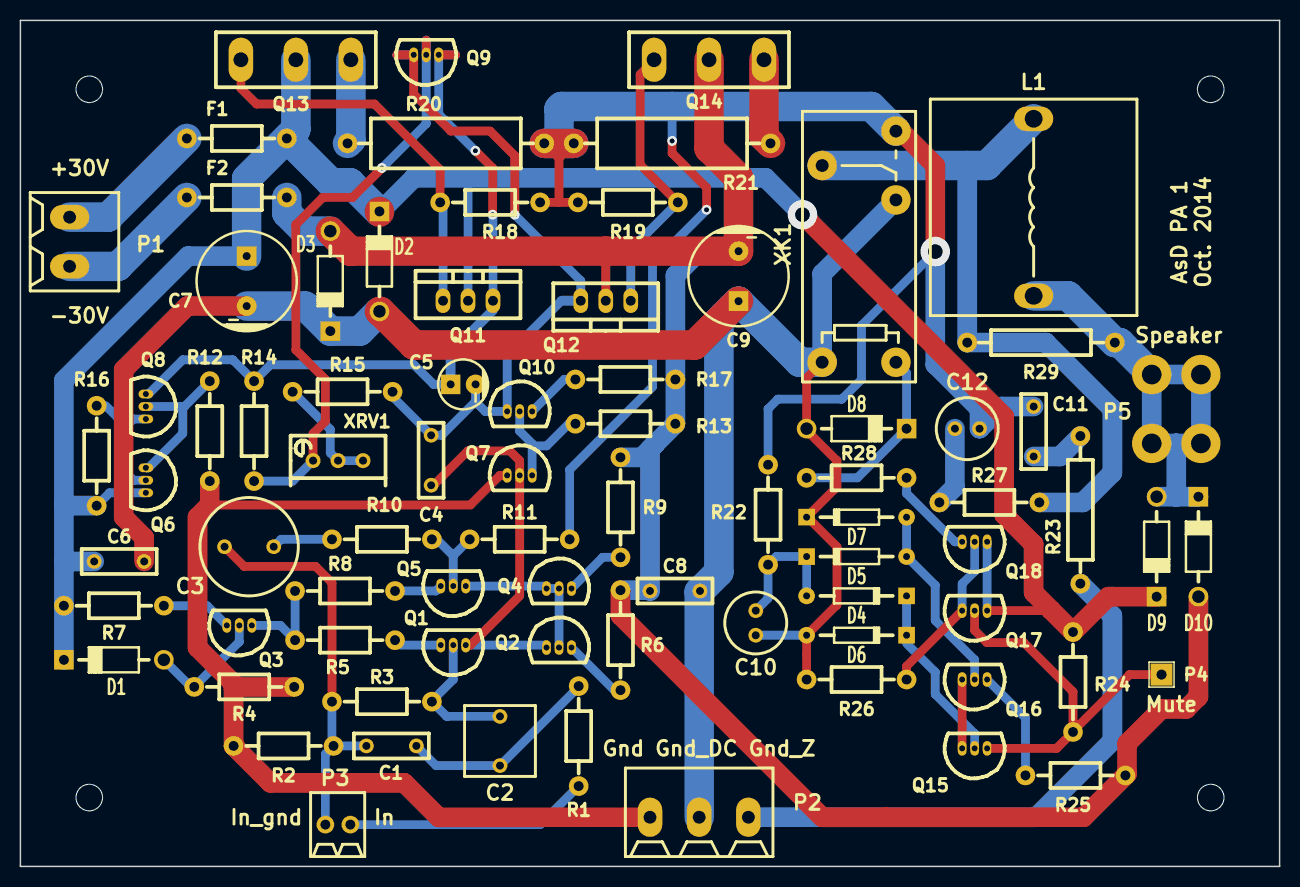
[picture p25: board poweramp.kicad_pcb from above]

Board: 2 copper layers, 128.0 x 86.0 mm, 83 parts (0 on the bottom side), 48 nets.

Other parts of the board:
MH: MountingHole_2-7mm_RevA_Date21Jun2010; MountingHole_2-7mm
MH#2, MH#3, MH#4: MountingHole_2-7mm_RevA_Date21Jun2010; MountingHole_2-7mm
