djupdal/asd-amp/(commit log)

2015-05-10 Does not close socket immediately
2015-05-12 Led off when muted
2016-01-31 FPGA audio path framework finished. Added gain module
2017-04-02 Updated schematics and PCB. Removed some minor errors with the first prototype.
    [EFM32GG.sch, FPGA.sch, adc.sch, dac.sch, eth.sch, fpga_power.sch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]
